WaltTeb/BareTag_Tool_Tracker/PCB/tag/tagconnect/CHECK CAREFULLY AGAINST TAG-CONNECT SPEC AND USE AT YOUR OWN RISK/Ultiboard/Transcode Report.txt

   ---- Transcoding 'C:\Users\neil\Documents\Tag-Connect\Footprint Decals\To Check\Ultiboard\TC2030-MCP-NL - Silkscreen Top.gbr' ----   Sat Aug 06 12:30:12 2011

D10   --> D100
D11   --> D101
D12   --> D102
-----------------------------------------------------------------
