WaltTeb/BareTag_Tool_Tracker/PCB/anchor/footprints/150060RS75000/WL-SMCW_0603.step

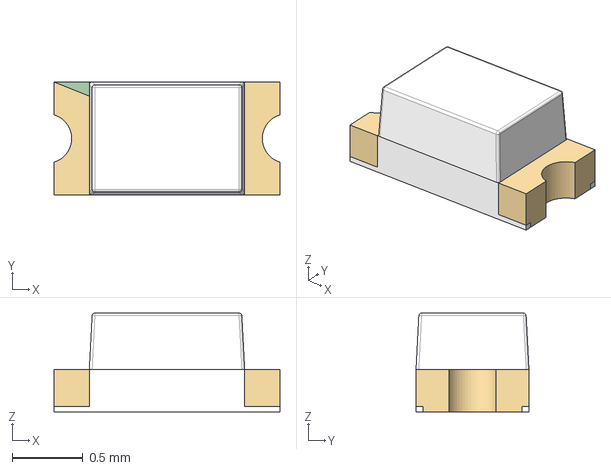
[picture p7: CAD file, 2024-11-17]
PCB/anchor/footprints/150060RS75000/WL-SMCW_0603.step
1.60 x 0.8 x 0.7 mm
