WaltTeb/BareTag_Tool_Tracker/PCB/anchor/footprints/APHBM2012LSURKSYKC/APHBM2012.STEP

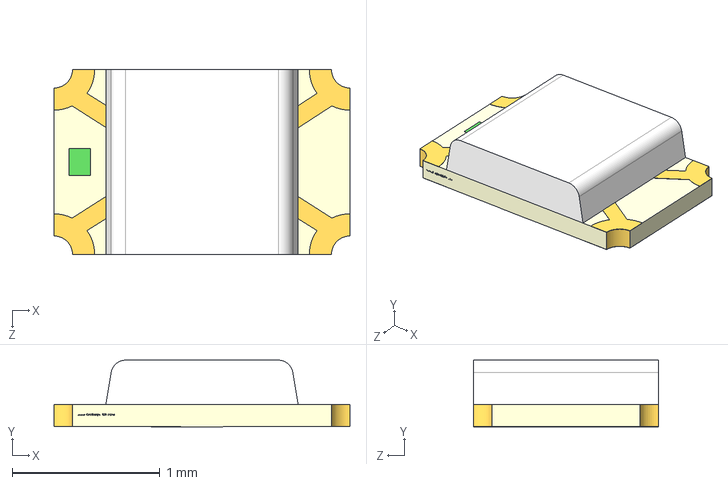
[picture p8: CAD file, 2024-11-17]
PCB/anchor/footprints/APHBM2012LSURKSYKC/APHBM2012.STEP
2.00 x 0.451 x 1.25 mm
