WaltTeb/BareTag_Tool_Tracker/PCB/anchor/footprints/DWM3001C_library/DWM3001C_library/Altium/DWM3001C.step

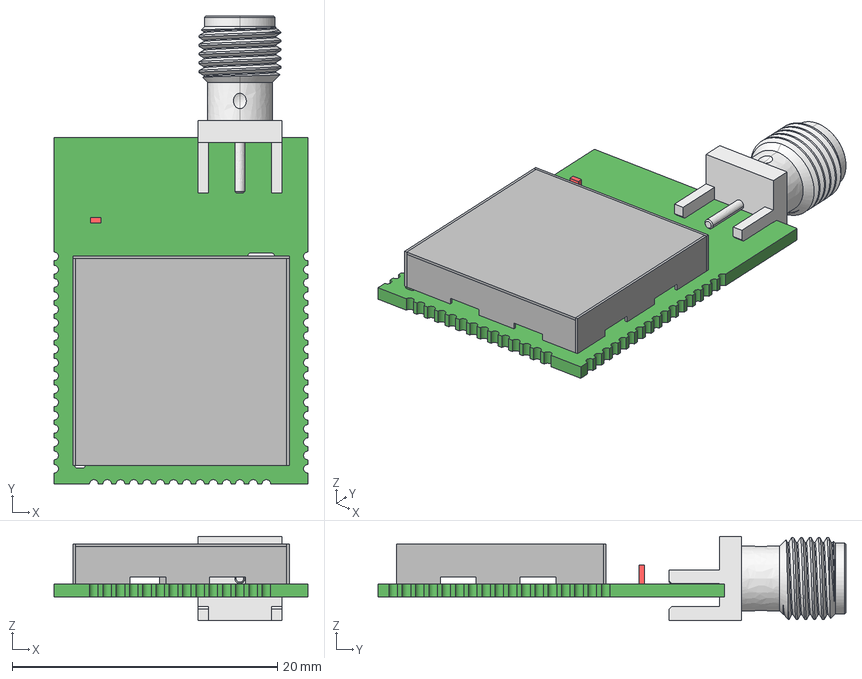
[picture p9: CAD file, 2024-11-17]
PCB/anchor/footprints/DWM3001C_library/DWM3001C_library/Altium/DWM3001C.step
19.1 x 35.3 x 6.35 mm
Open_CASCADE_STEP_translator_6.8_5.1.1.1
DWM3001_shield_RGB8421504
DWM3001_shield_RGB8421505
DWM3001_shield_RGB8421506
DWM3001_shield_RGB8421507
DWM3001_shield_RGB8421508
_32322_3d_model_file
Extruded
