WaltTeb/BareTag_Tool_Tracker/PCB/anchor/footprints/GRM1555C1H470JA01D/GRM1555C1H470JA01D.step

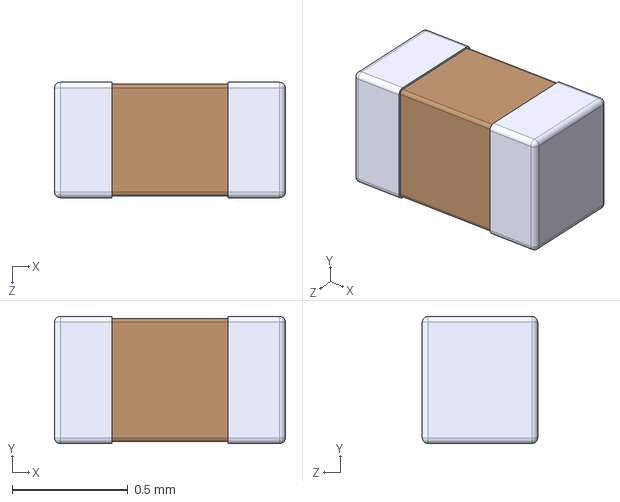
[picture p10: CAD file, 2024-11-17]
PCB/anchor/footprints/GRM1555C1H470JA01D/GRM1555C1H470JA01D.step
1.00 x 0.55 x 0.5 mm
