WaltTeb/BareTag_Tool_Tracker/PCB/anchor/footprints/GRM155R60J106ME05D/GRM155R60J106ME05D.step

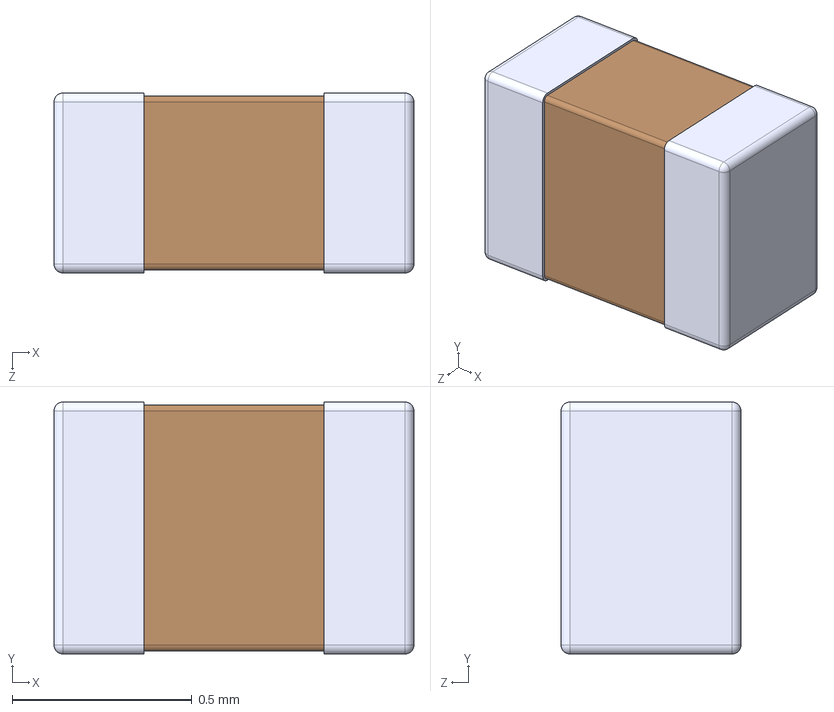
[picture p11: CAD file, 2024-11-17]
PCB/anchor/footprints/GRM155R60J106ME05D/GRM155R60J106ME05D.step
1.00 x 0.7 x 0.5 mm
