WaltTeb/BareTag_Tool_Tracker/PCB/anchor/footprints/RC0402FR_07100KL/RC0402FR-07100KL.step

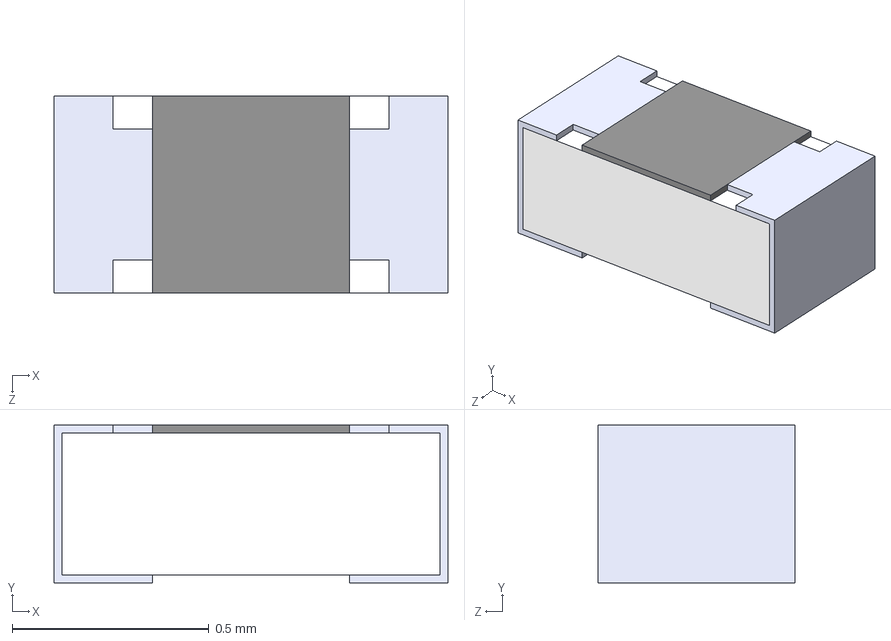
[picture p12: CAD file, 2024-11-17]
PCB/anchor/footprints/RC0402FR_07100KL/RC0402FR-07100KL.step
1 x 0.4 x 0.5 mm
