WaltTeb/BareTag_Tool_Tracker/PCB/anchor/footprints/RK73B1ETTP182J/RK73B1ETTP182J.step

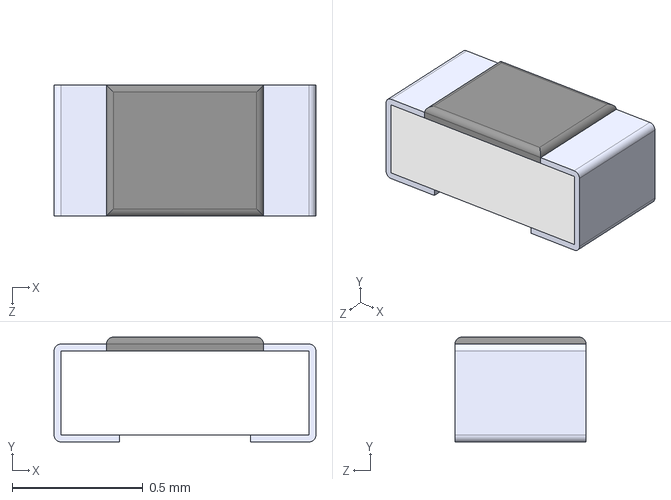
[picture p13: CAD file, 2024-11-17]
PCB/anchor/footprints/RK73B1ETTP182J/RK73B1ETTP182J.step
1.00 x 0.4 x 0.5 mm
