WaltTeb/BareTag_Tool_Tracker/PCB/anchor/footprints/RT0402BRD071K5L/RT0402BRD071K5L.step

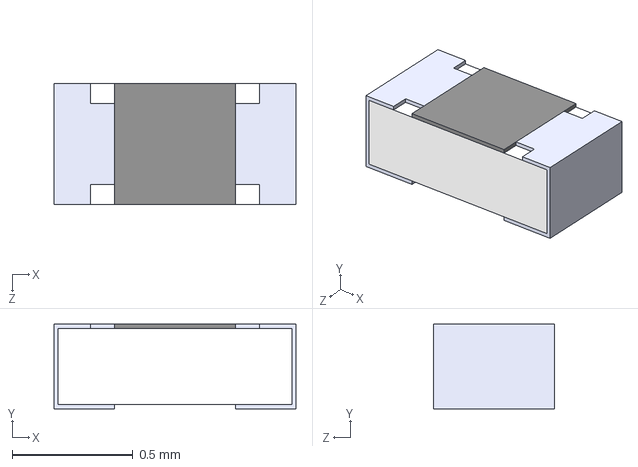
[picture p14: CAD file, 2024-11-17]
PCB/anchor/footprints/RT0402BRD071K5L/RT0402BRD071K5L.step
1 x 0.35 x 0.5 mm
