WaltTeb/BareTag_Tool_Tracker/PCB/anchor/footprints/S2B_PH_SM4_TB/S2B-PH-SM4-TB.step

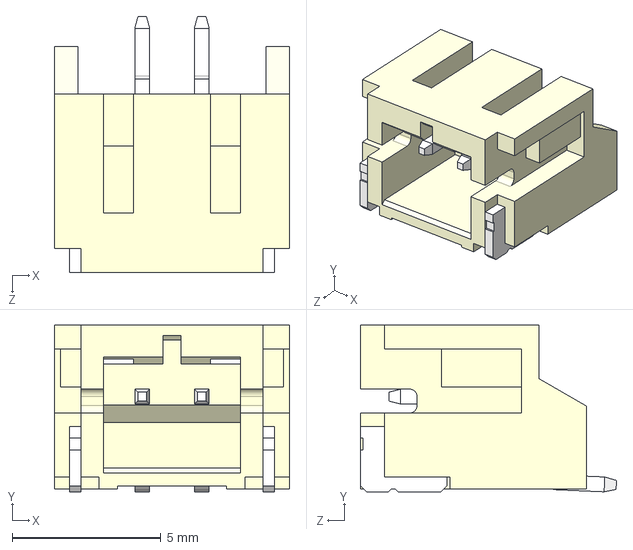
[picture p15: CAD file, 2024-11-17]
PCB/anchor/footprints/S2B_PH_SM4_TB/S2B-PH-SM4-TB.step
7.90 x 5.60 x 8.60 mm
