WaltTeb/BareTag_Tool_Tracker/PCB/anchor/footprints/TL3315NF160Q/TL3315NF160Q.step

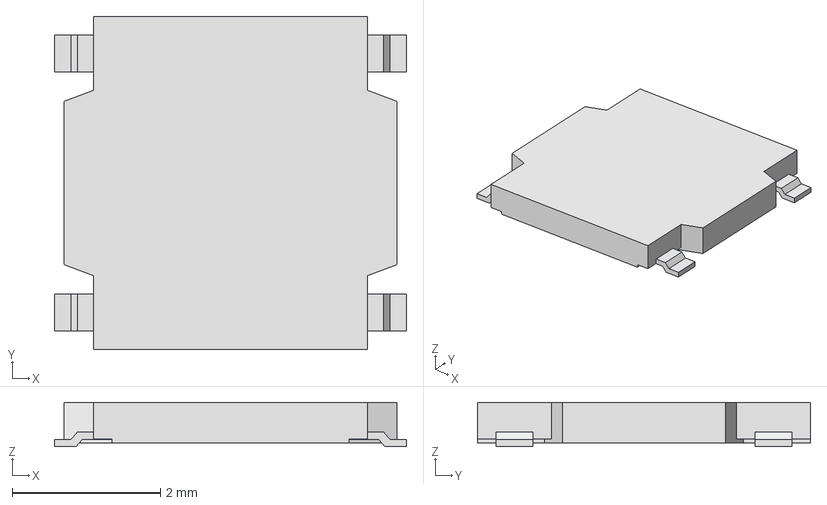
[picture p16: CAD file, 2024-11-17]
PCB/anchor/footprints/TL3315NF160Q/TL3315NF160Q.step
4.75 x 4.50 x 0.6 mm
