WaltTeb/BareTag_Tool_Tracker/PCB/anchor/footprints/TSM_102_01_L_SV/TSM-102-01-X-SV.step

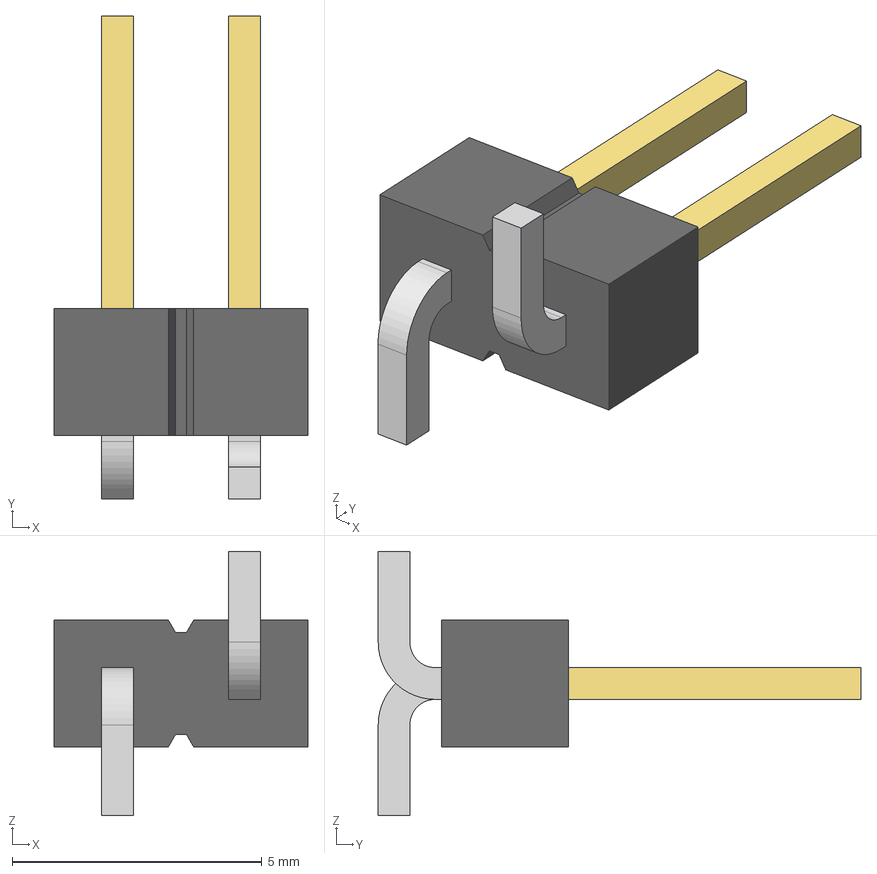
[picture p17: CAD file, 2024-11-17]
PCB/anchor/footprints/TSM_102_01_L_SV/TSM-102-01-X-SV.step
5.08 x 9.65 x 5.28 mm
TSM-102-01-SV_body
T-1S6-16-L(-01-2-SV)
T-1S6-16-L(-01-2-SV)2
