WaltTeb/BareTag_Tool_Tracker/PCB/component_files/KiCADv6/1734028_1/c-1734028-1-c-3d.stp

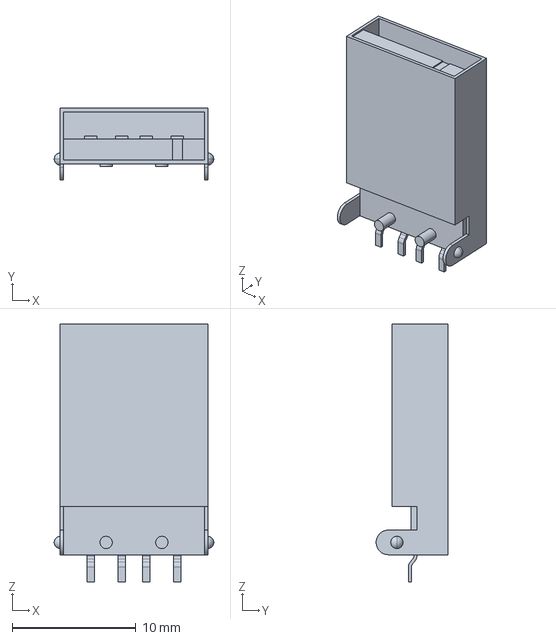
[picture p18: CAD file, 2025-02-01]
PCB/component_files/KiCADv6/1734028_1/c-1734028-1-c-3d.stp
12.9 x 5.80 x 20.9 mm
