WaltTeb/BareTag_Tool_Tracker/PCB/component_files/KiCADv6/RYLR998.stp

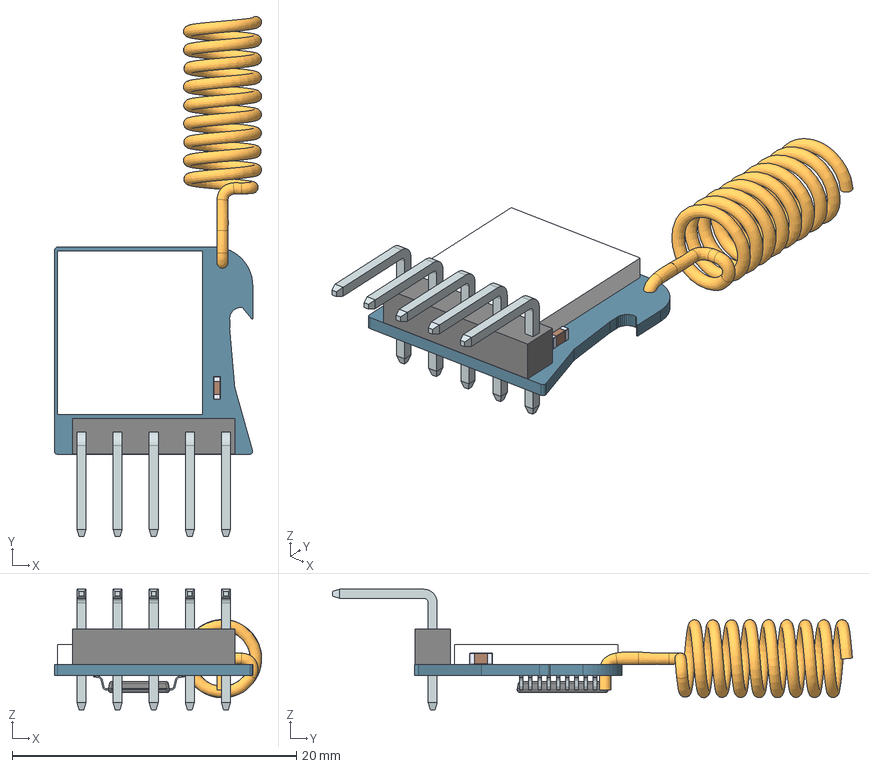
[picture p19: CAD file, 2025-02-01]
PCB/component_files/KiCADv6/RYLR998.stp
14.6 x 36.6 x 8.49 mm
