WaltTeb/BareTag_Tool_Tracker/PCB/tag/LIB_PRT-12807/PRT-12807/3D/PRT-12807.stp

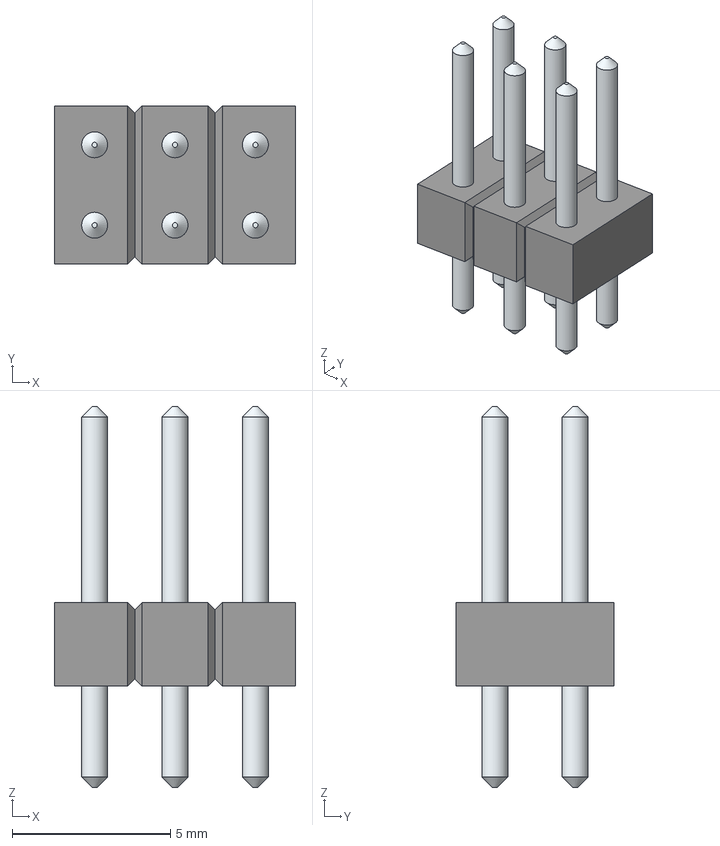
[picture p20: CAD file, 2025-01-01]
PCB/tag/LIB_PRT-12807/PRT-12807/3D/PRT-12807.stp
7.62 x 5.00 x 12.0 mm
LeadsArray
