WaltTeb/BareTag_Tool_Tracker/PCB/tag/LIB_SM02B-SRSS-TB_LF__SN_/SM02B-SRSS-TB_LF__SN_/3D/SM02B-SRSS-TB_LF__SN_.stp

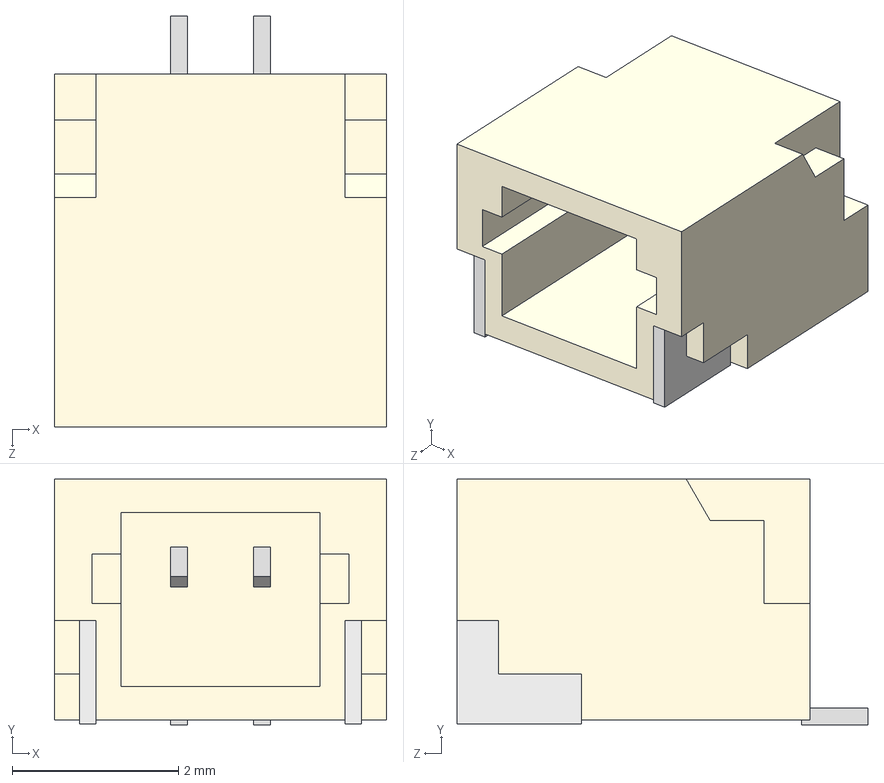
[picture p21: CAD file, 2025-01-01]
PCB/tag/LIB_SM02B-SRSS-TB_LF__SN_/SM02B-SRSS-TB_LF__SN_/3D/SM02B-SRSS-TB_LF__SN_.stp
4.00 x 2.96 x 4.95 mm
