WaltTeb/BareTag_Tool_Tracker/PCB/tag/SM02B-SRSS-TB-LF--SN---3DModel-STEP-56544.STEP

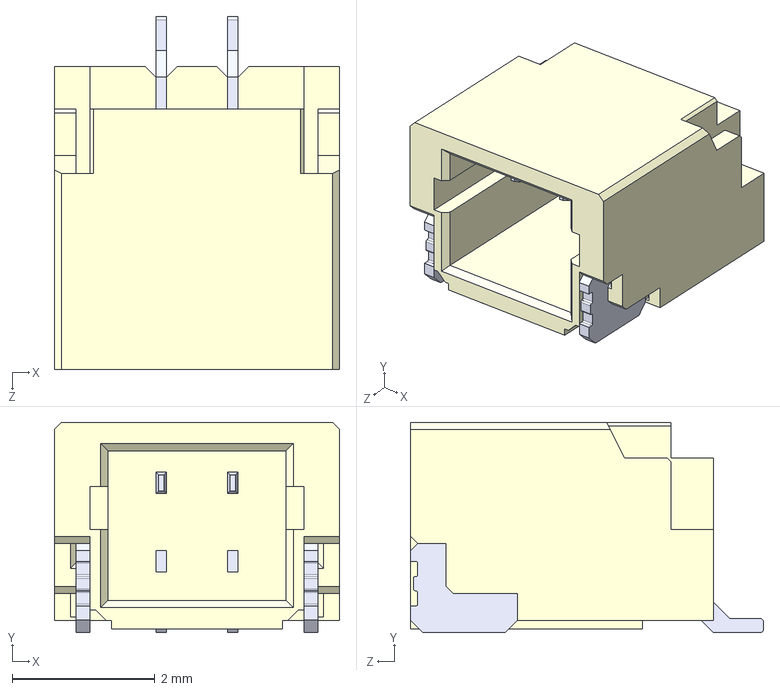
[picture p22: CAD file, 2025-01-01]
PCB/tag/SM02B-SRSS-TB-LF--SN---3DModel-STEP-56544.STEP
4.00 x 2.95 x 4.95 mm
