WaltTeb/BareTag_Tool_Tracker/PCB/component_files/DDC0005A.stp

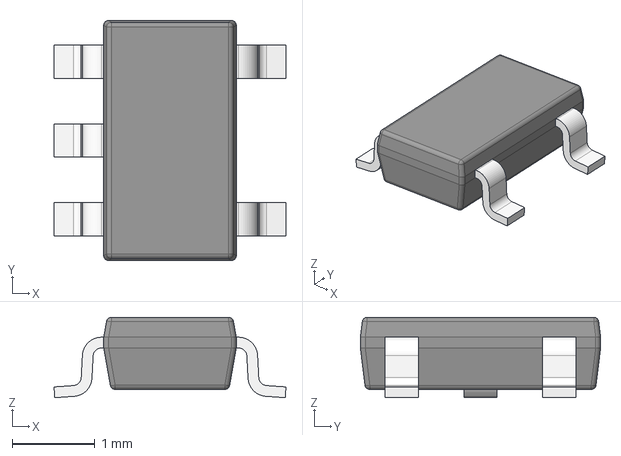
[picture p23: CAD file, 2024-10-23]
PCB/component_files/DDC0005A.stp
2.80 x 2.90 x 0.97 mm
BODY-SOT
LEAD-SOT x 5
