WaltTeb/BareTag_Tool_Tracker/(list of files, cad)

Other CAD files:
PCB/anchor/footprints/RC0402FR_07150RL/RC0402FR-07150RL.step
PCB/anchor/footprints/RC0402FR_07820KL/RC0402FR-07820KL.step
PCB/component_files/GRM155C80J225KE95D.step
PCB/component_files/KiCADv6/DWM3001C.step
PCB/tag/TL3315NFxxxQ.stp
PCB/anchor/footprints/TPS79933DDCR/TPS79933DDCR.step
PCB/component_files/54202-T0804LF.step
PCB/tag/LIB_PRT-12807/PRT-12807/Allegro/hdrv6w82p254_2x3_762x500x884p.psm
PCB/tag/LIB_PRT-12807/PRT-12807/DEHDL/prt_12807/chips/chips.prt
PCB/tag/LIB_SM02B-SRSS-TB_LF__SN_/SM02B-SRSS-TB_LF__SN_/Allegro/sm02bsrsstblfsn.psm
PCB/tag/LIB_SM02B-SRSS-TB_LF__SN_/SM02B-SRSS-TB_LF__SN_/DEHDL/sm02b_srss_tb_lf__sn_/chips/chips.prt
PCB/tag/tagconnect/CHECK CAREFULLY AGAINST TAG-CONNECT SPEC AND USE AT YOUR OWN RISK/Cadence/TC2030_Cadence_PCB Editor/Cadence Orcad PCB Editor/tc2030-mcp-nl.psm
PCB/tag/tagconnect/CHECK CAREFULLY AGAINST TAG-CONNECT SPEC AND USE AT YOUR OWN RISK/Cadence/TC2030_Cadence_PCB Editor/TC2030_Cadence_PCB Editor/tc2030-mcp-nl.psm
PCB/tag/tagconnect/CHECK CAREFULLY AGAINST TAG-CONNECT SPEC AND USE AT YOUR OWN RISK/Cadence/TC2030_Cadence_PCB Editor/TC2030_Cadence_PCB Editor/tc2030-mcp.psm
