WaltTeb/BareTag_Tool_Tracker/PCB/tag/tagconnect/CHECK CAREFULLY AGAINST TAG-CONNECT SPEC AND USE AT YOUR OWN RISK/Labcenter Proteus/Tag-Connect - CADCAM/Tag-Connect - CADCAM Bottom Solder Resist.TXT

G04 PROTEUS RS274X GERBER FILE*
%FSLAX24Y24*%
%MOIN*%
%ADD14C,0.1100*%
%ADD15C,0.0510*%
%ADD13C,0.0000*%
G54D14*
X+0Y+1000D03*
X+0Y-1000D03*
X+1250Y-1000D03*
X+1250Y+1000D03*
G54D15*
X+0Y+0D03*
X+2000Y+400D03*
X+2000Y-400D03*
X-150Y-3400D03*
X+1850Y-3000D03*
X+1850Y-3800D03*
G54D13*
X-1100Y-4990D02*
X+8850Y-4990D01*
X+8850Y+2170D01*
X-1100Y+2170D01*
X-1100Y-4990D01*
M00*
