WaltTeb/BareTag_Tool_Tracker/PCB/tag/tagconnect/CHECK CAREFULLY AGAINST TAG-CONNECT SPEC AND USE AT YOUR OWN RISK/Protel/tag_connect_TC2050/fotprint - CADCAM Top Solder Resist.TXT

G04 PROTEUS RS274X GERBER FILE*
%FSLAX24Y24*%
%MOIN*%
%ADD12C,0.0510*%
G54D12*
X+0Y+0D03*
X+500Y+0D03*
X+1000Y+0D03*
X+1500Y+0D03*
X+2000Y+0D03*
X+0Y-500D03*
X+500Y-500D03*
X+1000Y-500D03*
X+1500Y-500D03*
X+2000Y-500D03*
X+5500Y+0D03*
X+6000Y+0D03*
X+6500Y+0D03*
X+7000Y+0D03*
X+7500Y+0D03*
X+5500Y-500D03*
X+6000Y-500D03*
X+6500Y-500D03*
X+7000Y-500D03*
X+7500Y-500D03*
M00*
