WaltTeb/BareTag_Tool_Tracker/PCB/tag/tagconnect/CHECK CAREFULLY AGAINST TAG-CONNECT SPEC AND USE AT YOUR OWN RISK/Labcenter Proteus/Tag-Connect - CADCAM/Tag-Connect - CADCAM Top Solder Resist.TXT

G04 PROTEUS RS274X GERBER FILE*
%FSLAX24Y24*%
%MOIN*%
%ADD14C,0.1100*%
%ADD15C,0.0510*%
%ADD16C,0.0410*%
%ADD13C,0.0000*%
G54D14*
X+0Y+1000D03*
X+0Y-1000D03*
X+1250Y-1000D03*
X+1250Y+1000D03*
G54D15*
X+0Y+0D03*
X+2000Y+400D03*
X+2000Y-400D03*
G54D16*
X+500Y+250D03*
X+500Y-250D03*
X+1000Y-250D03*
X+1500Y-250D03*
X+1500Y+250D03*
X+1000Y+250D03*
X+5050Y+250D03*
X+5050Y-250D03*
X+5550Y-250D03*
X+6050Y-250D03*
X+6050Y+250D03*
X+5550Y+250D03*
G54D15*
X-150Y-3400D03*
X+1850Y-3000D03*
X+1850Y-3800D03*
G54D16*
X+350Y-3150D03*
X+350Y-3650D03*
X+850Y-3650D03*
X+1350Y-3650D03*
X+1350Y-3150D03*
X+850Y-3150D03*
X+5100Y-3150D03*
X+5100Y-3650D03*
X+5600Y-3650D03*
X+6100Y-3650D03*
X+6100Y-3150D03*
X+5600Y-3150D03*
G54D13*
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
