WaltTeb/BareTag_Tool_Tracker/PCB/tag/tagconnect/CHECK CAREFULLY AGAINST TAG-CONNECT SPEC AND USE AT YOUR OWN RISK/Proteus/Proteus/gerber/freetag - CADCAM Bottom Solder Resist.TXT

G54D15*
X-2000Y-7000D02*
X+14750Y-7000D01*
X+14750Y+3750D01*
X-2000Y+3750D01*
X-2000Y-7000D01*
M00*
