WaltTeb/BareTag_Tool_Tracker/PCB/tag/tagconnect/CHECK CAREFULLY AGAINST TAG-CONNECT SPEC AND USE AT YOUR OWN RISK/Proteus/Proteus/gerber/freetag - CADCAM Top Solder Resist.TXT

G54D11*
X+500Y-250D03*
X+500Y+250D03*
X+1000Y-250D03*
X+1000Y+250D03*
X+1500Y-250D03*
X+1500Y+250D03*
X+500Y-4500D03*
X+500Y-4000D03*
X+1000Y-4500D03*
X+1000Y-4000D03*
X+1500Y-4500D03*
X+1500Y-4000D03*
X+5250Y+750D03*
G54D16*
X+5250Y+2000D03*
X+1250Y+2750D03*
G54D15*
X-2000Y-7000D02*
X+14750Y-7000D01*
X+14750Y+3750D01*
X-2000Y+3750D01*
X-2000Y-7000D01*
X+4250Y-250D02*
X+6750Y-250D01*
X+6750Y+1500D01*
X+4250Y+1500D01*
X+4250Y-250D01*
M00*
