WaltTeb/BareTag_Tool_Tracker/PCB/tag/tagconnect/CHECK CAREFULLY AGAINST TAG-CONNECT SPEC AND USE AT YOUR OWN RISK/Cadence/TC2030_Cadence_PCB Editor/Cadence Orcad PCB Editor/TESTBOARD/LAYOUT.pdf

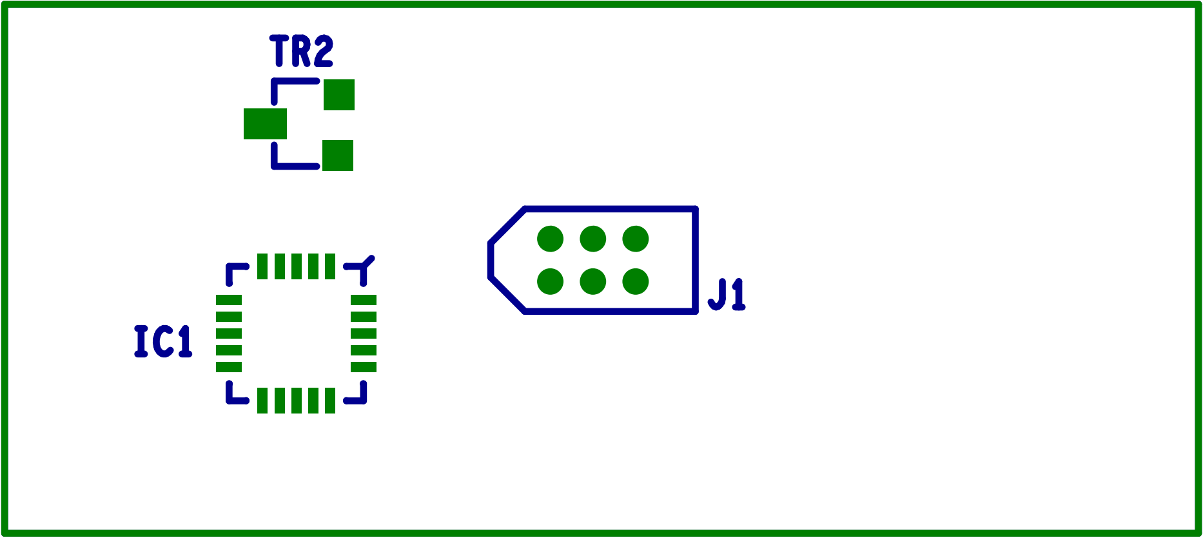
[picture p24: figure]
