WaltTeb/BareTag_Tool_Tracker/PCB/tag/tagconnect/CHECK CAREFULLY AGAINST TAG-CONNECT SPEC AND USE AT YOUR OWN RISK/Cadence/TC2030_Cadence_PCB Editor/Cadence Orcad PCB Editor/readme.txt

This footprint is for Tag Connect TC2030-MCP-NL connector.
For Cadence Orcad PCB Editor 16.2.
From phil@dektron.com
www.dektron.com
24 Aug 2009
