WaltTeb/BareTag_Tool_Tracker/PCB/tag/tagconnect/CHECK CAREFULLY AGAINST TAG-CONNECT SPEC AND USE AT YOUR OWN RISK/Labcenter Proteus/Tag-Connect - CADCAM/Tag-Connect - CADCAM Bottom SMT Paste Mask.TXT

G04 PROTEUS RS274X GERBER FILE*
%FSLAX24Y24*%
%MOIN*%
%ADD13C,0.0000*%
G54D13*
X-1100Y-4990D02*
X+8850Y-4990D01*
X+8850Y+2170D01*
X-1100Y+2170D01*
X-1100Y-4990D01*
M00*
