WaltTeb/BareTag_Tool_Tracker/PCB/tag/tagconnect/CHECK CAREFULLY AGAINST TAG-CONNECT SPEC AND USE AT YOUR OWN RISK/PADS/ReadMe.txt

To import these Decals into PADS:

1. Open the Library Manager.
2. Select the library you want to import to.
3. Select Import... and choose the TC2030-MCP.d file.
