WaltTeb/BareTag_Tool_Tracker/PCB/tag/tagconnect/CHECK CAREFULLY AGAINST TAG-CONNECT SPEC AND USE AT YOUR OWN RISK/Labcenter Proteus/Tag-Connect - CADCAM/Tag-Connect - CADCAM Top Silk Screen.TXT

G04 PROTEUS RS274X GERBER FILE*
%FSLAX24Y24*%
%MOIN*%
%ADD13C,0.0000*%
G54D13*
X-1100Y-4990D02*
X+8850Y-4990D01*
X+8850Y+2170D01*
X-1100Y+2170D01*
X-1100Y-4990D01*
X+1990Y+900D02*
X+1990Y+1260D01*
X+2302Y+1260D01*
X+2365Y+1200D01*
X+2365Y+1140D01*
X+2302Y+1080D01*
X+1990Y+1080D01*
X+2302Y+1080D02*
X+2365Y+1020D01*
X+2365Y+900D01*
X+2865Y+900D02*
X+2490Y+900D01*
X+2490Y+1260D01*
X+2865Y+1260D01*
X+2490Y+1080D02*
X+2740Y+1080D01*
X+2990Y+900D02*
X+2990Y+1260D01*
X+3365Y+1260D01*
X+2990Y+1080D02*
X+3240Y+1080D01*
X+6760Y+930D02*
X+6760Y+1290D01*
X+7072Y+1290D01*
X+7135Y+1230D01*
X+7135Y+1170D01*
X+7072Y+1110D01*
X+6760Y+1110D01*
X+7072Y+1110D02*
X+7135Y+1050D01*
X+7135Y+930D01*
X+7635Y+930D02*
X+7260Y+930D01*
X+7260Y+1290D01*
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
