WaltTeb/BareTag_Tool_Tracker/PCB/tag/tagconnect/CHECK CAREFULLY AGAINST TAG-CONNECT SPEC AND USE AT YOUR OWN RISK/Proteus/Proteus/Exemple/Exemple de modele FREE TAG CONNECT.pdf

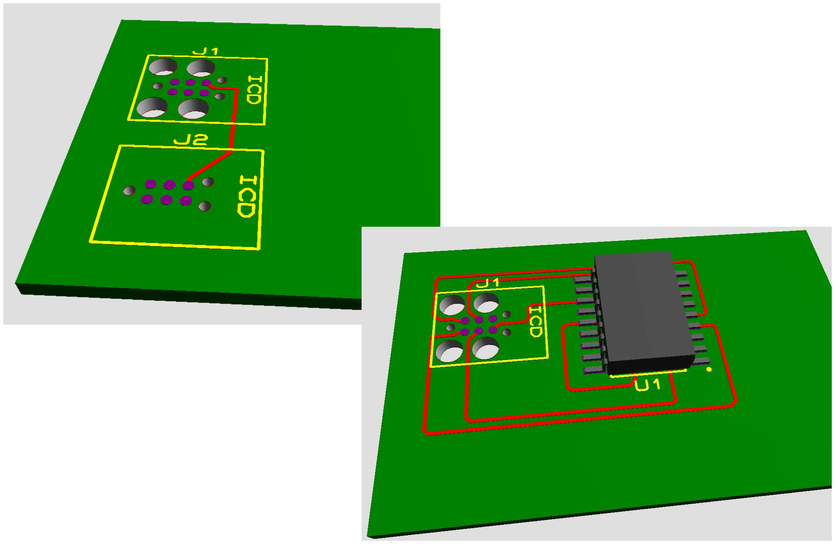
[picture p25: figure]
