WaltTeb/BareTag_Tool_Tracker/PCB/tag/tagconnect/CHECK CAREFULLY AGAINST TAG-CONNECT SPEC AND USE AT YOUR OWN RISK/CADSTAR 14/TC2050-Idosens/TC2050-Idosens/TC2050-NL/VueCadstar TC2050NL.png

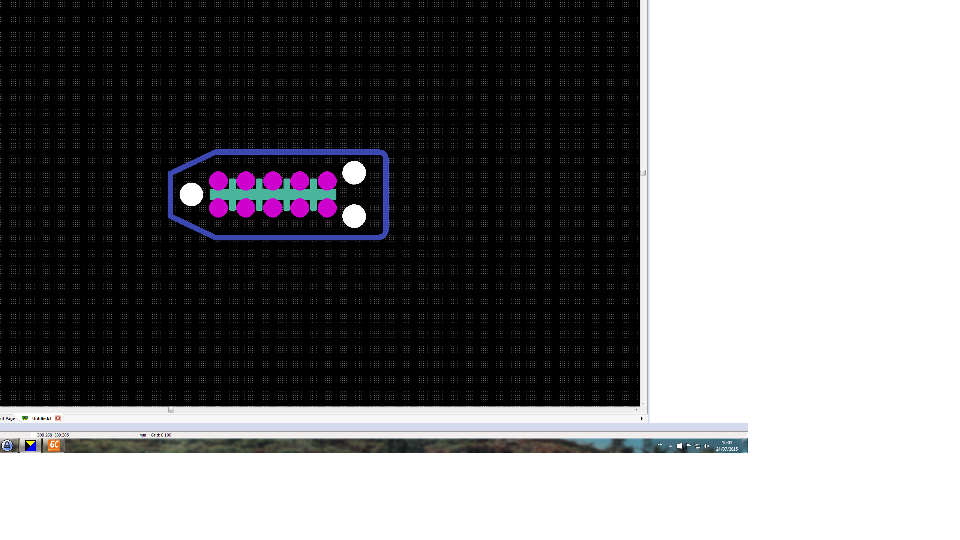
PCB/tag/tagconnect/CHECK CAREFULLY AGAINST TAG-CONNECT SPEC AND USE AT YOUR OWN RISK/CADSTAR 14/TC2050-Idosens/TC2050-Idosens/TC2050-NL/VueCadstar TC2050NL.png
