WaltTeb/BareTag_Tool_Tracker/PCB/tag/tagconnect/CHECK CAREFULLY AGAINST TAG-CONNECT SPEC AND USE AT YOUR OWN RISK/FreePCB/tag_connect.pdf

## TC2030-MCP-NL-ALT

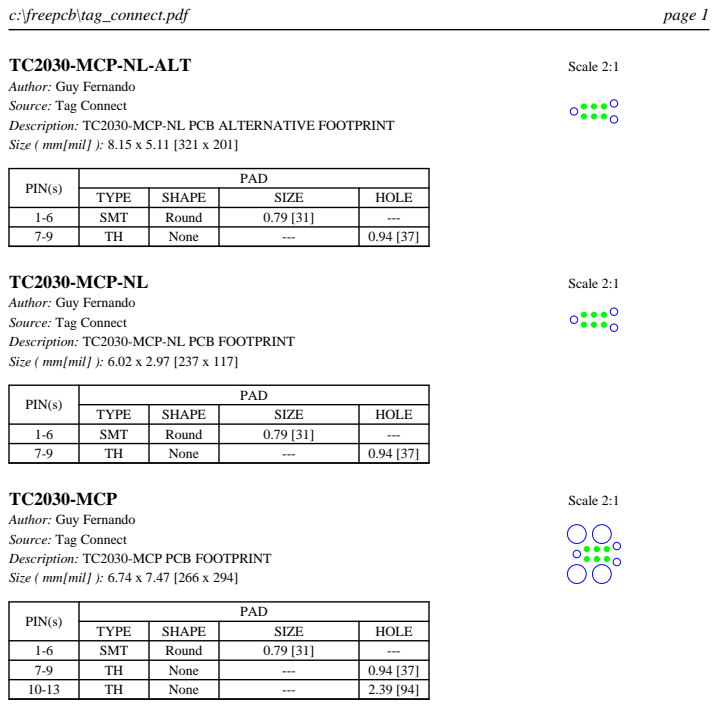
[picture p31: page 1]
c:\freepcb\tag_connect.pdf; page 1; Scale 2:1

Author: Guy Fernando
Source: Tag Connect
Description: TC2030-MCP-NL PCB ALTERNATIVE FOOTPRINT
Size ( mm[mil] ): 8.15 x 5.11 [321 x 201]

PIN(s) | PAD

TYPE | SHAPE | SIZE | HOLE

1-6 | SMT | Round | 0.79 [31] | ---
7-9 | TH | None | --- | 0.94 [37]

TC2030-MCP-NL
Description: TC2030-MCP-NL PCB FOOTPRINT
Size ( mm[mil] ): 6.02 x 2.97 [237 x 117]

TC2030-MCP
Description: TC2030-MCP PCB FOOTPRINT
Size ( mm[mil] ): 6.74 x 7.47 [266 x 294]

10-13 | TH | None | --- | 2.39 [94]
