WaltTeb/BareTag_Tool_Tracker/PCB/anchor/v1pdfs/Back.pdf

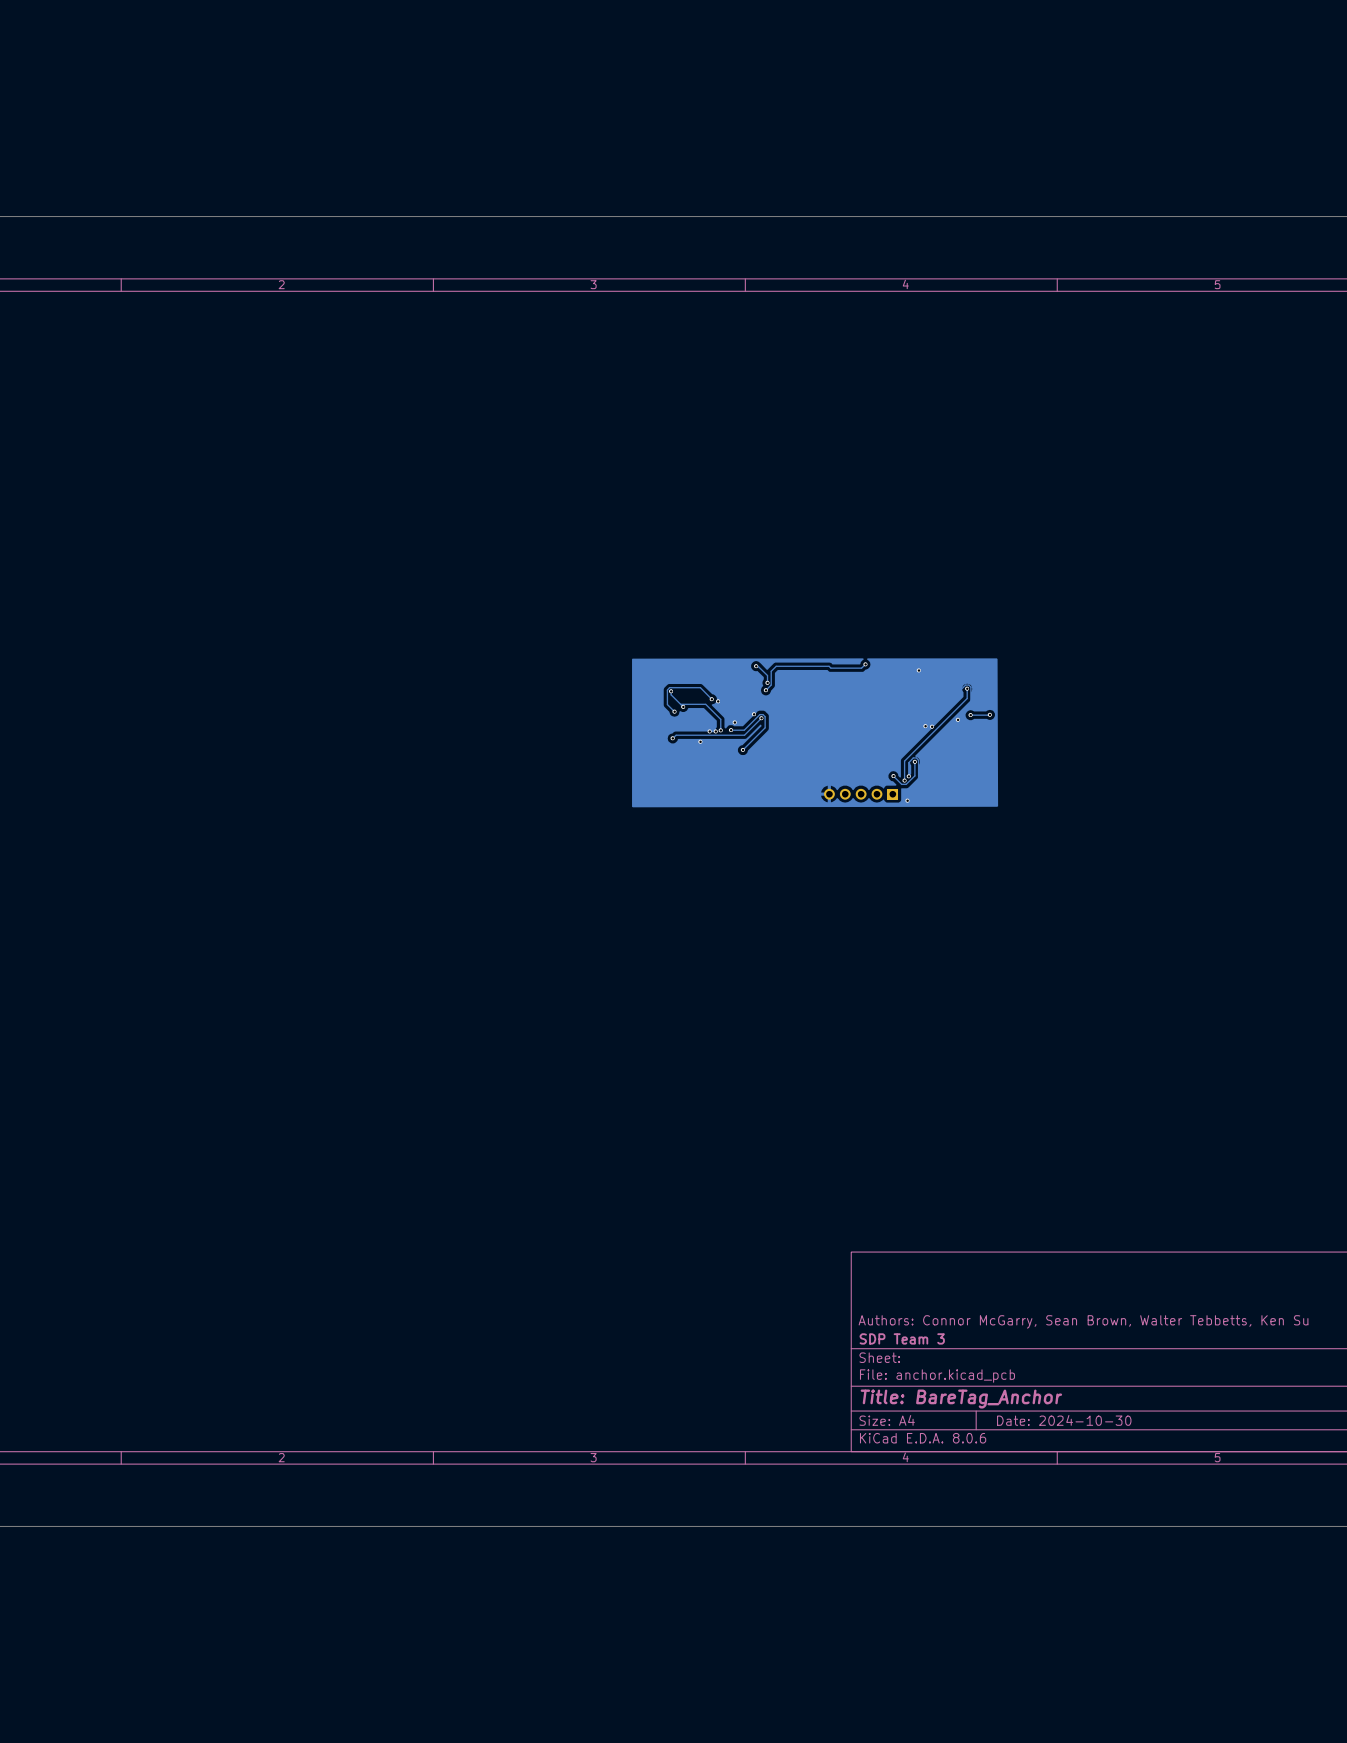
[picture p33: page 1]
