WaltTeb/BareTag_Tool_Tracker/PCB/anchor/v1pdfs/CutOut.pdf

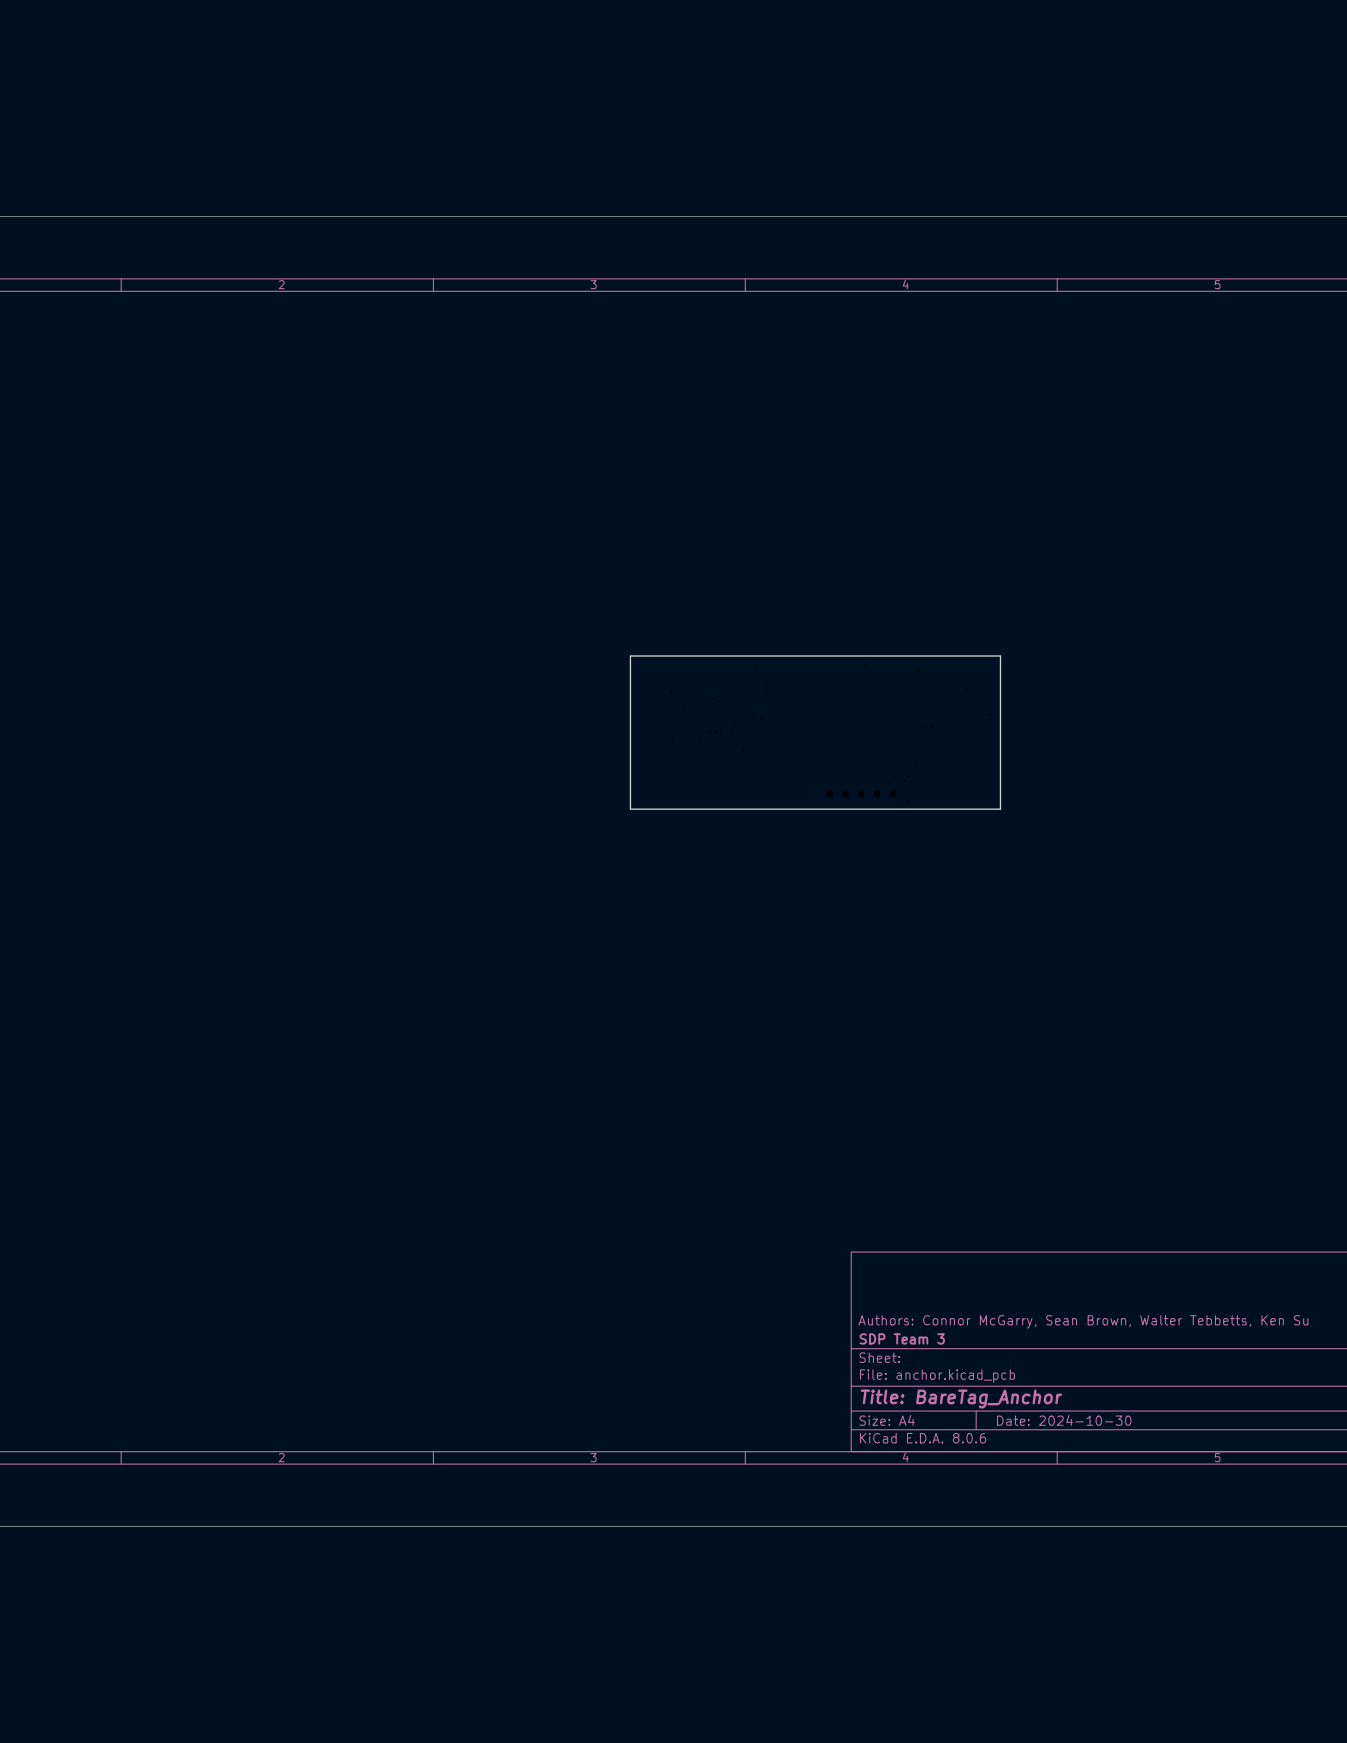
[picture p34: page 1]
