WaltTeb/BareTag_Tool_Tracker/PCB/anchor/v1pdfs/Front&Back.pdf

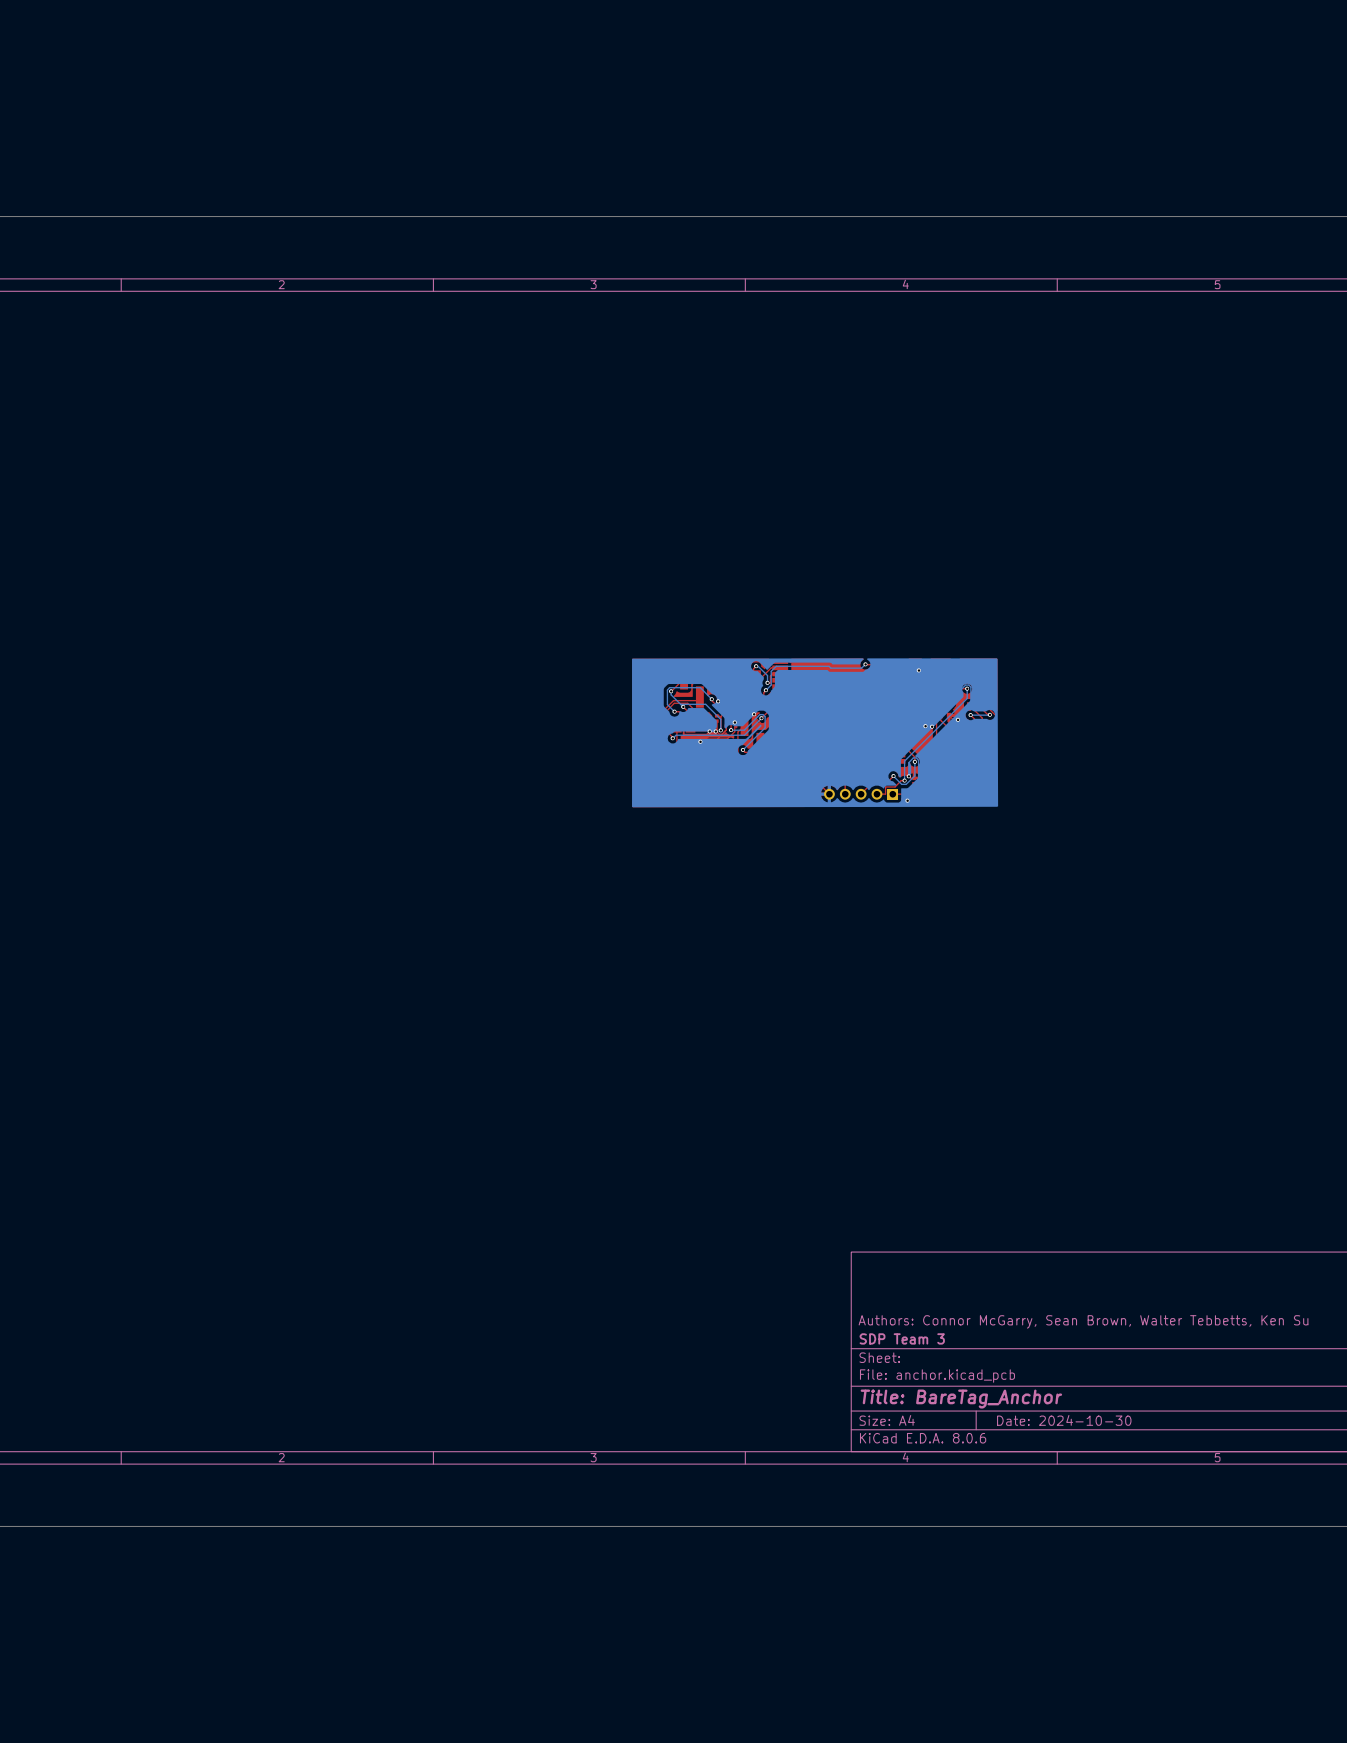
[picture p35: page 1]
