WaltTeb/BareTag_Tool_Tracker/PCB/anchor/v1pdfs/Front.pdf

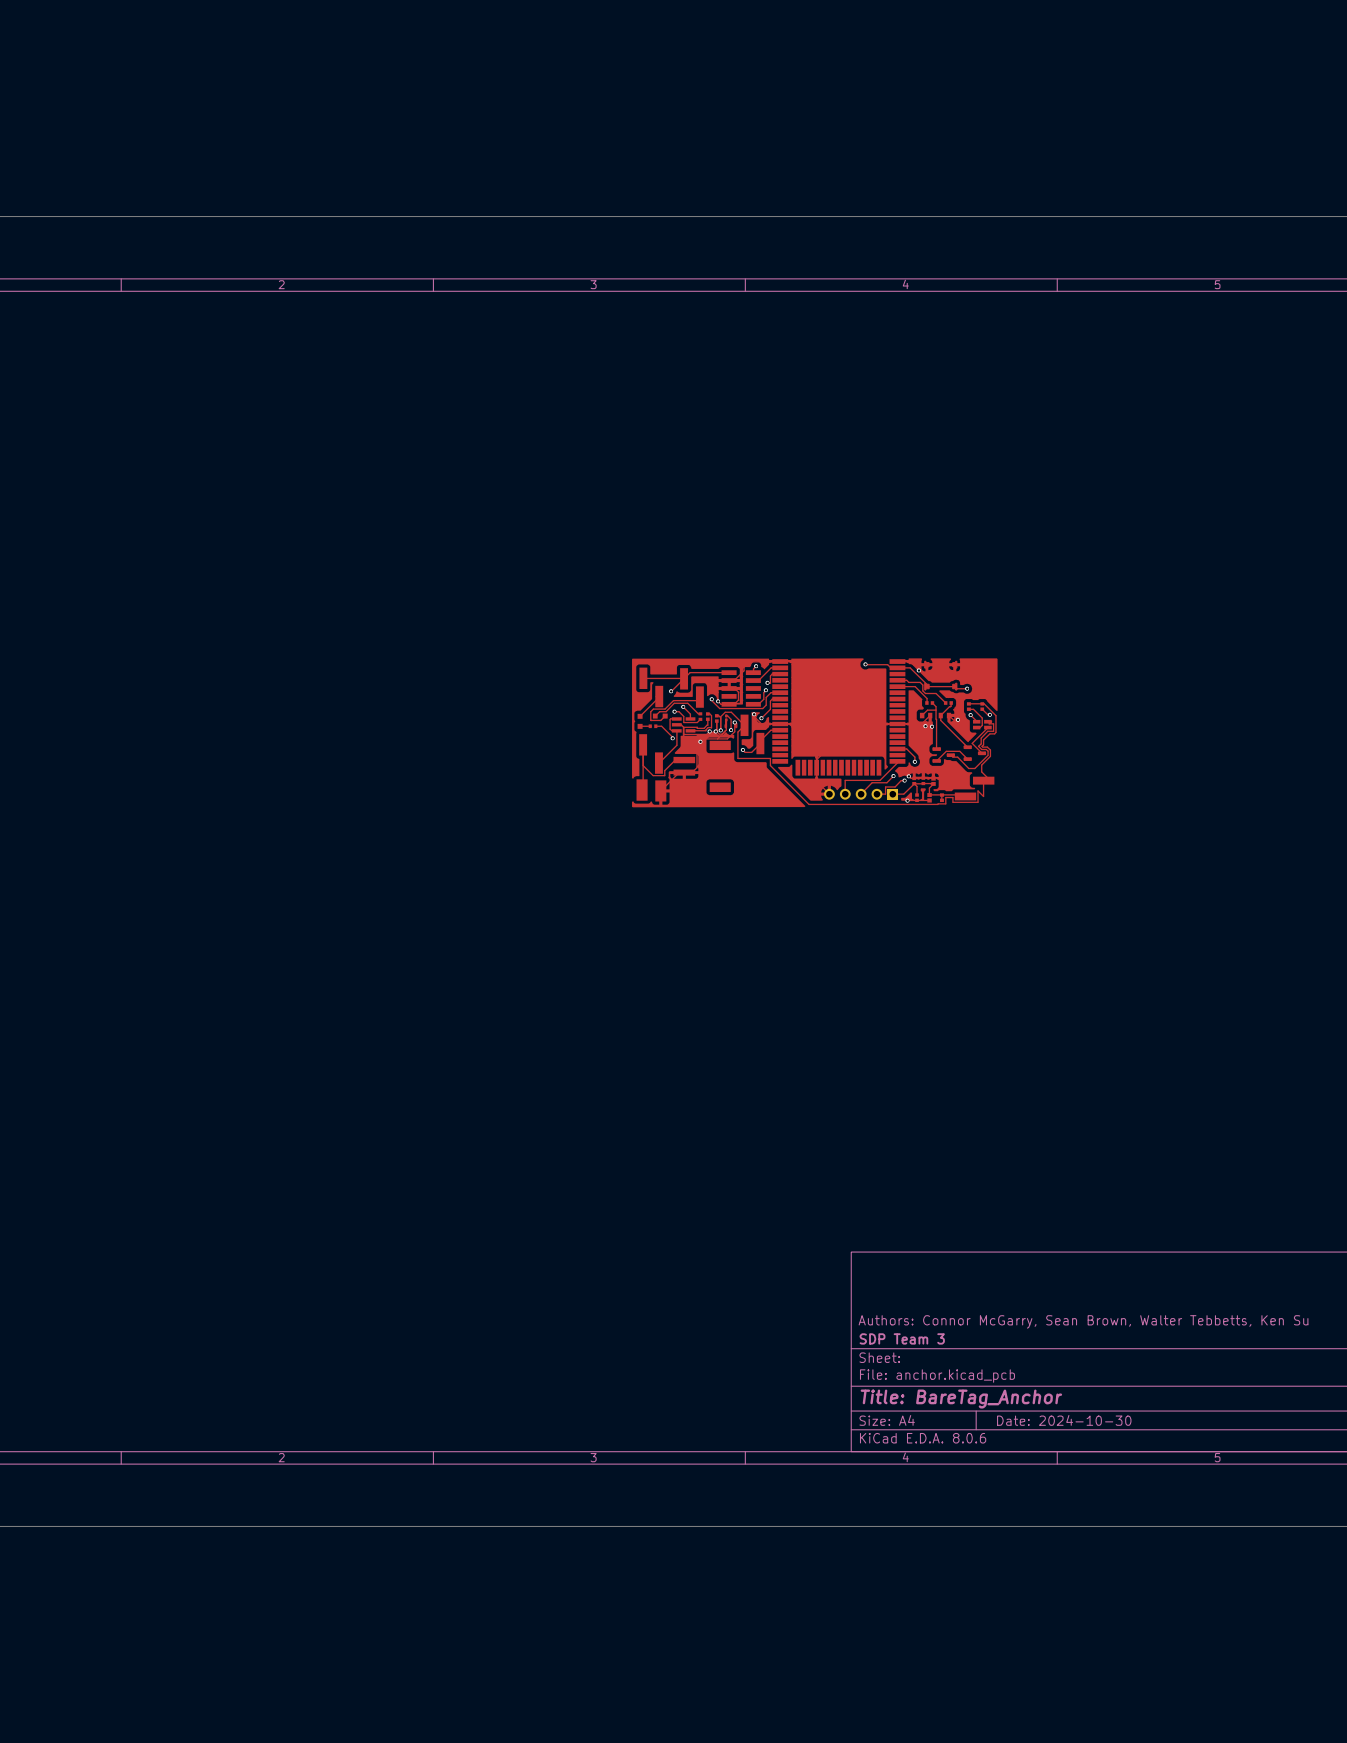
[picture p36: page 1]
