WaltTeb/BareTag_Tool_Tracker/PCB/anchor/v1pdfs/PCBresist.pdf

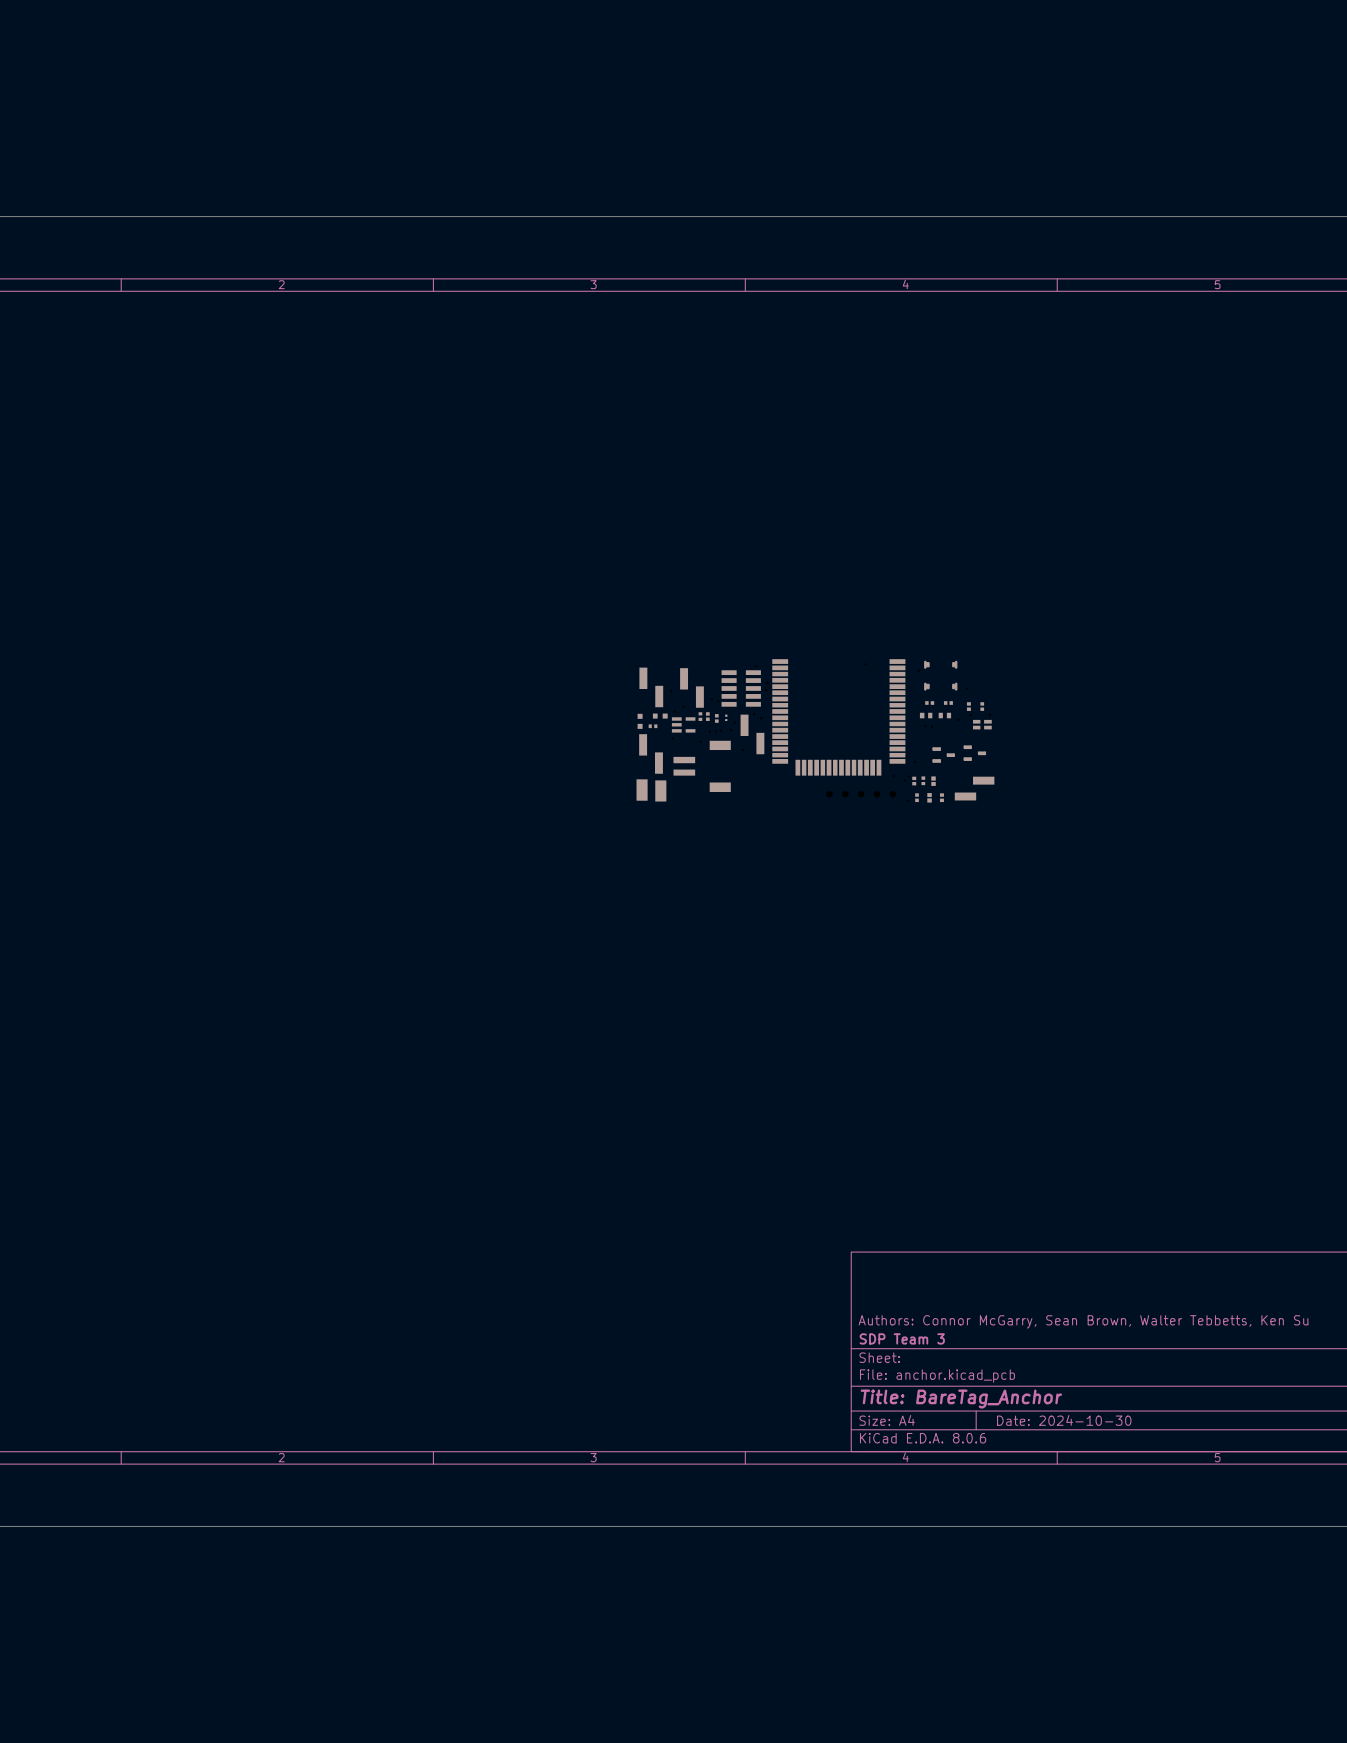
[picture p37: page 1]
