WaltTeb/BareTag_Tool_Tracker/PCB/anchor/v1pdfs/SilkScreen.pdf

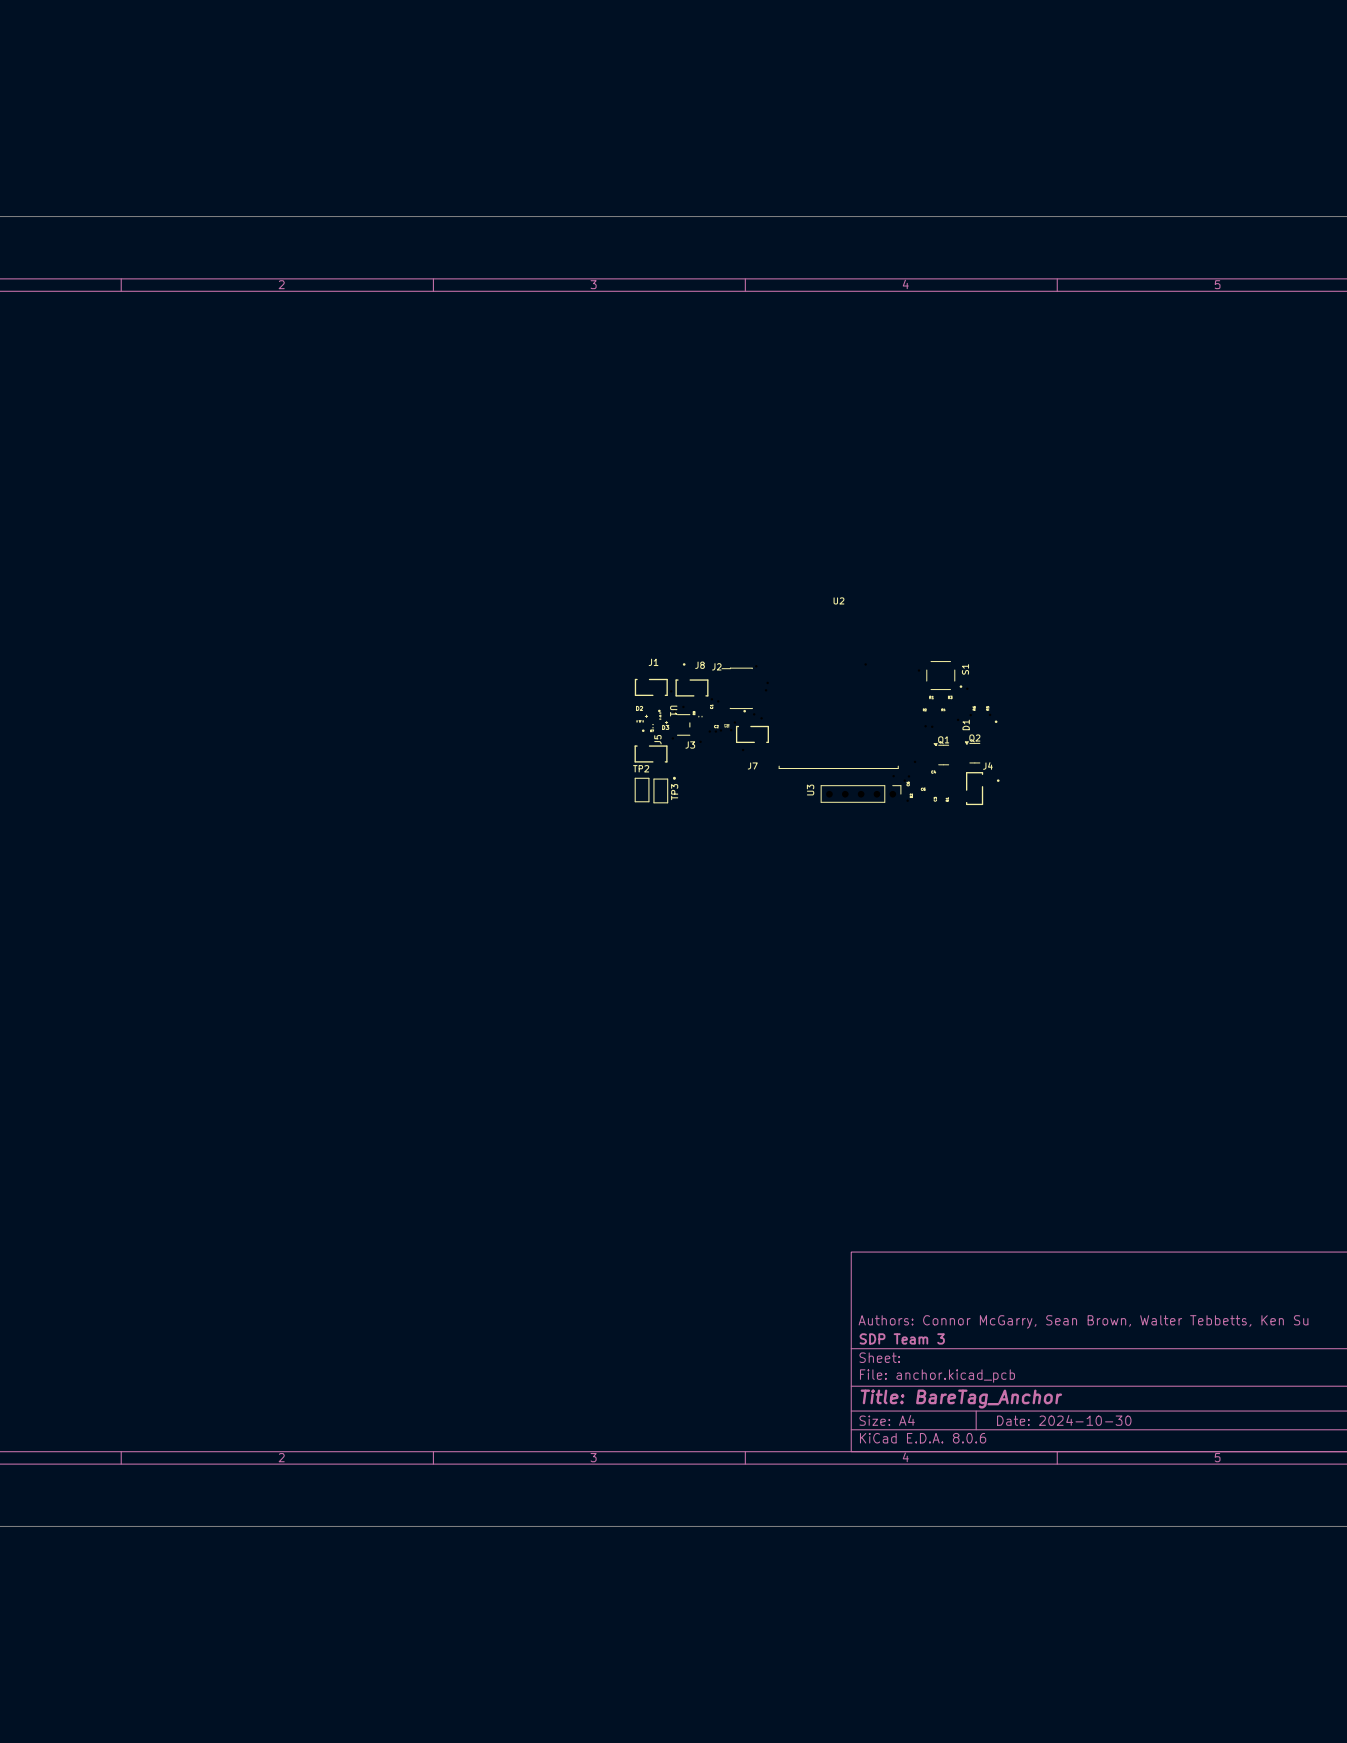
[picture p38: page 1]
