WaltTeb/BareTag_Tool_Tracker/(list of files, drawings)

Other design files:
PCB/tag/LIB_PRT-12807/PRT-12807/Altium/HDRV6W82P254_2X3_762X500X884P.PcbLib
PCB/tag/LIB_PRT-12807/PRT-12807/Altium/PRT-12807.SchLib
PCB/tag/LIB_SM02B-SRSS-TB_LF__SN_/SM02B-SRSS-TB_LF__SN_/Altium/SM02B-SRSS-TB_LF__SN_.SchLib
PCB/tag/LIB_SM02B-SRSS-TB_LF__SN_/SM02B-SRSS-TB_LF__SN_/Altium/SM02BSRSSTBLFSN.PcbLib
PCB/tag/tagconnect/CHECK CAREFULLY AGAINST TAG-CONNECT SPEC AND USE AT YOUR OWN RISK/Altium/Altium (Protel)/TC2030/TC2030.PCB
PCB/tag/tagconnect/CHECK CAREFULLY AGAINST TAG-CONNECT SPEC AND USE AT YOUR OWN RISK/Altium/TagConnect_Altium/TagConnect.PcbLib
PCB/tag/tagconnect/CHECK CAREFULLY AGAINST TAG-CONNECT SPEC AND USE AT YOUR OWN RISK/Altium/TC2050 legged/tc2050.PcbDoc
PCB/tag/tagconnect/CHECK CAREFULLY AGAINST TAG-CONNECT SPEC AND USE AT YOUR OWN RISK/Altium/TC2050 legged/TC2050.PcbLib
PCB/tag/tagconnect/CHECK CAREFULLY AGAINST TAG-CONNECT SPEC AND USE AT YOUR OWN RISK/Altium/TC2050 legged/TC2050.SchLib
PCB/tag/tagconnect/CHECK CAREFULLY AGAINST TAG-CONNECT SPEC AND USE AT YOUR OWN RISK/Altium/tc2050-b/totc/tc2050.PcbLib
PCB/tag/tagconnect/CHECK CAREFULLY AGAINST TAG-CONNECT SPEC AND USE AT YOUR OWN RISK/Altium/tc2050-b/totc/tc2050.PrjPcb
PCB/tag/tagconnect/CHECK CAREFULLY AGAINST TAG-CONNECT SPEC AND USE AT YOUR OWN RISK/Altium/tc2050-b/totc/tc2050.SchLib
PCB/tag/tagconnect/CHECK CAREFULLY AGAINST TAG-CONNECT SPEC AND USE AT YOUR OWN RISK/Altium/TC2050-IDC probably better/TC2050-IDC-09Mar2012.PcbLib
PCB/tag/tagconnect/CHECK CAREFULLY AGAINST TAG-CONNECT SPEC AND USE AT YOUR OWN RISK/Altium/TC2050-IDC probably better/TC2050-IDC-09Mar2012.SchLib
PCB/tag/tagconnect/CHECK CAREFULLY AGAINST TAG-CONNECT SPEC AND USE AT YOUR OWN RISK/Altium/TC2050-IDC/TC2050-IDC/Altium10/demo_pcb/PCB1.PcbDoc
PCB/tag/tagconnect/CHECK CAREFULLY AGAINST TAG-CONNECT SPEC AND USE AT YOUR OWN RISK/Diptrace/TagConnect/TagConnect.dip
PCB/tag/tagconnect/CHECK CAREFULLY AGAINST TAG-CONNECT SPEC AND USE AT YOUR OWN RISK/Easy-PC/TC2030-Demo-Board/TC2030-Demo/TC2030-Demo.pcb
PCB/tag/tagconnect/CHECK CAREFULLY AGAINST TAG-CONNECT SPEC AND USE AT YOUR OWN RISK/gEDA/gEDA/example.pcb
PCB/tag/tagconnect/CHECK CAREFULLY AGAINST TAG-CONNECT SPEC AND USE AT YOUR OWN RISK/OrCAD/TAG-CONNECT.OLB
PCB/tag/tagconnect/CHECK CAREFULLY AGAINST TAG-CONNECT SPEC AND USE AT YOUR OWN RISK/Protel/tag_connect_TC2050/fotprint.LYT
PCB/tag/tagconnect/CHECK CAREFULLY AGAINST TAG-CONNECT SPEC AND USE AT YOUR OWN RISK/Proteus/Proteus/Exemple/freetag.DSN
PCB/tag/tagconnect/CHECK CAREFULLY AGAINST TAG-CONNECT SPEC AND USE AT YOUR OWN RISK/Proteus/Proteus/Exemple/freetag.LYT
PCB/tag/tagconnect/CHECK CAREFULLY AGAINST TAG-CONNECT SPEC AND USE AT YOUR OWN RISK/Proteus/Proteus/Exemple/freetag_exemple.DSN
PCB/tag/tagconnect/CHECK CAREFULLY AGAINST TAG-CONNECT SPEC AND USE AT YOUR OWN RISK/Proteus/Proteus/Exemple/freetag_exemple.LYT
PCB/tag/tagconnect/CHECK CAREFULLY AGAINST TAG-CONNECT SPEC AND USE AT YOUR OWN RISK/Proteus/Proteus/Exemple/freetagdd.DSN
PCB/tag/tagconnect/CHECK CAREFULLY AGAINST TAG-CONNECT SPEC AND USE AT YOUR OWN RISK/Sprint/TC2030-MCP-NL.LAY
