WaltTeb/BareTag_Tool_Tracker/PCB/donglev1-2025-02-02_151608/donglev1.kicad_pcb

## KiCad design PCB/donglev1-2025-02-02_151608/donglev1.kicad_pcb (2025-02-22)

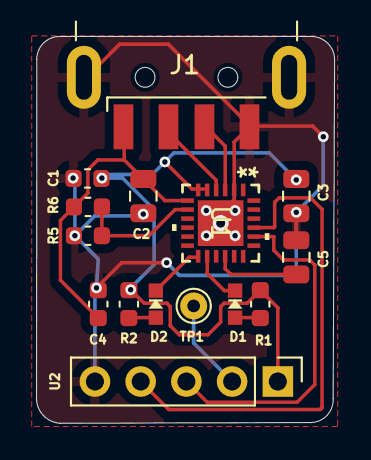
[picture p39: board donglev1.kicad_pcb from above]

Board: 2 copper layers, 16.6 x 21.5 mm, 15 parts (0 on the bottom side), 12 nets.

Parts:
C1, C4: C0603C104J4RACTU; C_0603_1608Metric
C2, C3, C5: C0603C106M9PAC7867; C_0805_2012Metric
D1: D1; CHIPLED_0603_NOOUTLINE
D2: D2; CHIPLED_0603_NOOUTLINE
J1: 1734028-1; USB_A_CNCTech_1001-011-01101_Horizontal
R1, R2, R6: RT0603BRD0720KL; C_0603_1608Metric
R5: RC0603FR-0747KL; C_0603_1608Metric
TP1: TestPoint; TestPoint_THTPad_D1.5mm_Drill0.7mm
U1: CP2102N-24; QFN24_CP2102N_SIL-L
U2: RYLR998; PinHeader_1x05_P2.54mm_Vertical

Connections:
+3.3V: C1.1, C3.1, R1.2, R2.2, U1.5 (VIO), U1.6 (VDD), U2.1
+5V: C2.1, C4.1, J1.1 (VBUS), R6.2, U1.7 (REGIN)
/D+: J1.3 (D+), U1.3 (D+)
/D-: J1.2 (D-), U1.4 (D-)
/RSTL: TP1.1, U2.2
/RX: U1.20 (RXD), U2.3
/TX: U1.21 (TXD), U2.4
/VBUS_DETECT: R5.2, R6.1, U1.8 (VBUS)
GND: C1.2, C2.2, C3.2, C4.2, C5.2, J1.4 (GND), J1.5 (Shield), R5.1, U1.2 (GND), U2.5
unnamed: C5.1, U1.16 (CP2014VREG)
unnamed: D1.C, U1.14 (GPIO0/TXLED)
unnamed: D2.C, U1.13 (GPIO1/RXLED)
