WaltTeb/BareTag_Tool_Tracker/PCB/tag/tagv2/tagv2-2025-02-09_175319/tagv2.kicad_pcb

## KiCad design PCB/tag/tagv2/tagv2-2025-02-09_175319/tagv2.kicad_pcb (2025-02-10)

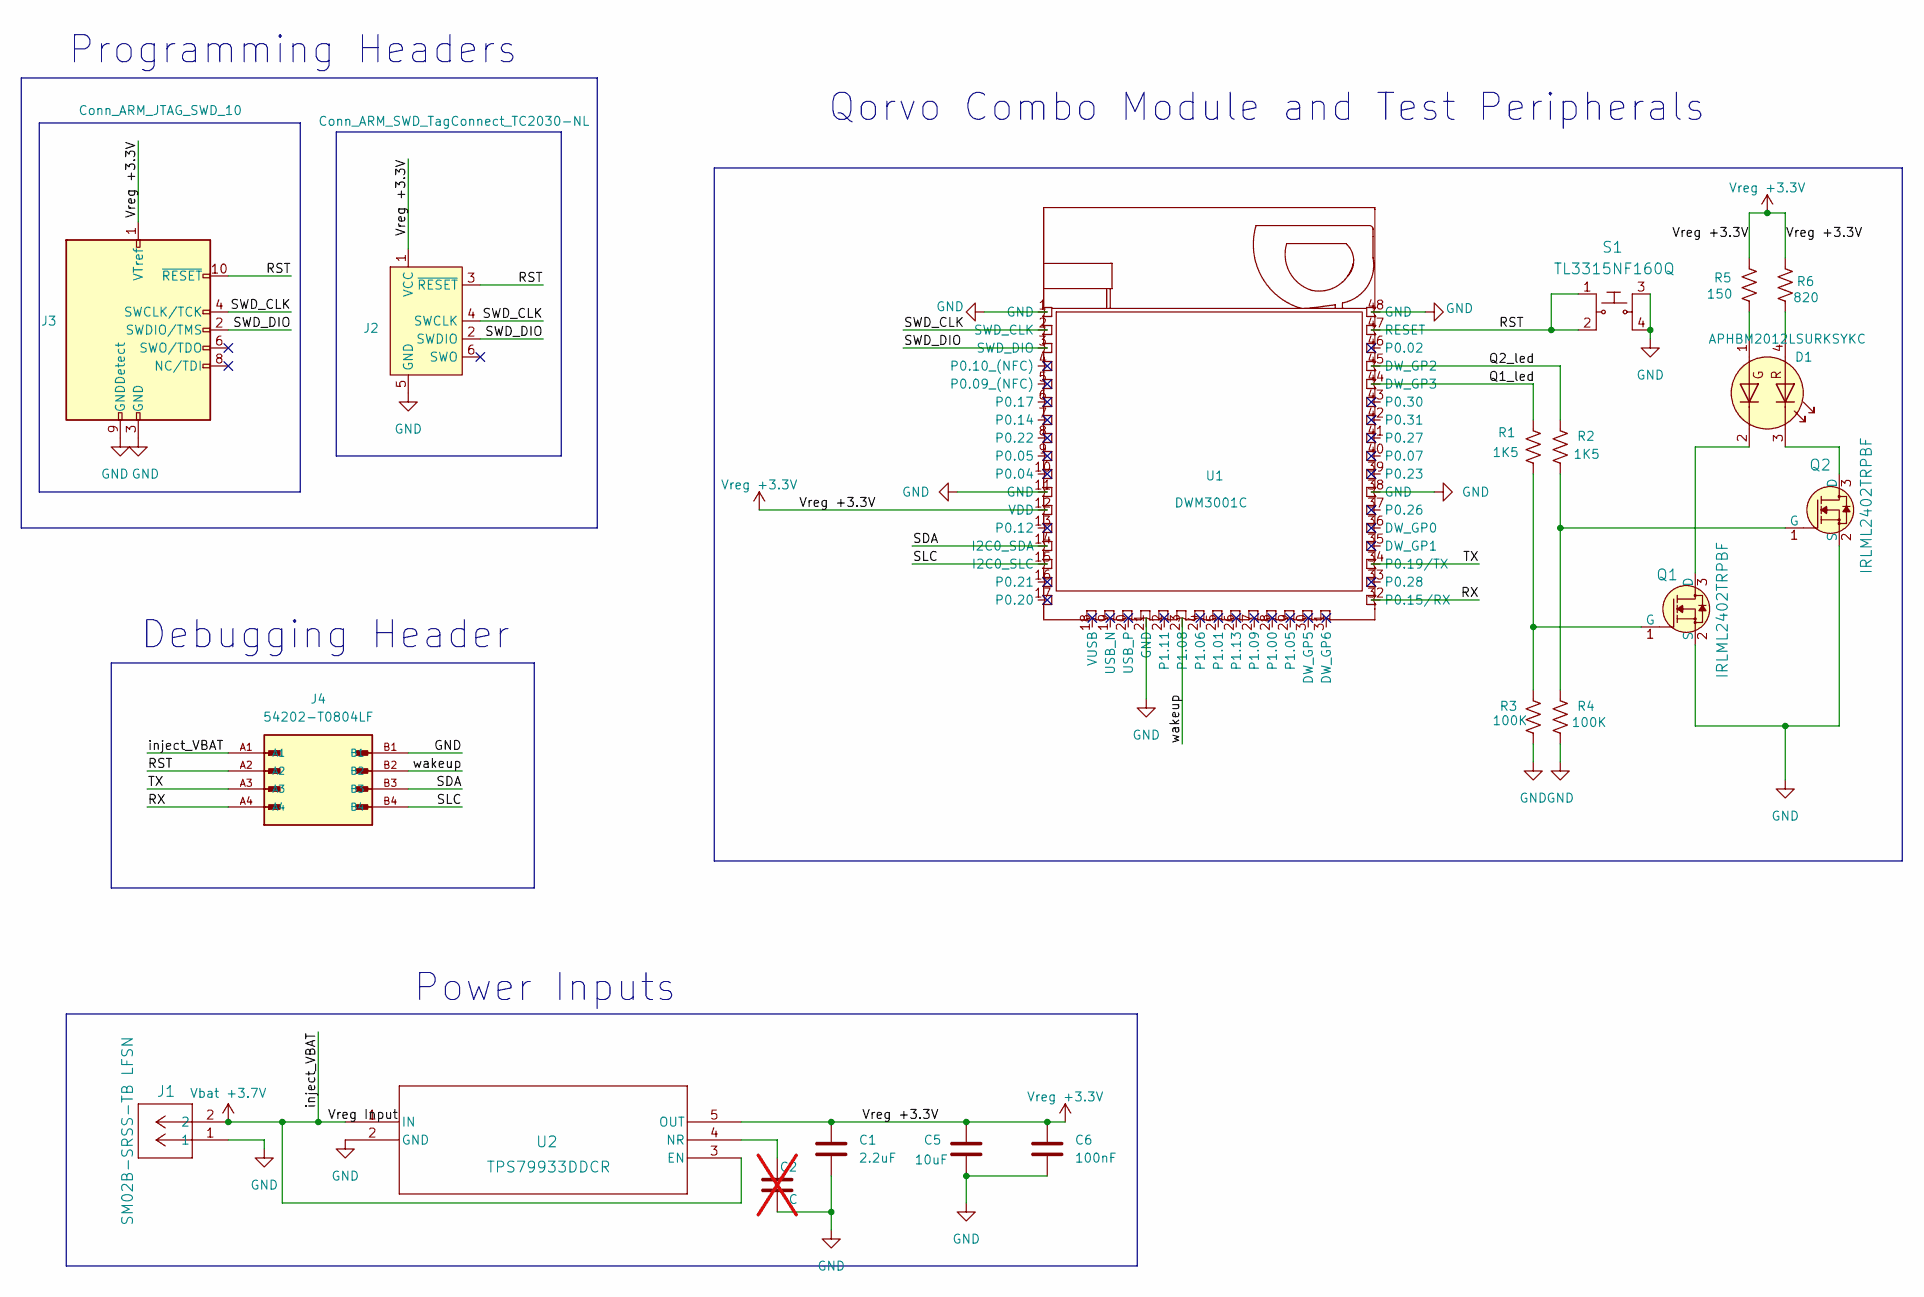
[picture p40: schematic tagv2.kicad_sch, BareTag_Tag]

Parts:
C1: 2.2uF; GRM155C80J225KE95D
C2: C; GRM155C80J225KE95D; not fitted
C5: 10uF; GRM155C80J225KE95D
C6: 100nF; C_0603_1608Metric
D1: APHBM2012LSURKSYKC; LED_APHBM2012LSURKSYKC
J1: SM02B-SRSS-TB LFSN; SM02BSRSSTBLFSN
J2: Conn_ARM_SWD_TagConnect_TC2030-NL
J3: Conn_ARM_JTAG_SWD_10; PinHeader_2x05_P1.27mm_Vertical_SMD
J4: 54202-T0804LF; AMPHENOL_54202-T0804LF; PARTREV AC
Q1, Q2: IRLML2402TRPBF; SOT-23-3; MPN IRLML2402TRPBF; Digi-Key_PN IRLML2402PBFCT-ND
R1, R2: 1K5; R_0402_1005Metric
R3, R4: 100K; R_0402_1005Metric
R5: 150; R_0402_1005Metric
R6: 820; R_0402_1005Metric
S1: TL3315NF160Q; Switch_Tactile_SMD_4.5x4.5mm_TL3315NF160Q; MPN TL3315NF160Q; Digi-Key_PN EG4621CT-ND
U1: DWM3001C
U2: TPS79933DDCR; SOT95P280X110-5N

Connections:
/Q1_led: R1.1, U1.44 (DW_GP3)
/Q2_led: R2.1, U1.45 (DW_GP2)
/RST: J2.3 (~RESET), J3.10 (~RESET), J4.A2, S1.1, S1.2, U1.47 (RESET); also elsewhere on the board
/RX: J4.A4, U1.32 (P0.15/RX); also elsewhere on the board
/SDA: J4.B3, U1.14 (I2C0_SDA); also elsewhere on the board
/SLC: J4.B4, U1.15 (I2C0_SLC); also elsewhere on the board
/SWD_CLK: J2.4 (SWCLK), J3.4 (SWCLK/TCK), U1.2 (SWD_CLK)
/SWD_DIO: J2.2 (SWDIO), J3.2 (SWDIO/TMS), U1.3 (SWD_DIO)
/TX: J4.A3, U1.34 (P0.19/TX); also elsewhere on the board
/wakeup: J4.B2, U1.23 (P1.08); also elsewhere on the board
GND: C1.1, C2.2, C5.2, C6.2, J1.1, J2.5 (GND), J3.3 (GND), J3.5 (GND), J3.9 (GNDDetect), Q1.2 (S), Q2.2 (S), R3.2, R4.2, S1.3, S1.4, U1.1 (GND), U1.11 (GND), U1.21 (GND), U1.38 (GND), U1.48 (GND), U2.2 (GND); also elsewhere on the board
unnamed: D1.4 (A1), R6.2
unnamed: D1.1 (A2), R5.2
unnamed: D1.3 (K1), Q2.3 (D)
unnamed: D1.2 (K2), Q1.3 (D)
unnamed: Q1.1 (G), R1.2, R3.1
unnamed: Q2.1 (G), R2.2, R4.1
unnamed: C2.1, U2.4 (NR)
Vbat +3.7V: J1.2, J4.A1, U2.1 (IN), U2.3 (EN); also elsewhere on the board
Vreg +3.3V: C1.2, C5.1, C6.1, J2.1 (VCC), J3.1 (VTref), R5.1, R6.1, U1.12 (VDD), U2.5 (OUT)

Notes on the sheet:
Qorvo Combo Module and Test Peripherals
Debugging Header
Power Inputs
Programming Headers

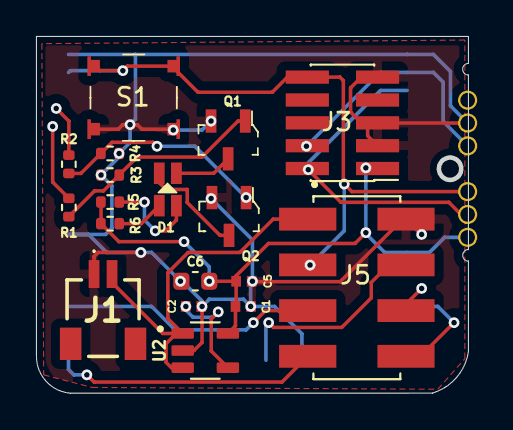
[picture p41: board tagv2.kicad_pcb from above]

Board: 2 copper layers, 24.0 x 19.8 mm, 19 parts (1 on the bottom side), 20 nets.

Other parts of the board:
J5: 54202-T0804LF; AMPHENOL_54202-T0804LF

Their connections:
/RST: J5.A2; also elsewhere on the board
/RX: J5.A4; also elsewhere on the board
/SDA: J5.B3; also elsewhere on the board
/SLC: J5.B4; also elsewhere on the board
/TX: J5.A3; also elsewhere on the board
/wakeup: J5.B2; also elsewhere on the board
GND: J5.B1; also elsewhere on the board
Vbat +3.7V: J5.A1; also elsewhere on the board
