WaltTeb/BareTag_Tool_Tracker/PCB/tag/tag/tag.kicad_pcb

## KiCad design PCB/tag/tag/tag.kicad_pcb (2024-11-17)

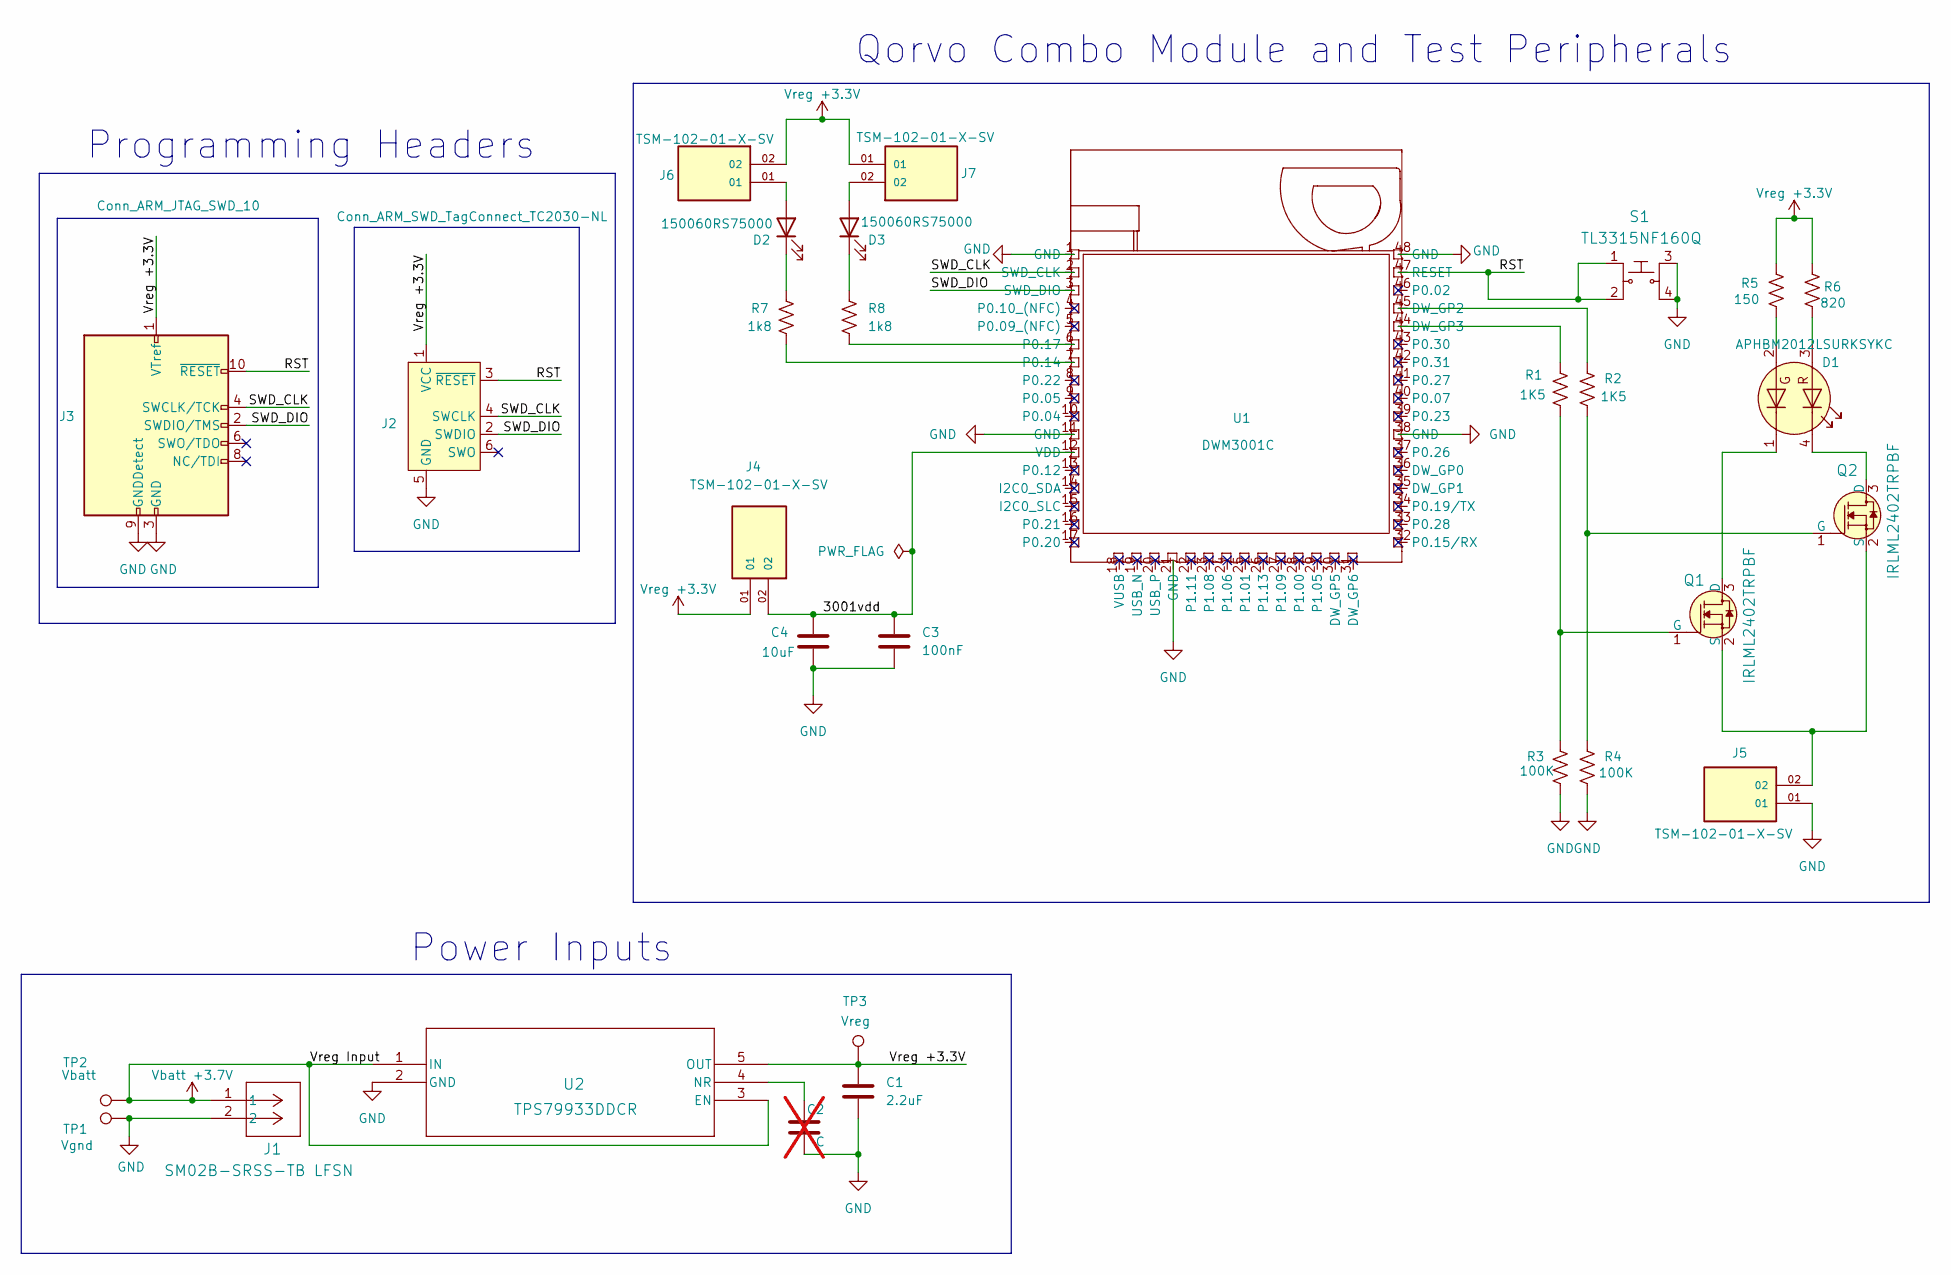
[picture p42: schematic tag.kicad_sch, BareTag_Tag]

Parts:
C1: 2.2uF; GRM155C80J225KE95D
C2: C; GRM155C80J225KE95D; not fitted
C3: 100nF; C_0603_1608Metric
C4: 10uF; GRM155C80J225KE95D
D1: APHBM2012LSURKSYKC; LED_APHBM2012LSURKSYKC
D2, D3: 150060RS75000; WL-SMCW_0603
J1: SM02B-SRSS-TB LFSN; CONN_SM02B-SRSS-TB_JST
J2: Conn_ARM_SWD_TagConnect_TC2030-NL
J3: Conn_ARM_JTAG_SWD_10; PinHeader_2x05_P1.27mm_Vertical_SMD
J4, J5, J6, J7: TSM-102-01-X-SV; SAMTEC_TSM-102-01-X-SV; PARTREV D
Q1, Q2: IRLML2402TRPBF; SOT-23-3; MPN IRLML2402TRPBF; Digi-Key_PN IRLML2402PBFCT-ND
R1, R2: 1K5; R_0402_1005Metric
R3, R4: 100K; R_0402_1005Metric
R5: 150; R_0402_1005Metric
R6: 820; R_0402_1005Metric
R7, R8: 1k8; R_0402_1005Metric
S1: TL3315NF160Q; Switch_Tactile_SMD_4.5x4.5mm_TL3315NF160Q; MPN TL3315NF160Q; Digi-Key_PN EG4621CT-ND
TP1: Vgnd; TestPoint_Pad_D1.0mm
TP2: Vbatt; TestPoint_Pad_D1.0mm
TP3: Vreg; TestPoint_Pad_D1.0mm
U1: DWM3001C
U2: TPS79933DDCR; DDC5

Connections:
/3001vdd: C3.1, C4.1, J4.02, U1.12 (VDD)
/RST: J2.3 (~RESET), J3.10 (~RESET), S1.1, S1.2, U1.47 (RESET)
/SWD_CLK: J2.4 (SWCLK), J3.4 (SWCLK/TCK), U1.2 (SWD_CLK)
/SWD_DIO: J2.2 (SWDIO), J3.2 (SWDIO/TMS), U1.3 (SWD_DIO)
GND: C1.1, C2.2, C3.2, C4.2, J1.2, J2.5 (GND), J3.3 (GND), J3.5 (GND), J3.9 (GNDDetect), J5.01, R3.2, R4.2, S1.3, S1.4, TP1.1, U1.1 (GND), U1.11 (GND), U1.21 (GND), U1.38 (GND), U1.48 (GND), U2.2 (GND)
unnamed: D1.3 (A1), R6.2
unnamed: D1.2 (A2), R5.2
unnamed: D1.4 (K1), Q2.3 (D)
unnamed: D1.1 (K2), Q1.3 (D)
unnamed: D2.2 (A), J6.01
unnamed: D2.1 (K), R7.1
unnamed: D3.2 (A), J7.02
unnamed: D3.1 (K), R8.1
unnamed: Q1.1 (G), R1.2, R3.1
unnamed: J5.02, Q1.2 (S), Q2.2 (S)
unnamed: Q2.1 (G), R2.2, R4.1
unnamed: R2.1, U1.45 (DW_GP2)
unnamed: R1.1, U1.44 (DW_GP3)
unnamed: R7.2, U1.7 (P0.14)
unnamed: R8.2, U1.6 (P0.17)
unnamed: C2.1, U2.4 (NR)
Vbatt +3.7V: J1.1, TP2.1, U2.1 (IN), U2.3 (EN)
Vreg +3.3V: C1.2, J2.1 (VCC), J3.1 (VTref), J4.01, J6.02, J7.01, R5.1, R6.1, TP3.1, U2.5 (OUT)

Notes on the sheet:
Qorvo Combo Module and Test Peripherals
Power Inputs
Programming Headers

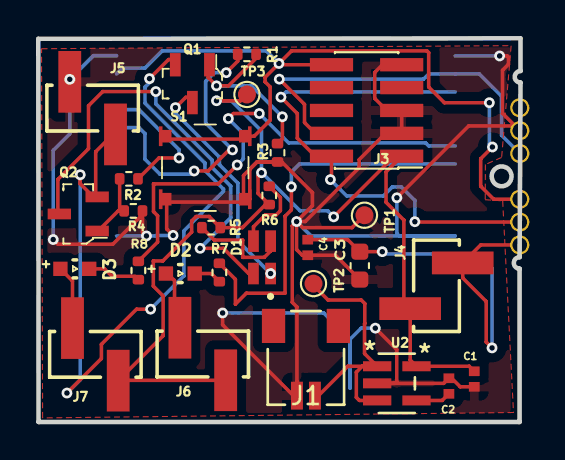
[picture p43: board tag.kicad_pcb from above]

Board: 2 copper layers, 26.8 x 21.3 mm, 29 parts (1 on the bottom side), 23 nets.
