WaltTeb/BareTag_Tool_Tracker/PCB/anchor/anchor.kicad_pcb

## KiCad design PCB/anchor/anchor.kicad_pcb (2024-11-17)

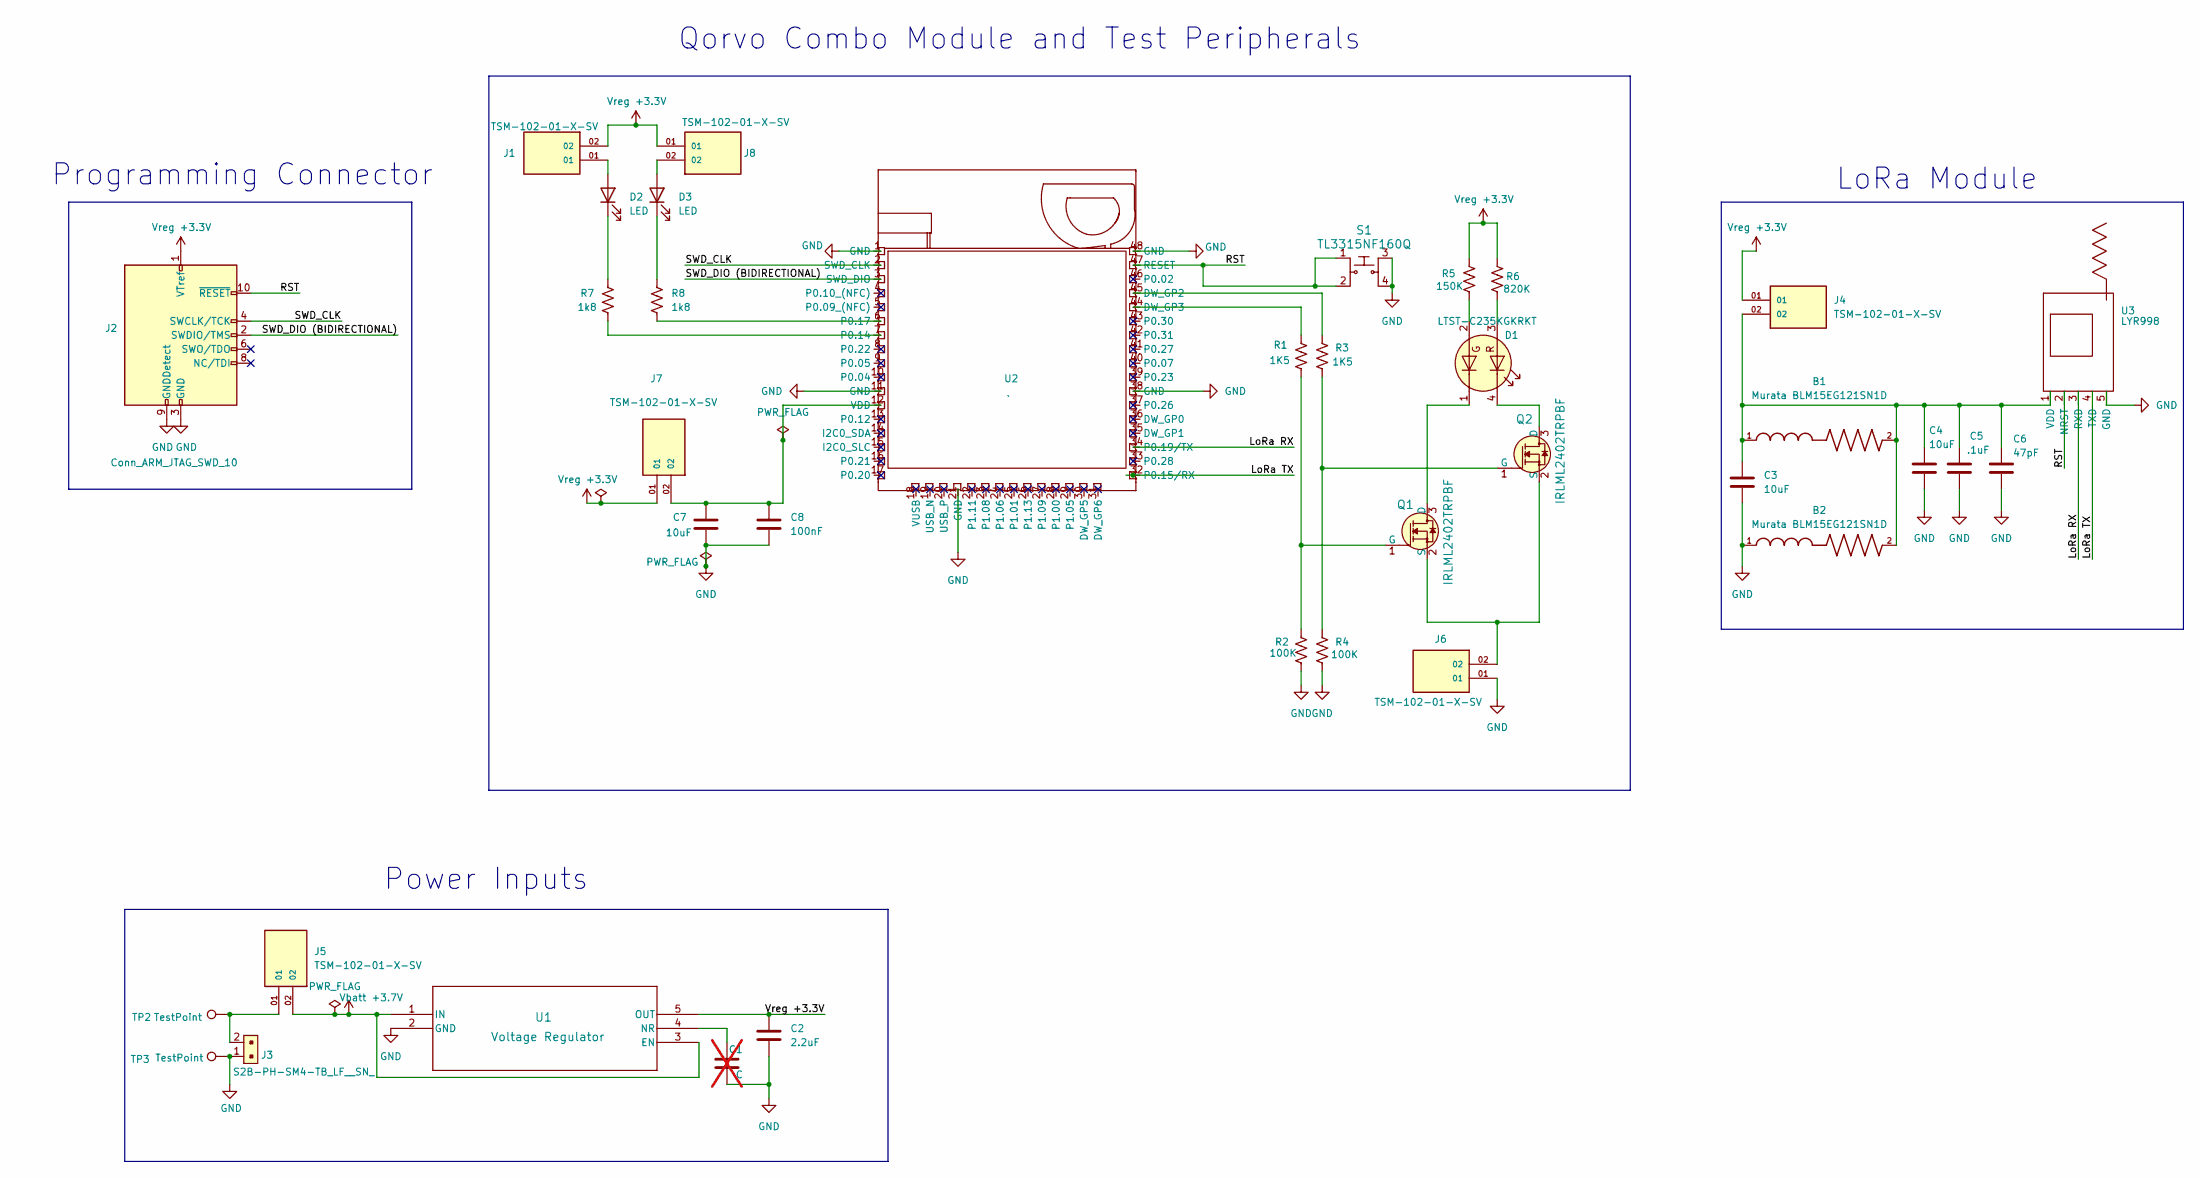
[picture p44: schematic anchor.kicad_sch, BareTag_Anchor]

Parts:
B1, B2: Murata BLM15EG121SN1D; BEADC1005X55N; DigiKey_Part_Number 490-4004-2-ND
C1: C; CAPC1005X55N; not fitted
C2: 2.2uF; CAPC1005X55N
C3, C4, C7: 10uF; CAPC1005X70N
C5: .1uF; CAPC1005X55N
C6: 47pF; CAPC1005X55N
C8: 100nF; C_0201_0603Metric
D1: LTST-C235KGKRKT; LED_APHBM2012LSURKSYKC
D2, D3: LED; WL-SMCW_0603
J1, J4, J5, J6, J7, J8: TSM-102-01-X-SV; SAMTEC_TSM-102-01-X-SV; PARTREV D
J2: Conn_ARM_JTAG_SWD_10; PinHeader_2x05_P1.27mm_Vertical_SMD
J3: S2B-PH-SM4-TB_LF__SN_; JST_S2B-PH-SM4-TB; MPN S2B-PH-SM4-TB(LF)(SN); Digi-Key_PN 455-1749-1-ND
Q1, Q2: IRLML2402TRPBF; SOT-23-3; MPN IRLML2402TRPBF; Digi-Key_PN IRLML2402PBFCT-ND
R1, R3: 1K5; RESC1005X35N
R2, R4: 100K; RESC1005X40
R5: 150K; RESC1005X40N
R6: 820K; RESC1005X40N
R7, R8: 1k8; RESC1005X40N
S1: TL3315NF160Q; SW_TL3315NF160Q; MPN TL3315NF160Q; Digi-Key_PN EG4621CT-ND
TP2, TP3: TestPoint; TestPoint_Keystone_5015_Micro-Minature
U1: Voltage Regulator; volt_reg
U2: `; DWM3001C
U3: LYR998; PinHeader_1x05_P2.54mm_Vertical

Connections:
/LoRa RX: U2.34 (P0.19/TX), U3.3 (RXD)
/LoRa TX: U2.32 (P0.15/RX), U3.4 (TXD)
/RST: J2.10 (~RESET), S1.1, S1.2, U2.47 (RESET), U3.2 (NRST)
/SWD_CLK: J2.4 (SWCLK/TCK), U2.2 (SWD_CLK)
/SWD_DIO (BIDIRECTIONAL): J2.2 (SWDIO/TMS), U2.3 (SWD_DIO)
GND: B2.1, C1.2, C2.1, C3.2, C4.2, C5.2, C6.2, C7.2, C8.2, J2.3 (GND), J2.5 (GND), J2.9 (GNDDetect), J3.1, J6.01, R2.2, R4.2, S1.3, S1.4, TP3.1, U1.2 (GND), U2.1 (GND), U2.11 (GND), U2.21 (GND), U2.38 (GND), U2.48 (GND), U3.5 (GND)
unnamed: D1.3 (A1), R6.2
unnamed: D1.2 (A2), R5.2
unnamed: D1.4 (K1), Q2.3 (D)
unnamed: D1.1 (K2), Q1.3 (D)
unnamed: D2.2 (A), J1.01
unnamed: D2.1 (K), R7.1
unnamed: D3.2 (A), J8.02
unnamed: D3.1 (K), R8.1
unnamed: J3.2, J5.01, TP2.1
unnamed: Q1.1 (G), R1.2, R2.1
unnamed: J6.02, Q1.2 (S), Q2.2 (S)
unnamed: Q2.1 (G), R3.2, R4.1
unnamed: C1.1, U1.4 (NR)
unnamed: R3.1, U2.45 (DW_GP2)
unnamed: R1.1, U2.44 (DW_GP3)
unnamed: R7.2, U2.7 (P0.14)
unnamed: R8.2, U2.6 (P0.17)
unnamed: C7.1, C8.1, J7.02, U2.12 (VDD)
unnamed: B1.1, B1.2, B2.2, C3.1, C4.1, C5.1, C6.1, J4.02, U3.1 (VDD)
Vbatt +3.7V: J5.02, U1.1 (IN), U1.3 (EN)
Vreg +3.3V: C2.2, J1.02, J2.1 (VTref), J4.01, J7.01, J8.01, R5.1, R6.1, U1.5 (OUT)

Notes on the sheet:
LoRa Module
Power Inputs
Qorvo Combo Module and Test Peripherals
Programming Connector

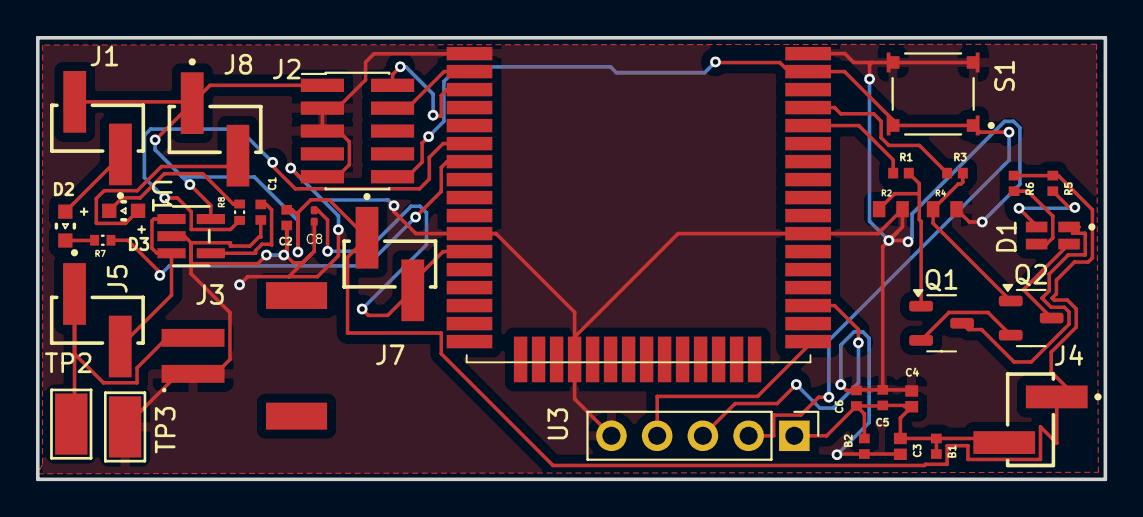
[picture p45: board anchor.kicad_pcb from above]

Board: 2 copper layers, 59.3 x 24.5 mm, 35 parts (0 on the bottom side), 27 nets.
