WaltTeb/BareTag_Tool_Tracker/PCB/tag/tagconnect/CHECK CAREFULLY AGAINST TAG-CONNECT SPEC AND USE AT YOUR OWN RISK/KiCad/allkicad/Tag-Connect_DemoBoard/Tag-Connect_DemoBoard.sch

## KiCad design PCB/tag/tagconnect/CHECK CAREFULLY AGAINST TAG-CONNECT SPEC AND USE AT YOUR OWN RISK/KiCad/allkicad/Tag-Connect_DemoBoard/Tag-Connect_DemoBoard.sch (2024-10-23)

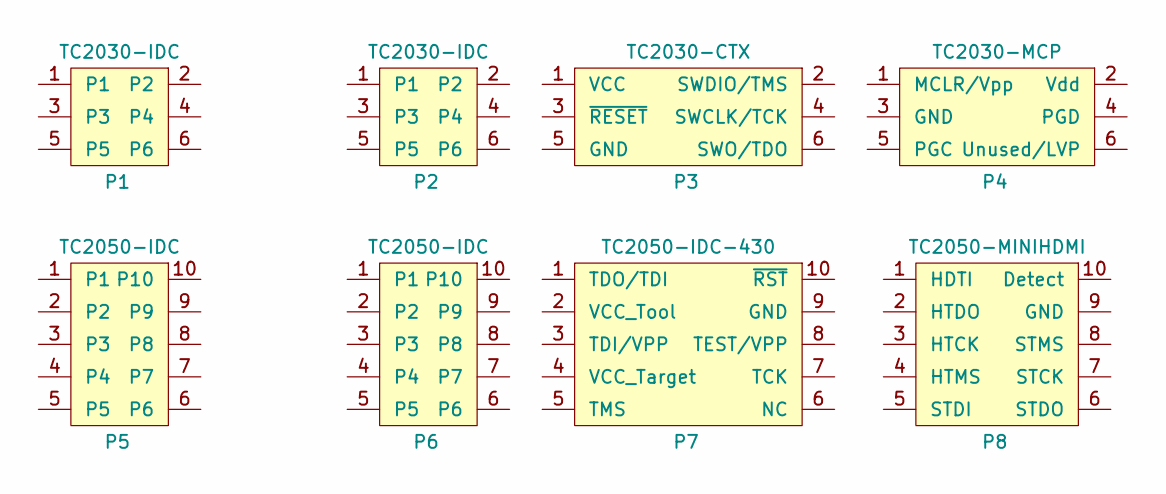
[picture p46: schematic Tag-Connect_DemoBoard.sch]

Parts:
P1, P2: TC2030-IDC
P3: TC2030-CTX
P4: TC2030-MCP
P5, P6: TC2050-IDC
P7: TC2050-IDC-430
P8: TC2050-MINIHDMI
