WaltTeb/BareTag_Tool_Tracker/Updated_Firmware/main.c

/*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
-------------------------- END-OF-HEADER -----------------------------

File    : main.c
Purpose : DWM3001C build main entry point for simple exmaples.

*/

#include <boards.h>
#include <deca_spi.h>
#include <port.h>
#include <sdk_config.h>
#include <stdio.h>
#include <stdlib.h>
#include <assert.h>

/*! ------------------------------------------------------------------------------------------------------------------
 * @fn test_run_info()
 *
 * @brief  This function is simply a printf() call for a string. It is implemented differently on other platforms,
 *         but on the DWM3001C, a printf() call is .
 *
 * @param data - Message data, this data should be NULL string.
 *
 * output parameters
 *
 * no return value
 */
void test_run_info(unsigned char *data)
{
    printf("%s\n", data);
}

int main(void)
{
    /* Initialize all configured peripherals */
    bsp_board_init(BSP_INIT_LEDS | BSP_INIT_BUTTONS);

    /* Initialise DWM3001C GPIOs */
    gpio_init();

    bsp_board_leds_on(); // turn on all single LEDs on the board (the bottom 4)

    /* Initialise the SPI for DWM3001C */
    dwm3001c_spi_init();

    /* Configuring interrupt*/
    dw_irq_init();

    /* Small pause before startup */
    nrf_delay_ms(2);

   
    //extern int ss_twr_responder(void); ss_twr_responder(); // The code we are using to test our Tags

    extern int uart_example(void); uart_example();
    // extern int twr_uart_example(void); twr_uart_example();


    //extern int twi_example(void); twi_example();


    while (1) {}
}
