WaltTeb/BareTag_Tool_Tracker/Updated_Firmware/qorvo_files/dwt_uwb_driver/dw3720/dw3720_device.c

/**
 * @file      dw3720_device.c
 *
 * @brief     Decawave device configuration and control functions
 *
 * @author    Decawave Applications
 *
 * @copyright SPDX-FileCopyrightText: Copyright (c) 2024 Qorvo US, Inc.
 *            SPDX-License-Identifier: LicenseRef-QORVO-2
 *
 */
#include "deca_device_api.h"
#include "deca_interface.h"
#include "deca_types.h"
#include "dw3720_deca_regs.h"
#include "dw3720_deca_vals.h"
#include "deca_version.h"
#include "deca_rsl.h"
#include <assert.h>
#include <stdint.h>
#include <stdlib.h>
#include <stdbool.h>

#define OPTSPEED __attribute__((optimize("O3")))

#if 0
#define DWT_API_ERROR_CHECK  /* API checks config input parameters */
#endif

// -------------------------------------------------------------------------------------------------------------------
// Device Data for DW3720 Transceiver control
//
typedef struct
{
    uint64_t lotID;            // IC Lot ID - read during initialisation
    uint32_t partID;           // IC Part ID - read during initialisation
    uint8_t dgc_otp_set;       // Flag to check if DGC values are programmed in OTP
    uint8_t vBatP;             // IC V bat read during production and stored in OTP (Vmeas @ 3.0V)
    uint8_t tempP;             // IC temp read during production and stored in OTP (Tmeas @ 22C)
    int8_t  temperature;       // Temperature of the chip, if TEMP_INIT (-127) dwt_configure will attempt to measure the temperature using onboard sensor
    uint8_t vdddig_otp;        // Value of VDDDIG in OTP
    uint8_t vdddig_current;    // Value of VDDDIG in AON (currently configured)
    uint8_t longFrames;        // Flag in non-standard long frame mode
    uint8_t otprev;            // OTP revision number (read during initialisation)
    uint8_t init_xtrim;        // initial XTAL trim value read from OTP (or defaulted to mid-range if OTP not programmed)
    uint8_t dblbuffon;         // Double RX buffer mode and DB status flag
    uint8_t channel;           // Current channel the PLL is configured for
    uint16_t sleep_mode;       // Used for automatic reloading of LDO tune and microcode at wake-up
    int16_t ststhreshold;      // Threshold for deciding if received STS is good or bad
    dwt_spi_crc_mode_e spicrc; // Use SPI CRC when this flag is true
    uint8_t stsconfig;         // STS configuration mode
    uint8_t cia_diagnostic;    // CIA diagnostic logging level
    dwt_cb_data_t cbData;      // Callback data structure
    uint8_t sys_cfg_dis_fce_bit_flag; // Cached value of the SYS_CFG_DIS_FCE_BIT in the SYS_CFG_ID register
    dwt_sts_lengths_e stsLength;       // Current STS length
    uint16_t preamble_len;             // Current preamble length
} dwt_local_data_t;

// -------------------------------------------------------------------------------------------------------------------
// Module Macro definitions and enumerations

#define LOCAL_DATA(dw) ((dwt_local_data_t *)((dw)->priv))

/* MACRO wrappers for SPI read/write : should be used only internally to DecaDriver */
#define dwt_write32bitreg(dw, addr, value) dwt_write32bitoffsetreg(dw, addr, 0U, value)
#define dwt_read32bitreg(dw, addr)         dwt_read32bitoffsetreg(dw, addr, 0U)
#define dwt_writefastCMD(dw, cmd)          dwt_read_write_fast_cmd_from_device(dw, cmd, 0U, 0U, NULL, DW3000_SPI_WR_FAST_CMD)
#define dwt_readfastCMD(dw, cmd, data)     dwt_read_write_fast_cmd_from_device(dw, cmd, 0U, 1U, data, DW3000_SPI_RD_FAST_CMD)

#define dwt_or8bitoffsetreg(dw, addr, offset, or_val)              dwt_modify8bitoffsetreg(dw, addr, offset, UINT8_MAX, or_val)
#define dwt_and8bitoffsetreg(dw, addr, offset, and_val)            dwt_modify8bitoffsetreg(dw, addr, offset, and_val, 0U)
#define dwt_and_or8bitoffsetreg(dw, addr, offset, and_val, or_val) dwt_modify8bitoffsetreg(dw, addr, offset, and_val, or_val)
#define dwt_set_bit_num_8bit_reg(dw, addr, bit_num)                dwt_modify8bitoffsetreg(dw, addr, 0U, UINT8_MAX, DWT_BIT_MASK(bit_num))
#define dwt_clr_bit_num_8bit_reg(dw, addr, bit_num)                dwt_modify8bitoffsetreg(dw, addr, 0U, ~DWT_BIT_MASK(bit_num), 0U)

#define dwt_or16bitoffsetreg(dw, addr, offset, or_val)              dwt_modify16bitoffsetreg(dw, addr, offset, UINT16_MAX, or_val)
#define dwt_and16bitoffsetreg(dw, addr, offset, and_val)            dwt_modify16bitoffsetreg(dw, addr, offset, and_val, 0U)
#define dwt_and_or16bitoffsetreg(dw, addr, offset, and_val, or_val) dwt_modify16bitoffsetreg(dw, addr, offset, and_val, or_val)
#define dwt_set_bit_num_16bit_reg(dw, addr, bit_num)                dwt_modify16bitoffsetreg(dw, addr, 0U, UINT16_MAX, DWT_BIT_MASK(bit_num))
#define dwt_clr_bit_num_16bit_reg(dw, addr, bit_num)                dwt_modify16bitoffsetreg(dw, addr, 0U, ~DWT_BIT_MASK(bit_num), 0U)

#define dwt_or32bitoffsetreg(dw, addr, offset, or_val)              dwt_modify32bitoffsetreg(dw, addr, offset, UINT32_MAX, or_val)
#define dwt_and32bitoffsetreg(dw, addr, offset, and_val)            dwt_modify32bitoffsetreg(dw, addr, offset, and_val, 0U)
#define dwt_and_or32bitoffsetreg(dw, addr, offset, and_val, or_val) dwt_modify32bitoffsetreg(dw, addr, offset, and_val, or_val)
#define dwt_set_bit_num_32bit_reg(dw, addr, bit_num)                dwt_modify32bitoffsetreg(dw, addr, 0U, UINT32_MAX, DWT_BIT_MASK(bit_num))
#define dwt_clr_bit_num_32bit_reg(dw, addr, bit_num)                dwt_modify32bitoffsetreg(dw, addr, 0U, ~DWT_BIT_MASK(bit_num), 0U)

// OTP addresses definitions :: See DW3000 Datasheet for calibration parameters OTP addresses
#define LDOTUNELO_ADDRESS    (0x04U)
#define LDOTUNEHI_ADDRESS    (0x05U)
#define PARTID_ADDRESS       (0x06U)
#define VBAT_ADDRESS         (0x08U)
#define VTEMP_ADDRESS        (0x09U)
#define WSLOTID_LOW_ADDRESS  (0x0DU)
#define WSLOTID_HIGH_ADDRESS (0x0EU)
#define XTRIM_ADDRESS        (0x1EU)
#define OTPREV_ADDRESS       (0x1FU)
#define BIAS_TUNE_ADDRESS    (0xAU)
#define DGC_TUNE_ADDRESS     (0x20U)
#define PLL_CC_ADDRESS       (0x35U)

/* internal arithmetic */
#define B20_SIGN_EXTEND_TEST (0x00100000UL)
#define B20_SIGN_EXTEND_MASK (0xFFF00000UL)
#define DRX_CARRIER_INT_LEN  (3)

#define CIA_MANUALLOWERBOUND_TH_64 (0x10U) // CIA lower bound threshold values for 64 MHz PRF
#define STSQUAL_THRESH_64_SH15     19661UL // = 0.60 * 32768

#define BIT12_SIGN_SHIFT     (3U) // Sign the shift number to duplicate the sign bit
#define B12_SIGN_EXTEND_TEST (0x2000UL)
#define B12_SIGN_EXTEND_MASK (0xC000UL)

#define SYS_CTRL_ID 0x38
#define RX_EN_IMMEDIATE 0x100
#define RX_DISABLE 0x40

#define DWT_REG_DATA_MAX_LENGTH 0x3100U

/* STS Minimum Threshold (STS_MNTH) needs to be adjusted with changing STS length.
 To adjust the STS_MNTH following formula can be used: STS_MNTH = SQRT(X/Y)*default_STS_MNTH
 default_STS_MNTH is 0x10
 X is the length of the STS in units of 8 (i.e. 8 for 64 length, 16 for 128 length etc.)
 Y is either 8 or 16, 8 when no PDOA or PDOA mode 1 and 16 for PDOA mode 3

 The API does not use the formula and the STS_MNTH value is derived from approximation formula as given by get_sts_mnth()
 function. The API here supports STS lengths as listed in: dwt_sts_lengths_e enum, which are: 32, 64, 128, 256, 512, 1024, 2048
 The enum value is used as the index into sts_length_factors array. The array has values which are generated by:
 val = SQRT(stsLength/16)*2048
 */
static const uint16_t sts_length_factors[STS_LEN_SUPPORTED] = { 1024, 1448, 2048, 2896, 4096, 5793, 8192 };

/* regNames contains register name, value pairs which are used for debug output/logging by external applications e.g. DecaRanging. */
static register_name_add_t regNames[] =
{
#ifdef _DGB_LOG
    { "IP_TOA_LO", IP_TOA_LO_ID }, { "IP_TOA_HI", IP_TOA_HI_ID }, { "CY0_TOA_LO", STS_TOA_LO_ID }, { "CY0_TOA_HI", STS_TOA_HI_ID }, { "CY1_TOA_LO", STS1_TOA_LO_ID },
    { "CY1_TOA_HI", STS1_TOA_HI_ID }, { "CIA_TDOA_0", CIA_TDOA_0_ID }, { "CIA_TDOA_1_PDOA", CIA_TDOA_1_PDOA_ID }, { "CIA_DIAG_0", CIA_DIAG_0_ID }, { "CIA_DIAG_1", CIA_DIAG_1_ID },
    { "IP_DIAG_0", IP_DIAG_0_ID }, { "IP_DIAG_1", IP_DIAG_1_ID }, { "IP_DIAG_2", IP_DIAG_2_ID }, { "IP_DIAG_3", IP_DIAG_3_ID }, { "IP_DIAG_4", IP_DIAG_4_ID }, { "IP_DIAG_5", IP_DIAG_5_ID },
    { "IP_DIAG_6", IP_DIAG_6_ID }, { "IP_DIAG_7", IP_DIAG_7_ID }, { "IP_DIAG_8", IP_DIAG_8_ID }, { "IP_DIAG_9", IP_DIAG_9_ID }, { "IP_DIAG_10", IP_DIAG_10_ID },
    { "IP_DIAG_11", IP_DIAG_11_ID }, { "IP_DIAG_12", IP_DIAG_12_ID }, { "CY0_DIAG_0", STS_DIAG_0_ID }, { "CY0_DIAG_1", STS_DIAG_1_ID }, { "CY0_DIAG_2", STS_DIAG_2_ID },
    { "CY0_DIAG_3", STS_DIAG_3_ID }, { "CY0_DIAG_4", STS_DIAG_4_ID }, { "CY0_DIAG_5", STS_DIAG_5_ID }, { "CY0_DIAG_6", STS_DIAG_6_ID }, { "CY0_DIAG_7", STS_DIAG_7_ID },
    { "CY0_DIAG_8", STS_DIAG_8_ID }, { "CY0_DIAG_9", STS_DIAG_9_ID }, { "CY0_DIAG_10", STS_DIAG_10_ID }, { "CY0_DIAG_11", STS_DIAG_11_ID }, { "CY0_DIAG_12", STS_DIAG_12_ID },
    { "CY0_DIAG_13", STS_DIAG_13_ID }, { "CY0_DIAG_14", STS_DIAG_14_ID }, { "CY0_DIAG_15", STS_DIAG_15_ID }, { "CY0_DIAG_16", STS_DIAG_16_ID }, { "CY0_DIAG_17", STS_DIAG_17_ID },
    { "CY1_DIAG_0", STS1_DIAG_0_ID }, { "CY1_DIAG_1", STS1_DIAG_1_ID }, { "CY1_DIAG_2", STS1_DIAG_2_ID }, { "CY1_DIAG_3", STS1_DIAG_3_ID }, { "CY1_DIAG_4", STS1_DIAG_4_ID },
    { "CY1_DIAG_5", STS1_DIAG_5_ID }, { "CY1_DIAG_6", STS1_DIAG_6_ID }, { "CY1_DIAG_7", STS1_DIAG_7_ID }, { "CY1_DIAG_8", STS1_DIAG_8_ID }, { "CY1_DIAG_9", STS1_DIAG_9_ID },
    { "CY1_DIAG_10", STS1_DIAG_10_ID }, { "CY1_DIAG_11", STS1_DIAG_11_ID }, { "CY1_DIAG_12", STS1_DIAG_12_ID }, { "RX_ANTENNA_DELAY", CIA_CONF_ID },
    { "FP_CONFIDENCE_LIMIT", FP_CONF_ID }, { "IP_CONFIG_LO", IP_CONFIG_LO_ID }, { "IP_CONFIG_HI",IP_CONFIG_HI_ID }, { "CY_CONFIG_LO", STS_CONFIG_LO_ID },
    { "CY_CONFIG_HI", STS_CONFIG_HI_ID }, { "PGF_DELAY_COMP_LO", PGF_DELAY_COMP_LO_ID }, { "PGF_DELAY_COMP_HI",PGF_DELAY_COMP_HI_ID },
    { "SAR_CTRL", SAR_CTRL_ID }, { "CP_CFG0", STS_CFG0_ID }, { "CP_CTRL_ID", STS_CTRL_ID },{ "CP_STS", STS_STS_ID },{ "LCSS_MARGIN", LCSS_MARGIN_ID },
    {"EQ_COEFF_A", EQ_COEFF_A_ID}, {"EQ_COEFF_B", EQ_COEFF_B_ID}, {"EQ_COEFF_C", EQ_COEFF_C_ID}, {"EQ_COEFF_D", EQ_COEFF_D_ID}, {"CIA_COEFFICIENT_ADJUST", CIA_ADJUST_ID },
#endif
    {NULL, 0}
};

// -------------------------------------------------------------------------------------------------------------------
#define FORCE_CLK_SYS_TX      (1)
#define FORCE_CLK_AUTO        (5)
#define FORCE_SYSCLK_PLL      (2U)
#define FORCE_SYSCLK_FOSCDIV4 (1U)
#define FORCE_SYSCLK_FOSC     (3U)
#define FORCE_CLK_PLL         (2U)
#define FORCE_CLK_SYS_RX      (2)
#define FORCE_CLK_RX_ADC      (6)

/* Fast Access Commands (FAC)
 * only write operation is possible for this mode
 * bit_7=one is W operation, bit_6=zero: FastAccess command, bit_[5..1] addr, bits_0=one: MODE of FastAccess
 */
#define DW3000_SPI_FAC (0U << 6U | 1U << 0U)

/* Fast Access Commands with Read/Write support (FACRW)
 * bit_7 is R/W operation, bit_6=zero: FastAccess command, bit_[5..1] addr, bits_0=zero: MODE of FastAccess
 */
#define DW3000_SPI_FACRW (0U << 6U | 0U << 0U)

/* Extended Address Mode with Read/Write support (EAMRW)
 * b[0] = bit_7 is R/W operation, bit_6 one = ExtendedAddressMode;
 * b[1] = addr<<2 | (mode&0x3)
 */
#define DW3000_SPI_EAMRW (1U << 6U)

#define RSL_QUANTIZATION_FACTOR (17)

// -------------------------------------------------------------------------------------------------------------------
// TxPower Adjustment
//
// Each value corresponds to the output TxPower difference between the
// coarse gain setting (i+1) and (i)
// The step is in unit of 0.1dB

static const uint8_t lut_coarse_gain[NUM_COARSE_GAIN] =
{
    32,         // TxPower gain from coarse setting 0x0 to 0x1
    13,         // TxPower gain from coarse setting 0x1 to 0x2
    5          // TxPower gain from coarse setting 0x2 to 0x3
};

// Each value corresponds to the output TxPower difference between the
// fine gain setting (i+1) and (i)
// The step is in unit of 0.1dB

static const uint8_t fine_gain_lut_chan5[LUT_COMP_SIZE] =
{
    0, 32, 29, 28, 20, 18, 12, 13,
    10, 10, 7, 8, 6, 7, 5, 6,
    5, 5, 4, 4, 4, 4, 3, 3,
    3, 3, 2, 3, 2, 3, 2, 3,
    3, 2, 2, 2, 1, 2, 1, 2,
    1, 2, 1, 1, 1, 1, 1, 1,
    1, 1, 1, 1, 1, 1, 1, 1,
    1, 1, 1, 1, 1, 1, 1, 1
};

static const uint8_t fine_gain_lut_chan9[LUT_COMP_SIZE] =
{
    0, 11, 14, 18, 15, 15, 10, 12,
    9, 9, 7, 8, 6, 7, 5, 6,
    5, 5, 4, 5, 4, 4, 3, 4,
    3, 3, 3, 3, 3, 3, 2, 3,
    3, 2, 2, 2, 2, 2, 1, 2,
    2, 2, 2, 2, 1, 2, 1, 2,
    1, 1, 1, 2, 1, 1, 1, 1,
    1, 1, 1, 1, 0, 1, 1, 1
};

/* Linear Tx Power Adjustment */

#define MAX(a, b) (((a) > (b)) ? (a) : (b))
#define MIN(a, b) (((a) < (b)) ? (a) : (b))

//Naming convention tx power look up tables: PX_BY_CZ
//  PX => pa state ; 1 for ON, 0 for OFF
//  BY => bias trim value

//  CZ => channel

typedef struct
{
    const uint8_t* lut;
    uint8_t lut_size;
    uint8_t start_index;
    uint8_t end_index;
    uint8_t offset_index;
    uint8_t bias;
} tx_adj_lut_t;

typedef struct
{
    tx_adj_lut_t tx_frame_lut;
} txp_lut_t;

static const uint8_t dwt_txp_lut_p0_b1_c5[] = {
    0xfe, 0xda, 0xc2, 0xb2, 0xa2, 0x96, 0x8a,
    0x82, 0xe1, 0xc5, 0xb1, 0xa1, 0x95, 0x89,
    0x81, 0x79, 0x52, 0x4e, 0x4a, 0x61, 0x5d,
    0x42, 0x55, 0x3e, 0x4d, 0x3a, 0x45, 0x36,
    0x41, 0x32, 0x3d, 0x2e, 0x39, 0x35, 0x2a,
    0x31, 0x31, 0x26, 0x2d, 0x50, 0x22, 0x29,
    0x48, 0x25, 0x1e, 0x1e, 0x3c, 0x21, 0x21,
    0x34, 0x1d, 0x1d, 0x30, 0x2c, 0x2c, 0x2c,
    0x28, 0x28, 0x28, 0x24, 0x24, 0x24, 0x20,
    0x20, 0x20, 0x1c, 0x1c
};

static const uint8_t dwt_txp_lut_p0_b7_c5[] = {
    0xfe, 0xee, 0xe2, 0xd6, 0xca, 0xc2, 0xba,
    0xb2, 0xf9, 0xe9, 0x9a, 0xd1, 0xc5, 0x8a,
    0xb5, 0xad, 0xa5, 0x9d, 0x95, 0x91, 0x89,
    0x85, 0x81, 0x7d, 0x5e, 0x75, 0x71, 0x6d,
    0x52, 0x65, 0x61, 0x5d, 0x59, 0x46, 0x55,
    0x51, 0x4d, 0x3e, 0x49, 0x3a, 0x45, 0x36,
    0x41, 0x3d, 0x32, 0x39, 0x39, 0x2e, 0x35,
    0x58, 0x31, 0x31, 0x50, 0x2d, 0x2d, 0x48,
    0x44, 0x40, 0x40, 0x3c, 0x3c, 0x3c, 0x38,
    0x38, 0x34, 0x34, 0x30, 0x30, 0x30, 0x2c
};

static const uint8_t dwt_txp_lut_p0_b1_c9[] = {
    0xfe, 0xe6, 0xd6, 0xc6, 0xba, 0xb2, 0xa6,
    0x9e, 0xed, 0x8e, 0xc9, 0xbd, 0x7e, 0x7a,
    0x9d, 0x95, 0x91, 0x89, 0x81, 0x7d, 0x79,
    0x75, 0x56, 0x52, 0x65, 0x61, 0x4a, 0x46,
    0x59, 0x55, 0x51, 0x3e, 0x4d, 0x49, 0x3a,
    0x45, 0x36, 0x41, 0x32, 0x3d, 0x39, 0x2e,
    0x35, 0x35, 0x2a, 0x31, 0x31, 0x26, 0x2d,
    0x4c, 0x29, 0x22, 0x44, 0x25, 0x25, 0x1e,
    0x3c, 0x21, 0x21, 0x34, 0x34, 0x1d, 0x1d,
    0x30, 0x2c, 0x2c, 0x28, 0x28, 0x28, 0x24,
    0x24, 0x24, 0x24, 0x20, 0x20, 0x20, 0x20,
    0x1c
};

static const uint8_t dwt_txp_lut_p0_b7_c9[] = {
    0xfe, 0xf2, 0xea, 0xde, 0xd6, 0xce, 0xc6,
    0xbe, 0xf9, 0xb2, 0xe5, 0xa6, 0x9e, 0xc9,
    0xc1, 0x8e, 0x8a, 0xad, 0xa5, 0x7e, 0x7a,
    0x76, 0x72, 0x6e, 0x85, 0x81, 0x7d, 0x62,
    0x5e, 0x5a, 0x6d, 0x56, 0x52, 0x65, 0x61,
    0x5d, 0x4a, 0x46, 0x55, 0x42, 0x51, 0x4d,
    0x3e, 0x49, 0x3a, 0x45, 0x36, 0x41, 0x3d,
    0x32, 0x39, 0x2e, 0x35, 0x35, 0x54, 0x31,
    0x31, 0x2d, 0x2d, 0x48, 0x48, 0x44, 0x40,
    0x40, 0x3c, 0x3c, 0x3c, 0x38, 0x38, 0x34,
    0x34, 0x30, 0x30, 0x30, 0x2c
};

#define GET_TXP_LUT(chan, pa, bias) dwt_txp_lut_p ## pa ## _b ## bias ## _c ## chan

// RAW LUTs sizes
#define ARRAY_SIZE_LUT(X) sizeof(X) / sizeof(X[0])
#define GET_TXP_LUT_SIZE(chan, pa, bias) ARRAY_SIZE_LUT(GET_TXP_LUT(chan, pa, bias))

// Start index allowed for each LUT
#define MIN_IDX_P0_B7_C5_SOC 0U
#define MIN_IDX_P0_B1_C5_SOC 0U

#define MIN_IDX_P0_B7_C9_SOC 0U
#define MIN_IDX_P0_B1_C9_SOC 0U

// Max index allowed for each LUT
#define MAX_IDX_P0_B7_C5_SOC 28U
#define MAX_IDX_P0_B1_C5_SOC (GET_TXP_LUT_SIZE(5, 0, 1) - 1U - MIN_IDX_P0_B1_C5_SOC + 1U) + (MAX_IDX_P0_B7_C5_SOC - MIN_IDX_P0_B7_C5_SOC + 1U) - 1U

#define MAX_IDX_P0_B7_C9_SOC 16U
#define MAX_IDX_P0_B1_C9_SOC (GET_TXP_LUT_SIZE(9, 0, 1) - 1U - MIN_IDX_P0_B1_C9_SOC + 1U) + (MAX_IDX_P0_B7_C9_SOC - MIN_IDX_P0_B7_C9_SOC + 1U) - 1U

#define GET_MIN_INDEX_SIP(chan, pa, bias) (MIN_IDX_P## pa ## _B ## bias ## _C ## chan ## _SIP)
#define GET_MIN_INDEX_SOC(chan, pa, bias) (MIN_IDX_P## pa ## _B ## bias ## _C ## chan ## _SOC)

#define GET_MAX_INDEX_SIP(chan, pa, bias) (MAX_IDX_P## pa ## _B ## bias ## _C ## chan ## _SIP)
#define GET_MAX_INDEX_SOC(chan, pa, bias) (MAX_IDX_P## pa ## _B ## bias ## _C ## chan ## _SOC)

/* the CIR accumulator offset to read from*/
static const uint16_t dwt_cir_acc_offset[NUM_OF_DWT_ACC_IDX] = { 0x0U, 0x400U, 0x600U};

// -------------------------------------------------------------------------------------------------------------------
// Internal functions prototypes for controlling and configuring the device
//
static uint32_t dwt_read32bitoffsetreg(dwchip_t *dw, uint32_t regFileID, uint16_t regOffset);
static uint8_t dwt_read8bitoffsetreg(dwchip_t *dw, uint32_t regFileID, uint16_t regOffset);
static void dwt_write8bitoffsetreg(dwchip_t *dw, uint32_t regFileID, uint16_t regOffset, uint8_t regval);
static uint32_t dwt_otpreadpintoparams(dwchip_t *dw, uint16_t address);
static void dwt_otpprogword32(dwchip_t *dw, uint32_t data, uint16_t address);
static void ull_force_clocks(dwchip_t *dw, int32_t clocks);
static uint8_t ull_calcbandwidthadj(dwchip_t *dw, uint16_t target_count);
static int32_t ull_run_pgfcal(dwchip_t *dw);
static int32_t ull_pgf_cal(dwchip_t *dw, int32_t ldoen);
static uint8_t calc_new_th(uint8_t th, uint32_t iq_n, int16_t dec_step);
static int32_t check_updated_th(uint32_t iq_, uint32_t iq_p, int16_t *best_diff);
static void ull_setplenfine(dwchip_t *dw, uint8_t preambleLength);
static uint16_t ull_getframelength(dwchip_t *dw, uint8_t *rng_bit);
static int32_t ull_check_dev_id(dwchip_t *dw);
static int32_t ull_adcoffsetscalibration(dwchip_t *dw);
static void ull_enable_disable_eq(dwchip_t *dw, uint8_t en);
static void ull_enable_rftx_blocks(dwchip_t *dw);
static void ull_disable_rftx_blocks(dwchip_t *dw);
static int32_t ull_setchannel(dwchip_t *dw, uint8_t ch);
static void ull_dis_otp_ips(dwchip_t *dw, int mode);
static void ull_setrxtimeout(dwchip_t *dw, uint32_t on_time);
static void ull_setpreambledetecttimeout(dwchip_t *dw, uint16_t timeout);
static void ull_aon_write(dwchip_t *dw, uint16_t aon_address, uint8_t aon_write_data);
static uint8_t ull_aon_read(dwchip_t *dw, uint16_t aon_address);
static float ull_convertrawtemperature(dwchip_t *dw, uint8_t raw_temp);
static uint16_t ull_readtempvbat(dwchip_t *dw);
static uint16_t ull_readsar(dwchip_t *dw, uint8_t input_mux, uint8_t attn);
static uint8_t ull_pll_ch5_auto_cal(dwchip_t *dw, uint32_t coarse_code, uint16_t sleep_us, uint8_t steps, uint8_t *p_num_steps_lock, int8_t temperature);
static uint8_t ull_pll_ch9_auto_cal(dwchip_t *dw, uint32_t coarse_code, uint16_t sleep_us, uint8_t steps, uint8_t *p_num_steps_lock);
static void ull_capture_adc_samples(dwchip_t *dw, dwt_capture_adc_t *capture_adc);
static void ull_read_adc_samples(dwchip_t *dw, dwt_capture_adc_t *capture_adc);
static void ull_enable_rf_rx(dwchip_t *dw, uint8_t rx_ab);
static void ull_disable_rf_rx(dwchip_t *dw);
static void ull_forcetrxoff(dwchip_t *dw);
static void ull_timers_reset(dwchip_t *dw);
static void ull_update_ststhreshold(dwchip_t *dw, uint8_t rx_pcode, uint8_t stsBlocks);
static void ull_setstslength_s(dwchip_t *dw, uint8_t sts_len);
static void ull_setstslength(dwchip_t *dw, dwt_sts_lengths_e sts_len);
static inline uint8_t ull_getrxcode(dwchip_t *dw);

/* Read current RX code. */
static inline uint8_t ull_getrxcode(dwchip_t *dw)
{
    return (uint8_t)((dwt_read32bitoffsetreg(dw, CHAN_CTRL_ID, 0) & CHAN_CTRL_RX_PCODE_BIT_MASK) >> (uint32_t)CHAN_CTRL_RX_PCODE_BIT_OFFSET);
}

/* Update current STS threshold. */
static void ull_update_ststhreshold(dwchip_t *dw, uint8_t rx_pcode, uint8_t stsBlocks)
{
    const uint32_t stslen = (uint32_t)stsBlocks + 1UL;
    uint32_t ststhresh;
    (void) rx_pcode;

    ststhresh = (stslen * 8UL * (uint32_t)STSQUAL_THRESH_64_SH15) >> 15UL;
    LOCAL_DATA(dw)->ststhreshold = (int16_t)ststhresh;

    /* Cache variables needed for ull_setpdoamode(). */
    LOCAL_DATA(dw)->stsLength = (dwt_sts_lengths_e)stsBlocks;
}


static void ull_setstslength_s(dwchip_t *dw, uint8_t sts_len)
{
    dwt_write8bitoffsetreg(dw, STS_CFG0_ID, 0U, (uint8_t)(GET_STS_REG_SET_VALUE((uint16_t)(sts_len)) - 1U)); /*Starts from 0 that is why -1*/
}


/*! ------------------------------------------------------------------------------------------------------------------
 * @brief  This function updates STS length.
 *
 * @param dw - DW3000 chip descriptor handler.
 * @param sts_len - Desired STS length to set (values in dwt_sts_lengths_e)
 *
 * output parameters
 *
 * no return value
 */
static void ull_setstslength(dwchip_t *dw, dwt_sts_lengths_e sts_len)
{
    ull_setstslength_s(dw, (uint8_t)sts_len);
    ull_update_ststhreshold(dw, ull_getrxcode(dw), (uint8_t)sts_len);
}

/*! ------------------------------------------------------------------------------------------------------------------
 * @brief  This function wakes up the device by an IO pin. DW3000 SPI_CS or WAKEUP pins can be used for this.
 *
 * @param dw - DW3720 chip descriptor handler.
 *
 * output parameters
 *
 * no return value
 */
static void ull_wakeup_ic(dwchip_t *dw)
{
#ifndef WIN32
    dw->wakeup_device_with_io();
#else
    (void)dw;
#endif
}

/*! ------------------------------------------------------------------------------------------------------------------
 * @brief  this function is used to read/write to the DW3720 device registers
 *
 * input parameters:
 * @param dw            - DW3720 chip descriptor handler.
 * @param regFileID     - ID of register file or buffer being accessed
 * @param index         - byte index into register file or buffer being accessed
 * @param length        - number of bytes being written
 * @param buffer        - pointer to buffer containing the 'length' bytes to be written
 * @param mode          - DW3000_SPI_WR_BIT/DW3000_SPI_RD_BIT
 *
 * no return value
 */
static void dwt_xfer3xxx(dwchip_t *dw,
    uint32_t regFileID, // 0x0, 0x04-0x7F; 0x10000, 0x10004, 0x10008-0x1007F; 0x20000 etc.
    uint16_t index,      // sub-index, calculated from regFileID 0..0x7F
    uint16_t length, uint8_t *buffer, const spi_modes_e mode)
{
    uint8_t header[2]; // Buffer to compose header in
    uint16_t cnt = 1U;  // Counter for length of a header
    uint16_t reg_file;
    uint16_t reg_offset;
    uint16_t addr;
    uint8_t crc8, dwcrc8;
    bool fatal_error_occurred = false;

    [[maybe_unused]] bool length_is_correct = length < DWT_REG_DATA_MAX_LENGTH;
    assert(length_is_correct);

    if ((mode == DW3000_SPI_WR_FAST_CMD) || (mode == DW3000_SPI_RD_FAST_CMD))
    { /* Fast Access Commands (FAC) */
        header[0] = (uint8_t)((uint16_t)DW3000_SPI_WR_BIT >> 8U) | (uint8_t)(regFileID << 1UL) | DW3000_SPI_FAC;
    }
    else
    {
        reg_file = (uint16_t)(0x1FUL & ((regFileID + (uint32_t)index) >> 16UL));
        reg_offset = 0x7FU & ((uint16_t)regFileID + index);

        // Write message header selecting WRITE operation and addresses as appropriate
        addr = (reg_file << 9U) | (reg_offset << 2U);
        header[0] = (uint8_t)(((uint16_t)mode | addr) >> 8U); // bit7 + addr[4:0] + sub_addr[6:6]

        if ((reg_offset != 0U) || ((mode != DW3000_SPI_WR_BIT) && (mode != DW3000_SPI_RD_BIT)))
        { /* Extended Address Mode with Read/Write support (EAMRW) */
            header[0] |= DW3000_SPI_EAMRW;
            header[1] = (uint8_t)addr | (uint8_t)mode; // EAM: subaddr[5:0]+ R/W/AND_OR
            cnt = 2U;
        }
    }

    switch (mode)
    {
    case DW3000_SPI_AND_OR_8:
    case DW3000_SPI_AND_OR_16:
    case DW3000_SPI_AND_OR_32:
    case DW3000_SPI_WR_BIT:
    case DW3000_SPI_WR_FAST_CMD:
    {
        if (LOCAL_DATA(dw)->spicrc != DWT_SPI_CRC_MODE_NO)
        {
            // generate 8 bit CRC
            crc8 = dwt_generatecrc8(header, cnt, 0U);
            crc8 = dwt_generatecrc8(buffer, length, crc8);

            // Write it to the SPI
            (void)dw->SPI->writetospiwithcrc(cnt, header, length, buffer, crc8);
        }
        else
       {
            // Write it to the SPI
            (void)dw->SPI->writetospi(cnt, header, length, buffer);
        }
        break;
    }
    case DW3000_SPI_RD_BIT:
    case DW3000_SPI_RD_FAST_CMD:
    {
        (void)dw->SPI->readfromspi(cnt, header, length, buffer);

        // check that the SPI read has correct CRC-8 byte
        // also don't do for SPICRC_CFG_ID register itself to prevent infinite recursion
        if ((LOCAL_DATA(dw)->spicrc == DWT_SPI_CRC_MODE_WRRD) && (regFileID != SPI_RD_CRC_ID))
        {
            // generate 8 bit CRC from the read data
            crc8 = dwt_generatecrc8(header, cnt, 0U);
            crc8 = dwt_generatecrc8(buffer, length, crc8);

            // read the CRC that was generated in the DW3720 for the read transaction
            dwcrc8 = dwt_read8bitoffsetreg(dw, SPI_RD_CRC_ID, 0U);

            // if the two CRC don't match report SPI read error
            // potential problem in callback if it will try to read/write SPI with CRC again.
            if (crc8 != dwcrc8)
            {
                if (dw->callbacks.cbSPIRDErr != NULL)
                {
                    dw->callbacks.cbSPIRDErr();
                }
            }
        }
        break;
    }
    default:
        fatal_error_occurred = true;
        break;
    }

    if(fatal_error_occurred)
    {
        while(true){ /* Forever loop */ }
    }

} // end dwt_xfer3xxx()

/*! ------------------------------------------------------------------------------------------------------------------
 * @brief  this function is used to write to the DW3000 device registers
 *
 * input parameters:
 * @param dw            - DW3720 chip descriptor handler.
 * @param regFileID  - ID of register file or buffer being accessed
 * @param index         - byte index into register file or buffer being accessed
 * @param length        - number of bytes being written
 * @param buffer        - pointer to buffer containing the 'length' bytes to be written
 *
 * output parameters
 *
 * no return value
 */
static void ull_writetodevice(dwchip_t *dw, uint32_t regFileID, uint16_t index, uint16_t length, uint8_t *buffer)
{
    dwt_xfer3xxx(dw, regFileID, index, length, buffer, DW3000_SPI_WR_BIT);
}

/*! ------------------------------------------------------------------------------------------------------------------
 * @brief  this function is used to read from the DW3000 device registers
 *
 * input parameters
 * @param dw        - DW3720 chip descriptor handler.
 * @param regFileID - ID of register file or buffer being accessed
 * @param index     - byte index into register file or buffer being accessed
 * @param length    - number of bytes being read
 * @param buffer    - pointer to buffer in which to return the read data.
 *
 * output parameters
 *
 * no return value
 */
static void ull_readfromdevice(dwchip_t *dw, uint32_t regFileID, uint16_t index, uint16_t length, uint8_t *buffer)
{
    dwt_xfer3xxx(dw, regFileID, index, length, buffer, DW3000_SPI_RD_BIT);
}

/*! ------------------------------------------------------------------------------------------------------------------
 * @brief  this function is used to read from the DW3720 device registers by using fast read
 *
 * @param dw        - DW3720 chip descriptor handler
 * @param regFileID - ID of register file or buffer being accessed
 * @param index     - byte index into register file or buffer being accessed
 * @param length    - number of bytes being read
 * @param buffer    - pointer to buffer in which to return the read data.
 * @param spi_modes - mode of fast command - read/write
 *
 * output parameters
 *
 * no return value
 */
static void dwt_read_write_fast_cmd_from_device(dwchip_t *dw, uint32_t regFileID, uint16_t index, uint16_t length, uint8_t *buffer, spi_modes_e spi_modes)
{
    dwt_xfer3xxx(dw, regFileID, index, length, buffer, spi_modes);
}

/*! ------------------------------------------------------------------------------------------------------------------
 *
 * @brief  this function is used to read 32-bit value in the device register
 *
 * input parameters:
 * @param dw        - DW3720 chip descriptor handler.
 * @param regFileID - ID of register file or buffer being accessed
 * @param regOffset - the index into register file or buffer being accessed
 *
 * output parameters
 *
 * @returns 32 bit register value
 */
static uint32_t dwt_read32bitoffsetreg(dwchip_t *dw, uint32_t regFileID, uint16_t regOffset)
{
    int32_t j;
    uint32_t regval = 0UL;
    uint8_t buffer[4];

    ull_readfromdevice(dw, regFileID, regOffset, 4U, buffer); // Read 4 bytes (32-bits) register into buffer

    for (j = 3; j >= 0; j--)
    {
        regval = (regval << 8UL) + (uint32_t)buffer[j];
    }

    return (regval);

} // end dwt_read32bitoffsetreg()

/*! ------------------------------------------------------------------------------------------------------------------
 * @brief  this function is used to read 16-bit value in the device register
 *
 * input parameters:
 * @param dw        - DW3720 chip descriptor handler.
 * @param regFileID - ID of register file or buffer being accessed
 * @param regOffset - the index into register file or buffer being accessed
 *
 * output parameters
 *
 * @returns 16 bit register value
 */
static uint16_t dwt_read16bitoffsetreg(dwchip_t *dw, uint32_t regFileID, uint16_t regOffset)
{
    uint16_t regval = 0U;
    uint8_t buffer[2];

    // Read 2 bytes (16-bits) register into buffer
    ull_readfromdevice(dw, regFileID, regOffset, 2U, buffer);

    regval = ((uint16_t)buffer[1] << 8U) + buffer[0];
    return regval;
} // end dwt_read16bitoffsetreg()

/*! ------------------------------------------------------------------------------------------------------------------
 * @brief  this function is used to read an 8-bit value in the device register
 *
 * input parameters:
 * @param dw        - DW3720 chip descriptor handler.
 * @param regFileID - ID of register file or buffer being accessed
 * @param regOffset - the index into register file or buffer being accessed
 *
 * output parameters
 *
 * returns 8-bit register value
 */
static uint8_t dwt_read8bitoffsetreg(dwchip_t *dw, uint32_t regFileID, uint16_t regOffset)
{
    uint8_t regval;

    ull_readfromdevice(dw, (uint32_t)regFileID, regOffset, 1U, &regval);

    return regval;
}

/*! ------------------------------------------------------------------------------------------------------------------
 * @brief  this function is used to write 32-bit value in the device register
 *
 * input parameters:
 * @param dw        - DW3720 chip descriptor handler.
 * @param regFileID - ID of register file or buffer being accessed
 * @param regOffset - the index into register file or buffer being accessed
 * @param regval    - the value to write
 *
 * output parameters
 *
 * no return value
 */
static void dwt_write32bitoffsetreg(dwchip_t *dw, uint32_t regFileID, uint16_t regOffset, uint32_t regval)
{
    int32_t j;
    uint8_t buffer[4];

    for (j = 0; j < 4; j++)
    {
        buffer[j] = (uint8_t)regval;
        regval >>= 8UL;
    }

    ull_writetodevice(dw, regFileID, regOffset, 4U, buffer);
} // end dwt_write32bitoffsetreg()

/*! ------------------------------------------------------------------------------------------------------------------
 * @brief  this function is used to write 16-bit value in the device register
 *
 * input parameters:
 * @param dw        - DW3720 chip descriptor handler.
 * @param regFileID - ID of register file or buffer being accessed
 * @param regOffset - the index into register file or buffer being accessed
 * @param regval    - the value to write
 *
 * output parameters
 *
 * no return value
 */
static void dwt_write16bitoffsetreg(dwchip_t *dw, uint32_t regFileID, uint16_t regOffset, uint16_t regval)
{
    uint8_t buffer[2];

    buffer[0] = (uint8_t)regval;
    buffer[1] = (uint8_t)(regval >> 8U);

    ull_writetodevice(dw, regFileID, (uint16_t)regOffset, 2U, buffer);
} // end dwt_write16bitoffsetreg()

/*! ------------------------------------------------------------------------------------------------------------------
 * @brief  this function is used to write an 8-bit value in the device register
 *
 * input parameters:
 * @param dw        - DW3720 chip descriptor handler.
 * @param regFileID - ID of register file or buffer being accessed
 * @param regOffset - the index into register file or buffer being accessed
 * @param regval    - the value to write
 *
 * output parameters
 *
 * no return value
 */
static void dwt_write8bitoffsetreg(dwchip_t *dw, uint32_t regFileID, uint16_t regOffset, uint8_t regval)
{
    ull_writetodevice(dw, regFileID, regOffset, 1U, &regval);
}

/*! ------------------------------------------------------------------------------------------------------------------
 * @brief  this function is used to modify a 32-bit value in the device register
 *
 * input parameters:
 * @param dw         - DW3720 chip descriptor handler.
 * @param regFileID  - ID of register file or buffer being accessed
 * @param regOffset  - the index into register file or buffer being accessed
 * @param regval_and - the value to AND to register
 * @param regval_or  - the value to OR to register
 * @return           - no return value
 */
static void dwt_modify32bitoffsetreg(dwchip_t *dw, const uint32_t regFileID, const uint16_t regOffset, const uint32_t and_value, const uint32_t or_value)
{
    uint8_t buf[8];
    buf[0] = (uint8_t)and_value;           // &0xFF;
    buf[1] = (uint8_t)(and_value >> 8UL);  // &0xFF;
    buf[2] = (uint8_t)(and_value >> 16UL); // &0xFF;
    buf[3] = (uint8_t)(and_value >> 24UL); // &0xFF;
    buf[4] = (uint8_t)or_value;            // &0xFF;
    buf[6] = (uint8_t)(or_value >> 16UL);  // &0xFF;
    buf[5] = (uint8_t)(or_value >> 8UL);   // &0xFF;
    buf[7] = (uint8_t)(or_value >> 24UL);  // &0xFF;
    dwt_xfer3xxx(dw, regFileID, regOffset, (uint16_t)sizeof(buf), buf, DW3000_SPI_AND_OR_32);
}

/*! ------------------------------------------------------------------------------------------------------------------
 * @brief  this function is used to modify a 16-bit value in the device register
 *
 * input parameters:
 * @param dw         - DW3720 chip descriptor handler.
 * @param regFileID  - ID of register file or buffer being accessed
 * @param regOffset  - the index into register file or buffer being accessed
 * @param regval_and - the value to AND to register
 * @param regval_or  - the value to OR to register
 * @return           - no return value
 */
static void dwt_modify16bitoffsetreg(dwchip_t *dw, const uint32_t regFileID, const uint16_t regOffset, const uint16_t and_value, const uint16_t or_value)
{
    uint8_t buf[4];
    buf[0] = (uint8_t)and_value;        // &0xFF;
    buf[1] = (uint8_t)(and_value >> 8U); // &0xFF;
    buf[2] = (uint8_t)or_value;         // &0xFF;
    buf[3] = (uint8_t)(or_value >> 8U);  // &0xFF;
    dwt_xfer3xxx(dw, regFileID, regOffset, (uint16_t)sizeof(buf), buf, DW3000_SPI_AND_OR_16);
}

/*! ------------------------------------------------------------------------------------------------------------------
 * @brief  this function is used to modify an 8-bit value in the device register
 *
 * input parameters:
 * @param dw        - DW3720 chip descriptor handler.
 * @param regFileID - ID of register file or buffer being accessed
 * @param regOffset - the index into register file or buffer being accessed
 * @param and_value - the value to AND to register
 * @param or_value  - the value to OR to register
 * @return          - no return value
 */
static void dwt_modify8bitoffsetreg(dwchip_t *dw, const uint32_t regFileID, const uint16_t regOffset, const uint8_t and_value, const uint8_t or_value)
{
    uint8_t buf[2];
    buf[0] = and_value;
    buf[1] = or_value;
    dwt_xfer3xxx(dw, regFileID, regOffset, (uint16_t)sizeof(buf), buf, DW3000_SPI_AND_OR_8);
}

/*! ------------------------------------------------------------------------------------------------------------------
 * @brief This is used to enable SPI CRC check in DW3720
 *
 * input parameters
 * @param dw       - DW3720 chip descriptor handler.
 * @param crc_mode - if set to DWT_SPI_CRC_MODE_WR then SPI CRC checking will be performed in DW3720 on each SPI write
 *                   last byte of the SPI write transaction needs to be the 8-bit CRC, if it does not match
 *                   the one calculated by DW3720 SPI CRC ERROR event will be set in the status register (SYS_STATUS_SPICRC)
 *
 * @param spireaderr_cb - this needs to contain the callback function pointer which will be called when SPI read error
 *                        is detected (when the DW3720 generated CRC does not match the one calculated by  dwt_generatecrc8
 *                        following the SPI read transaction)
 *
 * output parameters
 *
 * no return value
 */
static void ull_enablespicrccheck(dwchip_t *dw, dwt_spi_crc_mode_e crc_mode, dwt_spierrcb_t spireaderr_cb)
{
    // enable CRC check in DW3000
    if (crc_mode != DWT_SPI_CRC_MODE_NO)
    {
        dwt_or8bitoffsetreg(dw, SYS_CFG_ID, 0U, SYS_CFG_SPI_CRC_BIT_MASK);

        // enable CRC generation on SPI read transaction which the DW3000 will store in SPICRC_CFG_ID register
        if (crc_mode == DWT_SPI_CRC_MODE_WRRD)
        {
            dw->callbacks.cbSPIRDErr = spireaderr_cb;
        }
    }
    else
    {
        dwt_and8bitoffsetreg(dw, SYS_CFG_ID, 0U, (uint8_t)~SYS_CFG_SPI_CRC_BIT_MASK);
    }
    LOCAL_DATA(dw)->spicrc = crc_mode;
}

static void dwt_localstruct_init(dwt_local_data_t *data)
{
    data->dblbuffon = (uint8_t)DBL_BUFF_OFF; // Double buffer mode off by default / clear the flag
    data->sleep_mode = (uint16_t)DWT_RUNSAR;  // Configure RUN_SAR on wake by default as it is needed when running PGF_CAL
    data->spicrc = DWT_SPI_CRC_MODE_NO;
    data->stsconfig = (uint8_t)DWT_STS_MODE_OFF; // STS off
    data->channel = 0U;
    data->temperature = TEMP_INIT;
    data->vdddig_otp = 0U;
    data->vdddig_current = 0U;
    data->vBatP = 0U;
    data->tempP = 0U;
    data->sys_cfg_dis_fce_bit_flag = 0U;
}

#ifdef AUTO_PLL_CAL
/*! ------------------------------------------------------------------------------------------------------------------
 * @brief This API function is used to configure a specific VDDDIG value (86mV, 88mV or 93mV).
 * It is required to have a reference VDDDIG value @86mV in the device's OTP memory to ensure the voltage is correctly scaled
 * relatively to this reference value. If the OTP is not provisionned (vdddig_otp not set during initialisaton), the API will return an error.
 *
 * If OTP is provisionned, the API can still return an DWT_ERROR if the target setting cannot be achieved relatively to the reference level.
 * This should never occur on DW3720 devices as mass production data shows reference VDDDIG is within 0x5 and 0xD. WIthin this range, the function
 * shall always find a solution and the error check is for software protection / fault detection.
 *
 * input parameters:
 * @param dw     - DW3720 chip descriptor handler.
 * @param vdddig - the target voltage at which the IC must be configured. Either 86mV, 88mV or 93mV.
 *
 * output parameters
 *
 * @returns DWT_SUCCESS for success, or DWT_ERROR for error
 */
static int32_t ull_set_vdddig_mv(dwchip_t *dw,  dwt_vdddig_mv_t vdddig)
{
    if(LOCAL_DATA(dw)->vdddig_otp == 0U)
    {
        // OTP is not provisionned. AON register default value = 0xC was configured at boot.
        // We cannot configure voltage accurately for this part
        return (int32_t)DWT_ERROR;
    }

    uint8_t vdddig_coarse = (LOCAL_DATA(dw)->vdddig_otp & 0x30U) >> 4U;
    uint8_t vdddig_fine = (LOCAL_DATA(dw)->vdddig_otp & 0x0FU);

    switch (vdddig)
    {
        case VDDDIG_86mV:
            break;

        case VDDDIG_88mV:
            if(vdddig_fine <= 13U) // Should always be true as OTP setting distribution is 0x5 to 0xD
            {
                vdddig_fine += 2U;
            }
            else if (vdddig_coarse != 3U) // Safety fallback
            {
                vdddig_coarse += 1U;
                vdddig_fine -= 8U;
            }
            else {
                return (int32_t)DWT_ERROR;
            }
            break;

        case VDDDIG_93mV:
            if(vdddig_fine >= 3U && vdddig_coarse != 3U) // Should always be true as vdddig setting distribution is 0x5 to 0xD
            {
                vdddig_coarse += 1U;
                vdddig_fine -= 3U;
            }
            else if (vdddig_fine < 3U)
            {
                vdddig_fine += 7U;
            }
            else{
                return (int32_t)DWT_ERROR;
            }
            break;

        default:
            return (int32_t)DWT_ERROR;
    }
    LOCAL_DATA(dw)->vdddig_current = vdddig_coarse << 4U | vdddig_fine;

    dwt_aon_write(AON_VDD_DIG, LOCAL_DATA(dw)->vdddig_current);
    return (int32_t)DWT_SUCCESS;
}
#endif

/** @note unique instance of local driver data */
static dwt_local_data_t dwt_local_data;

/*! ------------------------------------------------------------------------------------------------------------------
 * @brief This function initialises the DW3720 transceiver:
 * it reads its DEV_ID register (address 0x00) to verify the IC is one supported
 * by this software (e.g. DW3720 32-bit device ID value is 0xDECA03x4).  Then it
 * does any initial once only device configurations needed for use and initialises
 * as necessary any static data items belonging to this low-level driver.
 *
 * NOTES:
 * 1.it also reads and applies LDO and BIAS tune and crystal trim values from OTP memory
 * 2.it is assumed this function is called after a reset or on power up of the DW3720
 *
 * input parameters
 * @param dw - DW3720 chip descriptor handler.
 * @param mode - mask which defines which OTP values to read.
 *
 * output parameters
 *
 * @returns DWT_SUCCESS for success, or DWT_ERROR for error
 */
static int32_t ull_initialise(dwchip_t *dw, int32_t mode)
{
    uint32_t ldo_tune_lo;
    uint32_t ldo_tune_hi;
    uint16_t bias_tune;
    uint32_t pll_coarse_code;

    dw->priv = &dwt_local_data;
    dwt_local_data_t *pdw3000local = (dwt_local_data_t *)dw->priv;

    dwt_localstruct_init(pdw3000local);

    // Read LDO_TUNE and BIAS_TUNE from OTP
    ldo_tune_lo = dwt_otpreadpintoparams(dw, LDOTUNELO_ADDRESS);
    ldo_tune_hi = dwt_otpreadpintoparams(dw, LDOTUNEHI_ADDRESS);
    bias_tune = (uint16_t)dwt_otpreadpintoparams(dw, BIAS_TUNE_ADDRESS);

    // Saving VDDDIG value from OTP in chip local context to prevent future OTP reading
    // OTP contains trim code value only. Coarse set to 0 by default.
    uint8_t otp_vdddig = (uint8_t)((((ldo_tune_hi & LDO_TUNE_HI_VDDDIG_COARSE_MASK) >> LDO_TUNE_HI_VDDDIG_COARSE_OFFSET) << 4UL) | ((ldo_tune_hi & LDO_TUNE_HI_VDDDIG_TRIM_MASK) >> LDO_TUNE_HI_VDDDIG_TRIM_OFFSET));

    if(otp_vdddig != 0U)
    {
        pdw3000local->vdddig_otp = otp_vdddig;
    }
    else
    {
        pdw3000local->vdddig_current = dwt_aon_read((uint16_t)AON_VDD_DIG);
    }

    if ((ldo_tune_lo != 0UL) && (ldo_tune_hi != 0UL) && (bias_tune != 0UL))
    {
        dwt_or16bitoffsetreg(dw, OTP_CFG_ID, 0U, LDO_BIAS_KICK_E0);
        pdw3000local->sleep_mode |= (uint16_t)DWT_LOADLDO | (uint16_t)DWT_LOADBIAS; // save the kicks for the on-wake configuration
    }

#ifdef AUTO_PLL_CAL
    ull_set_vdddig_mv(dw, VDDDIG_88mV);
#endif

    // Read DGC_CFG from OTP
    if (dwt_otpreadpintoparams(dw, DGC_TUNE_ADDRESS) == DWT_DGC_CFG0)
    {
        pdw3000local->dgc_otp_set = (uint8_t)DWT_DGC_LOAD_FROM_OTP;
    }
    else
    {
        pdw3000local->dgc_otp_set = (uint8_t)DWT_DGC_LOAD_FROM_SW;
    }

    // Load Part and Lot ID from OTP
    if (((uint32_t)mode & (uint32_t)DWT_READ_OTP_PID) != 0U)
    {
        pdw3000local->partID = dwt_otpreadpintoparams(dw, PARTID_ADDRESS);
    }

    if (((uint32_t)mode & (uint32_t)DWT_READ_OTP_LID) != 0U)
    {
        uint32_t lot_id[2];
        lot_id[0] = dwt_otpreadpintoparams(dw, WSLOTID_LOW_ADDRESS);
        lot_id[1] = dwt_otpreadpintoparams(dw, WSLOTID_HIGH_ADDRESS);
        pdw3000local->lotID = ((uint64_t)lot_id[1] << 32) | lot_id[0];
    }

    if (((uint32_t)mode & (uint32_t)DWT_READ_OTP_BAT) != 0U)
    {
        // We save three voltage levels in OTP during production testing:
        // [7:0] = Vbat @ 1.62V
        // [15:8] = Vbat @ 3.6V
        // [23:16] = Vbat @ 3.0V
        pdw3000local->vBatP = (uint8_t)(dwt_otpreadpintoparams(dw, VBAT_ADDRESS) >> 16U);
    }

    if (((uint32_t)mode & (uint32_t)DWT_READ_OTP_TMP) != 0U)
    {
        pdw3000local->tempP = (uint8_t)dwt_otpreadpintoparams(dw, VTEMP_ADDRESS);
    }

    // if the reference temperature has not been programmed in OTP (early eng samples) set to default value
    if (pdw3000local->tempP == 0U)
    {
        pdw3000local->tempP = 0x85U; //@temp of 22 deg
    }

    // if the reference voltage has not been programmed in OTP (early eng samples) set to default value
    if (pdw3000local->vBatP == 0U)
    {
        pdw3000local->vBatP = 0x74U; //@Vref of 3.0V
    }

    pdw3000local->otprev = (uint8_t)dwt_otpreadpintoparams(dw, OTPREV_ADDRESS);

    pdw3000local->init_xtrim = (uint8_t)dwt_otpreadpintoparams(dw, XTRIM_ADDRESS) & XTAL_TRIM_BIT_MASK;
    if (pdw3000local->init_xtrim == 0U)
    {
        // set the default value
        pdw3000local->init_xtrim = DEFAULT_XTAL_TRIM;
    }
    dwt_write8bitoffsetreg(dw, XTAL_ID, 0U, pdw3000local->init_xtrim);

    pll_coarse_code = dwt_otpreadpintoparams(dw, PLL_CC_ADDRESS);
    if (pll_coarse_code != 0UL)
    {
        dwt_write32bitoffsetreg(dw, PLL_COARSE_CODE_ID, 0U, pll_coarse_code);
    }
#ifdef AUTO_PLL_CAL
    // Set the temperature of the device so calibration can use it.
    if (pdw3000local->temperature == TEMP_INIT)
    {
        uint16_t tempvbat = ull_readtempvbat(dw);
        pdw3000local->temperature = ull_convertrawtemperature(dw, tempvbat >> 8U);  // Temperature in upper 8 bits
    }
#endif

    dwt_write32bitreg(dw, TX_CTRL_LO_ID, TX_CTRL_LO_DEF);

    pdw3000local->sys_cfg_dis_fce_bit_flag = ((dwt_read32bitreg(dw, SYS_CFG_ID) & SYS_CFG_DIS_FCE_BIT_MASK) != 0UL) ? 1U : 0U;

    return (int32_t)DWT_SUCCESS;
} // end dwt_initialise()

/*! ------------------------------------------------------------------------------------------------------------------
 * @brief
 * This function checks if PLL is locked or not.
 *
 * input parameters:
 * @param dw - DW3000 chip descriptor handler.
 *
 * output parameters:
 * @returns DWT_SUCCESS if PLL is locked otherwise DWT_ERROR.
 */
static int is_pll_locked(dwchip_t *dw) {
    uint8_t cnt;

    for (cnt = 0; cnt < MAX_RETRIES_FOR_PLL; cnt++)
    {
        deca_usleep(DELAY_20uUSec);
        if ((dwt_read8bitoffsetreg(dw, SYS_STATUS_ID, 0U) & SYS_STATUS_CP_LOCK_BIT_MASK) != 0U)
        {   // PLL is locked
	        return (int)DWT_SUCCESS;
        }
    }
    return (int)DWT_ERROR;
}

/*! ------------------------------------------------------------------------------------------------------------------
 * @brief This function can place DW3720 into IDLE/IDLE_PLL or IDLE_RC mode when it is not actively in TX or RX.
 *
 * input parameters
 * @param dw    - DW3720 chip descriptor handler.
 * @param state - DWT_DW_IDLE (1) to put DW3720 into IDLE/IDLE_PLL state; DWT_DW_INIT (0) to put DW3720 into INIT_RC state;
 *                DWT_DW_IDLE_RC (2) to put DW3720 into IDLE_RC state.
 *
 * output parameters none
 *
 * returns DWT_SUCCESS for success, or DWT_ERROR for error
 */
static int ull_setdwstate(dwchip_t *dw, int32_t state)
{
    int ret = (int)DWT_SUCCESS;
    // Set the auto INIT2IDLE bit so that DW3720 enters IDLE mode before switching clocks to system_PLL
    if (state == (int32_t)DWT_DW_IDLE)
    // NOTE: PLL should be configured prior to this, and the device should be in IDLE_RC (if the PLL does not lock device will remain in IDLE_RC)
    {
        // switch clock to auto - if coming here from INIT_RC the clock will be FOSC/4, need to switch to auto prior to setting auto INIT2IDLE bit
        ull_force_clocks(dw, FORCE_CLK_AUTO);
        dwt_or32bitoffsetreg(dw, PLL_CAL_ID, 0U, PLL_CAL_PLL_CAL_EN_BIT_MASK);
        dwt_or8bitoffsetreg(dw, SEQ_CTRL_ID, 0x01U, (uint8_t)((uint16_t)(SEQ_CTRL_AINIT2IDLE_BIT_MASK >> 8U)));
        ret = is_pll_locked(dw);
    }
    else if (state == (int32_t)DWT_DW_IDLE_RC) // Change state to IDLE_RC and clear auto INIT2IDLE bit
    {
        // switch clock to FOSC
        dwt_or8bitoffsetreg(dw, CLK_CTRL_ID, 0U, FORCE_SYSCLK_FOSC);
        // clear the auto INIT2IDLE bit and set FORCE2INIT
        dwt_modify32bitoffsetreg(dw, SEQ_CTRL_ID, 0x0U, ~SEQ_CTRL_AINIT2IDLE_BIT_MASK, SEQ_CTRL_FORCE2INIT_BIT_MASK);
        // clear force bits (device will stay in IDLE_RC)
        dwt_and8bitoffsetreg(dw, SEQ_CTRL_ID, 0x2U, (uint8_t)(~(SEQ_CTRL_FORCE2INIT_BIT_MASK >> 16UL)));
        // switch clock to auto
        ull_force_clocks(dw, FORCE_CLK_AUTO);
    }
    else
    // NOTE: the SPI rate needs to be <= 7MHz as device is switching to INIT_RC state
    {
        dwt_or8bitoffsetreg(dw, CLK_CTRL_ID, 0U, FORCE_SYSCLK_FOSCDIV4);
        // clear the auto INIT2IDLE bit and set FORCE2INIT
        dwt_modify32bitoffsetreg(dw, SEQ_CTRL_ID, 0x0U, ~SEQ_CTRL_AINIT2IDLE_BIT_MASK, SEQ_CTRL_FORCE2INIT_BIT_MASK);
        dwt_and8bitoffsetreg(dw, SEQ_CTRL_ID, 0x2U, (uint8_t)(~(SEQ_CTRL_FORCE2INIT_BIT_MASK >> 16UL)));
    }
    return ret;
}

/*! ------------------------------------------------------------------------------------------------------------------
 * @brief This is used to enable GPIO clocks. The clocks are needed to ensure correct GPIO operation
 *
 * input parameters
 * @param dw - DW3720 chip descriptor handler.
 *
 * output parameters
 *
 * no return value
 */
static void ull_enablegpioclocks(dwchip_t *dw)
{
    dwt_or32bitoffsetreg(dw, CLK_CTRL_ID, 0U, CLK_CTRL_GPIO_CLK_EN_BIT_MASK);
}

/*! ------------------------------------------------------------------------------------------------------------------
 * @brief This is used to configure the GPIO mode
 *
 * input parameters
 * @param dw   - DW3720 chip descriptor handler.
 * @param gpio_mask - the mask of the GPIOs to change the mode of. Typically built from dwt_gpio_mask_e values.
 * @param gpio_modes - the GPIO modes to set. Typically built from dwt_gpio_pin_e values.
 *
 * output parameters
 *
 * no return value
 */
static void ull_setgpiomode(dwchip_t *dw, uint32_t gpio_mask, uint32_t gpio_modes)
{
    uint32_t mask = 0UL;
    for (uint32_t i= 0UL; i <= 8UL; i++)
    {
        if ((gpio_mask & (1UL << i)) != 0UL)
        {
            mask |= (GPIO_MFIO_MODE_MASK << 3UL*i);
        }
    }

    dwt_and_or32bitoffsetreg(dw, GPIO_MODE_ID, 0U, ~mask, mask & gpio_modes);
}

/*! ------------------------------------------------------------------------------------------------------------------
 * @brief This is used to configure the GPIOs as inputs or outputs, default is input == 1
 *
 * input parameters
 * @param dw     - DW3720 chip descriptor handler.
 * @param in_out - if corresponding GPIO bit is set to 1 then it is input, otherwise it is output
 *               - GPIO 0 = bit 0, GPIO 1 = bit 1 etc...
 *
 * output parameters
 *
 * no return value
 */
static void ull_setgpiodir(dwchip_t *dw, uint16_t in_out)
{
    /*Set GPIOs direction*/
    dwt_write16bitoffsetreg(dw, GPIO_DIR_ID, 0U, in_out);
}

/*! ------------------------------------------------------------------------------------------------------------------
 * @brief This is used to set output value on GPIOs that have been configured for output via dwt_setgpiodir() API
 *
 * input parameters
 * @param dw    - DW3720 chip descriptor handler.
 * @param gpio - should be one or multiple of dwt_gpio_mask_e values
 * @param value - Logic value for GPIO/GPIOs if multiple set at same time.
 *
 * output parameters
 *
 * no return value
 */
static void ull_setgpiovalue(dwchip_t *dw, uint16_t gpio, int32_t value)
{
    /* Set output level for output pin to high. */
    if (value == 1)
    {
        dwt_or16bitoffsetreg(dw, GPIO_OUT_ID, 0U, (uint16_t)gpio);
    }
    /* Set output level for output pin to low. */
    else
    {
        dwt_and16bitoffsetreg(dw, GPIO_OUT_ID, 0U, (uint16_t)~gpio);
    }
}

/*! ------------------------------------------------------------------------------------------------------------------
 * @brief This is used to read the raw value of the GPIO pins.
 *        It is presumed that functions such as dwt_setgpiomode(), dwt_setgpiovalue() and dwt_setgpiodir() are called before this function.
 *
 * input parameters
 * @param dw   - DW3720 chip descriptor handler.
 *
 * @returns a uint16_t value that holds the value read on the GPIO pins.
 */
static uint16_t ull_readgpiovalue(dwchip_t *dw)
{
    return dwt_read16bitoffsetreg(dw, GPIO_RAW_ID, 0);
}

/*! ------------------------------------------------------------------------------------------------------------------
 * @brief This is used to enable GPIO for external LNA or PA functionality - HW dependent, consult the DW3720 User Manual.
 *        This can also be used for debug as enabling TX and RX GPIOs is quite handy to monitor DW3720's activity.
 *
 * NOTE: Enabling PA functionality requires that fine grain TX sequencing is deactivated. This can be done using
 *       dwt_setfinegraintxseq().
 *
 * input parameters
 * @param dw     - DW3720 chip descriptor handler.
 * @param lna_pa - bit field: bit 0 if set will enable LNA functionality,
 *                          : bit 1 if set will enable PA functionality,
 *                          : to disable LNA/PA set the bits to 0
 * output parameters
 *
 * no return value
 */
static void ull_setlnapamode(dwchip_t *dw, int32_t lna_pa)
{
    uint32_t gpio_mode = dwt_read32bitreg(dw, GPIO_MODE_ID);

    // clear GPIO 4, 5, configuration
    gpio_mode &= (~(GPIO_MODE_MSGP4_MODE_BIT_MASK | GPIO_MODE_MSGP5_MODE_BIT_MASK));
    if (((uint16_t)lna_pa & (uint16_t)DWT_LNA_ENABLE) != 0U)
    {
        gpio_mode |= (uint32_t)DW37XX_GPIO_PIN5_PDOA_SW_RX;
    }

    if (((uint16_t)lna_pa & (uint16_t)DWT_PA_ENABLE) != 0U)
    {
        gpio_mode |= (uint32_t)DW37XX_GPIO_PIN4_PDOA_SW_TX;
    }

    if (((uint16_t)lna_pa & (uint16_t)DWT_TXRX_EN) != 0U)
    {
        gpio_mode |= ((uint32_t)DW37XX_GPIO_PIN4_PDOA_SW_TX | (uint32_t)DW37XX_GPIO_PIN5_PDOA_SW_RX);
    }

    dwt_write32bitreg(dw, GPIO_MODE_ID, gpio_mode);
}

/*! ------------------------------------------------------------------------------------------------------------------
 * @brief This is used to return the read OTP revision
 *
 * NOTE: dwt_initialise() must be called prior to this function so that it can return a relevant value.
 *
 * input parameters
 * @param dw - DW3720 chip descriptor handler.
 *
 * output parameters
 *
 * returns the read OTP revision value
 */
static uint8_t ull_otprevision(dwchip_t *dw)
{
    return LOCAL_DATA(dw)->otprev;
}

/*! ------------------------------------------------------------------------------------------------------------------
 * @brief This function overrides the temperature to be used for PLL calibration of the device.
 *        If set to TEMP_INIT (-127), the next time dwt_initialise is called the onchip temperature sensor
 *        will be used to set it.
 * input parameters
 * @param temperature - expected opperating temperature in celcius
 *
 * output parameters none
 *
 * no return value
 */
static void ull_setpllcaltemperature(dwchip_t *dw, int8_t temperature)
{
	LOCAL_DATA(dw)->temperature = temperature;
}

/*! ------------------------------------------------------------------------------------------------------------------
 * @brief This function reads the temperature in celcius that will be used for PLL calibrations
 *
 * input parameters
 *
 * output parameters none
 *
 * returns the temperature in celcius that will be used by PLL calibrations
 */
static int8_t ull_getpllcaltemperature(dwchip_t *dw)
{
    return LOCAL_DATA(dw)->temperature;
}

/*! ------------------------------------------------------------------------------------------------------------------
 * @brief Returns the PG delay value of the TX
 *
 * input parameters
 * @param dw - DW3720 chip descriptor handler.
 *
 * output parameters
 *
 * returns uint8_t
 */
static uint8_t ull_readpgdelay(dwchip_t *dw)
{
    return dwt_read8bitoffsetreg(dw, TX_CTRL_HI_ID, 0U);
}

/*! ------------------------------------------------------------------------------------------------------------------
 * @brief This is used to return the read V measured @ 3.0 V value recorded in OTP address 0x8 (VBAT_ADDRESS)
 *
 * NOTE: dwt_initialise() must be called prior to this function so that it can return a relevant value.
 *
 * input parameters
 * @param dw - DW3720 chip descriptor handler.
 *
 * output parameters
 *
 * returns the 8 bit V bat value as programmed in the factory
 */
static uint8_t ull_geticrefvolt(dwchip_t *dw)
{
    return LOCAL_DATA(dw)->vBatP;
}

/*! ------------------------------------------------------------------------------------------------------------------
 * @brief This is used to return the read T measured @ 22 C value recorded in OTP address 0x9 (VTEMP_ADDRESS)
 *
 * NOTE: dwt_initialise() must be called prior to this function so that it can return a relevant value.
 *
 * input parameters
 * @param dw - DW3720 chip descriptor handler.
 *
 * output parameters
 *
 * returns the 8 bit V temp value as programmed in the factory
 */
static uint8_t ull_geticreftemp(dwchip_t *dw)
{
    return LOCAL_DATA(dw)->tempP;
}

/*! ------------------------------------------------------------------------------------------------------------------
 * @brief This is used to return the read part ID of the device
 *
 * NOTE: dwt_initialise() must be called prior to this function so that it can return a relevant value.
 *
 * input parameters
 * @param dw - DW3720 chip descriptor handler.
 *
 * output parameters
 *
 * returns the 32 bit part ID value as programmed in the factory
 */
static uint32_t ull_getpartid(dwchip_t *dw)
{
    return LOCAL_DATA(dw)->partID;
}

/*! ------------------------------------------------------------------------------------------------------------------
 * @brief This is used to return the read lot ID of the device
 *
 * NOTE: dwt_initialise() must be called prior to this function so that it can return a relevant value.
 *
 * input parameters
 * @param dw - DW3720 chip descriptor handler.
 *
 * output parameters
 *
 * returns the 64 bit lot ID value as programmed in the factory
 */
static uint64_t ull_getlotid(dwchip_t *dw)
{
    return LOCAL_DATA(dw)->lotID;
}

/*! ------------------------------------------------------------------------------------------------------------------
 * @brief This function enables/disables the fine grain TX sequencing (this is enabled by default in the device).
 *
 * input parameters
 * @param dw     - DW3720 chip descriptor handler.
 * @param enable - 1 to enable fine grain TX sequencing, 0 to disable it.
 *
 * output parameters none
 *
 * no return value
 */
static void ull_setfinegraintxseq(dwchip_t *dw, int32_t enable)
{
    if (enable != 0)
    {
        dwt_write32bitoffsetreg(dw, PWR_UP_TIMES_TXFINESEQ_ID, 2U, PMSC_TXFINESEQ_ENABLE);
    }
    else
    {
        dwt_write32bitoffsetreg(dw, PWR_UP_TIMES_TXFINESEQ_ID, 2U, PMSC_TXFINESEQ_DISABLE);
    }
}

/*! ------------------------------------------------------------------------------------------------------------------
 * @brief This function provides the API for the configuration of the TX power
 * The input is the desired tx power to configure.
 *
 * input parameters
 * @param dw        -   DW3000 chip descriptor handler.
 * @param power     -   tx power to configure.
 *
 * output parameters
 *
 * no return value
 */
static void ull_settxpower(dwchip_t *dw, uint32_t power)
{
    dwt_write32bitreg(dw, TX_POWER_ID, power);
}

/*! ------------------------------------------------------------------------------------------------------------------
 * @brief This function provides the API for the configuration of the TX spectrum
 * including the power and pulse generator delay. The input is a pointer to the data structure
 * of type dwt_txconfig_t that holds all the configurable items.
 *
 * input parameters
 * @param dw     - DW3720 chip descriptor handler.
 * @param config - pointer to the txrf configuration structure, which contains the tx rf config data
 *                      If config->PGcount == 0 the PGdelay value will be used, else the PG calibration will run
 *
 * output parameters
 *
 * no return value
 */
static void ull_configuretxrf(dwchip_t *dw, dwt_txconfig_t *config)
{
    if (config->PGcount == 0U)
    {
        // Configure RF TX PG_DELAY
        dwt_write8bitoffsetreg(dw, TX_CTRL_HI_ID, 0U, config->PGdly);
    }
    else
    {
        (void)ull_calcbandwidthadj(dw, config->PGcount);
    }

    // Configure TX power
    dwt_write32bitreg(dw, TX_POWER_ID, config->power);
}

/*! ------------------------------------------------------------------------------------------------------------------
 * @brief This function configures the STS AES 128 bit key value.
 * the default value is [31:00]c9a375fa,
 *                      [63:32]8df43a20,
 *                      [95:64]b5e5a4ed,
 *                     [127:96]0738123b
 *
 * input parameters
 * @param dw - DW3720 chip descriptor handler.
 * @param pStsKey - the pointer to the structure of dwt_sts_cp_key_t type, which holds the AES128 key value to generate STS
 *
 * output parameters
 *
 * no return value
 */
static void ull_configurestskey(dwchip_t *dw, dwt_sts_cp_key_t *pStsKey)
{
    dwt_write32bitreg(dw, STS_KEY0_ID, pStsKey->key0);
    dwt_write32bitreg(dw, STS_KEY1_ID, pStsKey->key1);
    dwt_write32bitreg(dw, STS_KEY2_ID, pStsKey->key2);
    dwt_write32bitreg(dw, STS_KEY3_ID, pStsKey->key3);
}

/*! ------------------------------------------------------------------------------------------------------------------
 * @brief This function configures the STS AES 128 bit initial value, the default value is 1, i.e. DW3720 reset value is 1.
 *
 * input parameters
 * @param dw - DW3720 chip descriptor handler.
 * @param pStsIv - the pointer to the structure of dwt_sts_cp_iv_t type, which holds the IV value to generate STS
 *
 * output parameters
 *
 * no return value
 */
static void ull_configurestsiv(dwchip_t *dw, dwt_sts_cp_iv_t *pStsIv)
{
    dwt_write32bitreg(dw, STS_IV0_ID, pStsIv->iv0);
    dwt_write32bitreg(dw, STS_IV1_ID, pStsIv->iv1);
    dwt_write32bitreg(dw, STS_IV2_ID, pStsIv->iv2);
    dwt_write32bitreg(dw, STS_IV3_ID, pStsIv->iv3);
}

/*! ------------------------------------------------------------------------------------------------------------------
 * @brief This function re-loads the STS initial value
 *
 * input parameters
 * @param dw - DW3720 chip descriptor handler.
 *
 * output parameters
 *
 * no return value
 */
static void ull_configurestsloadiv(dwchip_t *dw)
{
    dwt_or8bitoffsetreg(dw, STS_CTRL_ID, 0U, STS_CTRL_LOAD_IV_BIT_MASK);
}

/*! ------------------------------------------------------------------------------------------------------------------
 * @brief
 *
 * input parameters
 * @param cipher
 * @param threshold
 * @param shift_val
 *
 */
static uint16_t get_sts_mnth(uint16_t cipher, uint8_t threshold, uint8_t shift_val)
{
    uint32_t value;
    uint32_t mod_val;

    value = cipher * (uint32_t)threshold;
    if (shift_val == 3U)
    {
        value *= SQRT_FACTOR; // Factor to sqrt(2)
        value >>= SQRT_SHIFT_VAL;
    }

    mod_val = (value % MOD_VALUE) + HALF_MOD;
    value >>= SHIFT_VALUE;
    /* Check if modulo greater than MOD_VALUE, if yes add 1 */
    if (mod_val >= MOD_VALUE)
    {
        value += 1UL;
    }

    return (uint16_t)value;
}

/*! ------------------------------------------------------------------------------------------------------------------
 * @brief This function sets the default values of the lookup tables depending on the channel selected.
 *
 * input parameters
 * @param[in] dw - DW3720 chip descriptor handler.
 * @param[in] channel - Channel that the device will be transmitting/receiving on.
 *
 * no return value
 */
static void ull_configmrxlut(dwchip_t *dw, int32_t channel)
{
    uint32_t lut0, lut1, lut2, lut3, lut4, lut5, lut6 = 0UL;

    if (channel == 5)
    {
        lut0 = (uint32_t)E0_CH5_DGC_LUT_0;
        lut1 = (uint32_t)E0_CH5_DGC_LUT_1;
        lut2 = (uint32_t)E0_CH5_DGC_LUT_2;
        lut3 = (uint32_t)E0_CH5_DGC_LUT_3;
        lut4 = (uint32_t)E0_CH5_DGC_LUT_4;
        lut5 = (uint32_t)E0_CH5_DGC_LUT_5;
        lut6 = (uint32_t)E0_CH5_DGC_LUT_6;
    }
    else
    {
        lut0 = (uint32_t)E0_CH9_DGC_LUT_0;
        lut1 = (uint32_t)E0_CH9_DGC_LUT_1;
        lut2 = (uint32_t)E0_CH9_DGC_LUT_2;
        lut3 = (uint32_t)E0_CH9_DGC_LUT_3;
        lut4 = (uint32_t)E0_CH9_DGC_LUT_4;
        lut5 = (uint32_t)E0_CH9_DGC_LUT_5;
        lut6 = (uint32_t)E0_CH9_DGC_LUT_6;
    }
    dwt_write32bitoffsetreg(dw, DGC_CFG0_ID, 0x0U, DWT_DGC_CFG0);
    dwt_write32bitoffsetreg(dw, DGC_CFG1_ID, 0x0U, DWT_DGC_CFG1);
    dwt_write32bitoffsetreg(dw, DGC_CFG2_ID, 0x0U, DWT_DGC_CFG2);

    dwt_write32bitoffsetreg(dw, DGC_LUT_0_CFG_ID, 0x0U, lut0);
    dwt_write32bitoffsetreg(dw, DGC_LUT_1_CFG_ID, 0x0U, lut1);
    dwt_write32bitoffsetreg(dw, DGC_LUT_2_CFG_ID, 0x0U, lut2);
    dwt_write32bitoffsetreg(dw, DGC_LUT_3_CFG_ID, 0x0U, lut3);
    dwt_write32bitoffsetreg(dw, DGC_LUT_4_CFG_ID, 0x0U, lut4);
    dwt_write32bitoffsetreg(dw, DGC_LUT_5_CFG_ID, 0x0U, lut5);
    dwt_write32bitoffsetreg(dw, DGC_LUT_6_CFG_ID, 0x0U, lut6);
}

/*! ------------------------------------------------------------------------------------------------------------------
 * @brief This function needs to be called after device is woken up from DEEPSLEEP/SLEEP state, to restore the
 * configuration which has not been automatically restored from AON
 *
 * input parameters
 * @param dw - DW3720 chip descriptor handler.
 * @param full_restore - If set to 0, the function will skip DGC update, PGC and ADC offset calibration.
 *                     - If set to any other value, the function will perform the complete update.
 *
 */
static void ull_restoreconfig(dwchip_t *dw, int32_t full_restore)
{
    uint8_t channel = 5U;
    uint16_t chan_ctrl;

    // restore/enable the OTP IPS for normal OTP use
    ull_dis_otp_ips(dw, 0);

    // CIA diagnostic should be enabled when in DB mode, otherwise the data in diagnostic
    // SETs will be empty/invalid
    if ((LOCAL_DATA(dw)->cia_diagnostic >> 1U) == 0U)
    {
        dwt_write8bitoffsetreg(dw, RDB_DIAG_MODE_ID, 0U, (uint8_t)((uint8_t)DW_CIA_DIAG_LOG_MIN >> 1U));
        LOCAL_DATA(dw)->cia_diagnostic |= (uint8_t)DW_CIA_DIAG_LOG_MIN;
    }
    else
    {
        dwt_write8bitoffsetreg(dw, RDB_DIAG_MODE_ID, 0U, LOCAL_DATA(dw)->cia_diagnostic >> 1U);
    }

    if (full_restore != 0)
    {
        chan_ctrl = dwt_read16bitoffsetreg(dw, CHAN_CTRL_ID, 0U);

        // assume RX code is the same as TX (e.g. we will not RX on 16 MHz or SCP and TX on 64 MHz)
        // only enable DGC for PRF 64
        if ((((chan_ctrl & CHAN_CTRL_TX_PCODE_BIT_MASK) >> CHAN_CTRL_TX_PCODE_BIT_OFFSET) >= 9U)
            && (((chan_ctrl & CHAN_CTRL_TX_PCODE_BIT_MASK) >> CHAN_CTRL_TX_PCODE_BIT_OFFSET) <= 24U))
        {
            if ((chan_ctrl & 0x1U) != 0U)
            {
                channel = 9;
            }

            /* If the OTP has DGC info programmed into it, do a manual kick from OTP. */
            if (LOCAL_DATA(dw)->dgc_otp_set != (uint8_t)DWT_DGC_LOAD_FROM_OTP)
            {
                ull_configmrxlut(dw, (int32_t)channel); /* Manually program hard-coded values into the DGC registers. */
            }
        }
        dwt_write32bitreg(dw, TX_CTRL_LO_ID, TX_CTRL_LO_DEF);
        (void)ull_pgf_cal(dw, 1);

        (void)ull_adcoffsetscalibration(dw);
    }
}

/*! ------------------------------------------------------------------------------------------------------------------
 * @brief This function configures STS mode: e.g. DWT_STS_MODE_OFF, DWT_STS_MODE_1 etc
 * The dwt_configure should be called prior to this to configure other parameters
 *
 * input parameters
 * @param dw      - DW3720 chip descriptor handler.
 * @param stsMode - e.g. DWT_STS_MODE_OFF, DWT_STS_MODE_1 etc.
 *
 * @return DWT_SUCCESS
 *
 */
static void ull_configurestsmode(dwchip_t *dw, uint8_t stsMode)
{
    LOCAL_DATA(dw)->stsconfig = stsMode;

    /////////////////////////////////////////////////////////////////////////
    // SYS_CFG
    // clear the PHR Mode, PHR Rate, STS Protocol, SDC, PDOA Mode,
    // then set the relevant bits according to configuration of the PHR Mode, PHR Rate, STS Protocol, SDC, PDOA Mode,
    dwt_modify16bitoffsetreg(dw, SYS_CFG_ID, 0, (uint16_t) ~(SYS_CFG_CP_SPC_BIT_MASK | SYS_CFG_CP_SDC_BIT_MASK),
        ((uint16_t)stsMode & (uint16_t)DWT_STS_CONFIG_MASK) << SYS_CFG_CP_SPC_BIT_OFFSET);
    if (((uint16_t)stsMode & (uint16_t)DWT_STS_MODE_ND) == (uint16_t)DWT_STS_MODE_ND)
    {
        // configure lower preamble detection threshold for no data STS mode
        dwt_write32bitoffsetreg(dw, DTUNE3_ID, 0U, PD_THRESH_NO_DATA);
    }
    else
    {
        dwt_write32bitoffsetreg(dw, DTUNE3_ID, 0U, PD_THRESH_DEFAULT);
    }
}

/*! ------------------------------------------------------------------------------------------------------------------
 * @brief This function will configure the PDOA mode.
 *
 * input parameters
 * @param pdoaMode - PDOA mode
 *
 * NOTE: to modify preamble length or STS length call dwt_configure first or dwt_setstslength.
 *
 * @return DWT_SUCCESS or DWT_ERROR if bad parameters.
 */
static int32_t ull_setpdoamode(dwchip_t *dw, dwt_pdoa_mode_e pdoaMode)
{
    if ((pdoaMode != DWT_PDOA_M0) && (pdoaMode != DWT_PDOA_M1) && (pdoaMode != DWT_PDOA_M3))
    {
        return (int32_t)DWT_ERROR;
    }

    /* Set PDoA mode in SYS_CFG register. */
    dwt_modify32bitoffsetreg(dw, SYS_CFG_ID, 0x0U, ~SYS_CFG_PDOA_MODE_BIT_MASK, ((uint32_t)pdoaMode) << SYS_CFG_PDOA_MODE_BIT_OFFSET);

    if (LOCAL_DATA(dw)->stsconfig != (uint8_t)DWT_STS_MODE_OFF)
    {
        uint16_t sts_mnth;
        // configure CIA STS lower bound
        if ((pdoaMode == DWT_PDOA_M1) || (pdoaMode == DWT_PDOA_M0))
        {
            // In PDOA mode 1, number of accumulated symbols is the whole length of the STS
            sts_mnth = get_sts_mnth(sts_length_factors[(uint8_t)(LOCAL_DATA(dw)->stsLength)], CIA_MANUALLOWERBOUND_TH_64, 3U);
        }
        else
        {
            // In PDOA mode 3 number of accumulated symbols is half of the length of STS symbols
            sts_mnth = get_sts_mnth(sts_length_factors[(uint8_t)(LOCAL_DATA(dw)->stsLength)], CIA_MANUALLOWERBOUND_TH_64, 4U);
        }
         LOCAL_DATA(dw)->preamble_len += ((uint16_t)LOCAL_DATA(dw)->stsLength) * 8U;

        dwt_modify16bitoffsetreg(dw, STS_CONFIG_LO_ID, 2U, (uint16_t)~(STS_CONFIG_LO_STS_MAN_TH_BIT_MASK >> 16UL), sts_mnth & 0x7FU);
    }
    /* Disable ADC count and peak growth checks */
    dwt_modify32bitoffsetreg(dw, STS_CONFIG_HI_ID, 0U, ~(STS_CONFIG_HI_STS_PGR_EN_BIT_MASK | STS_CONFIG_HI_STS_SS_EN_BIT_MASK | STS_CONFIG_HI_B0_MASK), STS_CONFIG_HI_RES);

    if (pdoaMode == DWT_PDOA_M1)
    {
        dwt_modify8bitoffsetreg(dw, DTUNE0_ID, 0U,  (uint8_t)~DTUNE0_DT0B4_BIT_MASK, 0); /* Disable STS CMF */
    }
    else
    {
        dwt_modify8bitoffsetreg(dw, DTUNE0_ID, 0U,  (uint8_t)0xFF, (const uint8_t)DTUNE0_DT0B4_BIT_MASK); /* Enable STS CMF */
    }

    return (int32_t)DWT_SUCCESS;
}

/*! ------------------------------------------------------------------------------------------------------------------
 * @brief This function provides the main API for the configuration of the
 * DW3720 and this low-level driver.  The input is a pointer to the data structure
 * of type dwt_config_t that holds all the configurable items.
 * The dwt_config_t structure shows which ones are supported
 *
 * input parameters
 * @param dw     - DW3720 chip descriptor handler.
 * @param config - pointer to the configuration structure, which contains the device configuration data.
 *
 * @return DWT_SUCCESS or DWT_ERROR
 * Note: If the RX calibration routine fails the device receiver performance will be severely affected,
 * the application should reset device and try again
 *
 */
static int32_t ull_configure(dwchip_t *dw, dwt_config_t *config)
{
    uint8_t chan = config->chan;
    uint32_t temp;
    uint8_t scp = ((config->rxCode > 24U) || (config->txCode > 24U)) ? 1U : 0U;
    uint8_t mode = (config->phrMode == DWT_PHRMODE_EXT) ? (uint8_t)SYS_CFG_PHR_MODE_BIT_MASK : 0U;
    uint16_t sts_len;
    int32_t error = (int32_t)DWT_SUCCESS;
    // config->pdoaMode &= 0x7f; //clear MSB // REVIEWME: check if necessary
#if DWT_DEBUG_PRINT
    printf("dwt_configure=PAC>%d:BR>%d:PC>%d:PL>%d:CH>%d:CPMode>%d:CPLen>%d:PDOA>%d\n", config->rxPAC, config->dataRate, config->rxCode, config->txPreambLength,
        config->chan, config->stsMode, config->stsLength, config->pdoaMode);
#endif

#ifdef DWT_API_ERROR_CHECK
    assert((config->dataRate == DWT_BR_6M8) || (config->dataRate == DWT_BR_850K));
    assert(config->rxPAC <= DWT_PAC4);
    assert((chan == (uint8_t)DWT_CH5) || (chan == (uint8_t)DWT_CH9));
    assert(((config->txPreambLength >= 1) && (config->txPreambLength <= DWT_PLEN_2048)) || (config->txPreambLength == DWT_PLEN_4096));
    assert((config->phrMode == DWT_PHRMODE_STD) || (config->phrMode == DWT_PHRMODE_EXT));
    assert((config->phrRate == DWT_PHRRATE_STD) || (config->phrRate == DWT_PHRRATE_DTA));
    assert((config->pdoaMode == DWT_PDOA_M0) || (config->pdoaMode == DWT_PDOA_M1) || (config->pdoaMode == DWT_PDOA_M3));
    assert(((config->stsMode & DWT_STS_CONFIG_MASK) == DWT_STS_MODE_OFF) || ((config->stsMode & DWT_STS_CONFIG_MASK) == DWT_STS_MODE_1)
           || ((config->stsMode & DWT_STS_CONFIG_MASK) == DWT_STS_MODE_2) || ((config->stsMode & DWT_STS_CONFIG_MASK) == DWT_STS_MODE_ND)
           || ((config->stsMode & DWT_STS_CONFIG_MASK) == DWT_STS_MODE_SDC) || ((config->stsMode & DWT_STS_CONFIG_MASK) == (DWT_STS_MODE_1 | DWT_STS_MODE_SDC))
           || ((config->stsMode & DWT_STS_CONFIG_MASK) == (DWT_STS_MODE_2 | DWT_STS_MODE_SDC))
           || ((config->stsMode & DWT_STS_CONFIG_MASK) == (DWT_STS_MODE_ND | DWT_STS_MODE_SDC))
           || ((config->stsMode & DWT_STS_CONFIG_MASK) == DWT_STS_CONFIG_MASK));
#endif
    uint32_t sts_threshold_calc;

    LOCAL_DATA(dw)->preamble_len = ((config->txPreambLength + 1U) * 8U);

    LOCAL_DATA(dw)->sleep_mode &= (~((uint16_t)DWT_ALT_OPS | (uint16_t)DWT_SEL_OPS3)); // clear the sleep mode ALT_OPS bit
    LOCAL_DATA(dw)->longFrames = (uint8_t)config->phrMode;
    sts_len = GET_STS_REG_SET_VALUE((uint16_t)(config->stsLength));
    sts_threshold_calc = (((uint32_t)sts_len * 8UL * STSQUAL_THRESH_64_SH15) >> 15UL);
    LOCAL_DATA(dw)->ststhreshold = (int16_t)sts_threshold_calc;
    LOCAL_DATA(dw)->stsconfig = (uint8_t)config->stsMode;

#ifdef AUTO_PLL_CAL
    // Set the temperature of the device so calibration can use it.
    uint16_t tempvbat = ull_readtempvbat(dw);
    LOCAL_DATA(dw)->temperature = ull_convertrawtemperature(dw, tempvbat >> 8U);  // Temperature in upper 8 bits

    if((LOCAL_DATA(dw)->temperature >= 0) && (LOCAL_DATA(dw)->vdddig_otp != 0U)) // If OTP is not provisioned, we cannot use set_vdddig_mv
    {
        error = ull_set_vdddig_mv(dw, VDDDIG_88mV);
    }
    else
    {
        error = ull_set_vdddig_mv(dw, VDDDIG_93mV);
    }
#endif

    /////////////////////////////////////////////////////////////////////////
    // SYS_CFG
    // clear the PHR Mode, PHR Rate, STS Protocol, SDC, PDOA Mode,
    // then set the relevant bits according to configuration of the PHR Mode, PHR Rate, STS Protocol, SDC, PDOA Mode,
    dwt_modify32bitoffsetreg(dw, SYS_CFG_ID, 0U,
        ~(SYS_CFG_PHR_MODE_BIT_MASK | SYS_CFG_PHR_6M8_BIT_MASK | SYS_CFG_CP_SPC_BIT_MASK | SYS_CFG_PDOA_MODE_BIT_MASK | SYS_CFG_CP_SDC_BIT_MASK),
        ((uint32_t)config->pdoaMode) << (uint32_t)SYS_CFG_PDOA_MODE_BIT_OFFSET | ((uint32_t)config->stsMode & (uint32_t)DWT_STS_CONFIG_MASK) << SYS_CFG_CP_SPC_BIT_OFFSET
            | (SYS_CFG_PHR_6M8_BIT_MASK & ((uint32_t)config->phrRate << (uint32_t)SYS_CFG_PHR_6M8_BIT_OFFSET)) | (uint32_t)mode);

    /* Cache variables needed for ull_setpdoamode(). */
    LOCAL_DATA(dw)->stsLength = config->stsLength;

    if (scp != 0U)
    {
        // configure OPS tables for SCP mode
        LOCAL_DATA(dw)->sleep_mode |= (uint16_t)DWT_ALT_OPS | (uint16_t)DWT_SEL_OPS1; // configure correct OPS table is kicked on wakeup
        dwt_modify32bitoffsetreg(dw, OTP_CFG_ID, 0U, ~(OTP_CFG_OPS_ID_BIT_MASK), DWT_OPSET_SCP | OTP_CFG_OPS_KICK_BIT_MASK);

        dwt_write32bitoffsetreg(dw, IP_CONFIG_LO_ID, 0U, IP_CONFIG_LO_SCP); // Set this if Ipatov analysis is used in SCP mode
        dwt_write32bitoffsetreg(dw, IP_CONFIG_HI_ID, 0U, IP_CONFIG_HI_SCP);

        dwt_write32bitoffsetreg(dw, STS_CONFIG_LO_ID, 0U, STS_CONFIG_LO_SCP);
        /* Disable ADC count and peak growth checks */
        dwt_modify32bitoffsetreg(dw, STS_CONFIG_HI_ID, 0U, ~(STS_CONFIG_HI_STS_PGR_EN_BIT_MASK | STS_CONFIG_HI_STS_SS_EN_BIT_MASK | STS_CONFIG_HI_B0_MASK), STS_CONFIG_HI_SCP);
    }
    else //
    {
        error = ull_setpdoamode(dw, config->pdoaMode);
        if(error != (int32_t)DWT_SUCCESS)
        {
            return error;
        }

        // configure OPS tables for non-SCP mode
        if ( LOCAL_DATA(dw)->preamble_len >= 256U)
        {
            LOCAL_DATA(dw)->sleep_mode |= (uint16_t)DWT_ALT_OPS | (uint16_t)DWT_SEL_OPS0;
            dwt_modify16bitoffsetreg(dw, OTP_CFG_ID, 0U, ~((uint16_t)OTP_CFG_OPS_ID_BIT_MASK),
                                     (uint16_t)DWT_OPSET_LONG | (uint16_t)OTP_CFG_OPS_KICK_BIT_MASK);
        }
        else
        {
            LOCAL_DATA(dw)->sleep_mode |= (uint16_t)DWT_ALT_OPS | (uint16_t)DWT_SEL_OPS2; // Short OPS table - set to be loaded as default
            dwt_modify16bitoffsetreg(dw, OTP_CFG_ID, 0U, (uint16_t) ~(OTP_CFG_OPS_ID_BIT_MASK),
                                     (uint16_t)DWT_OPSET_SHORT | (uint16_t)OTP_CFG_OPS_KICK_BIT_MASK);
        }
    }

    ull_enable_disable_eq(dw, 1U); //the equaliser should be enabled in all modes (using it reduces range bias)

    if (config->pdoaMode == DWT_PDOA_M1)
    {
        dwt_modify8bitoffsetreg(dw, DTUNE0_ID, 0U, (uint8_t)~(DTUNE0_PRE_PAC_SYM_BIT_MASK | DTUNE0_DT0B4_BIT_MASK), (uint8_t)config->rxPAC); /* Disable STS CMF, and configure PAC size */
    }
    else
    {
        dwt_modify8bitoffsetreg(dw, DTUNE0_ID, 0U, (uint8_t)~DTUNE0_PRE_PAC_SYM_BIT_MASK, (uint8_t)config->rxPAC | DTUNE0_DT0B4_BIT_MASK); /* Enable STS CMF, and configure PAC size */
    }

    dwt_write8bitoffsetreg(dw, STS_CFG0_ID, 0U, (uint8_t)(sts_len - 1U)); /* Starts from 0 that is why -1*/

    if (((uint16_t)(config->stsMode) & (uint16_t)DWT_STS_MODE_ND) == (uint16_t)DWT_STS_MODE_ND)
    {
        // configure lower preamble detection threshold for no data STS mode
        dwt_write32bitoffsetreg(dw, DTUNE3_ID, 0U, PD_THRESH_NO_DATA);
    }
    else
    {
        // configure default preamble detection threshold for other modes
        dwt_write32bitoffsetreg(dw, DTUNE3_ID, 0U, PD_THRESH_DEFAULT);
    }

    /////////////////////////////////////////////////////////////////////////
    // CHAN_CTRL
    temp = dwt_read32bitoffsetreg(dw, CHAN_CTRL_ID, 0U);
    temp &= (~(CHAN_CTRL_RX_PCODE_BIT_MASK | CHAN_CTRL_TX_PCODE_BIT_MASK | CHAN_CTRL_SFD_TYPE_BIT_MASK));

    temp |= (CHAN_CTRL_RX_PCODE_BIT_MASK & ((uint32_t)config->rxCode << CHAN_CTRL_RX_PCODE_BIT_OFFSET));
    temp |= (CHAN_CTRL_TX_PCODE_BIT_MASK & ((uint32_t)config->txCode << CHAN_CTRL_TX_PCODE_BIT_OFFSET));
    temp |= (CHAN_CTRL_SFD_TYPE_BIT_MASK & ((uint32_t)config->sfdType << CHAN_CTRL_SFD_TYPE_BIT_OFFSET));

    dwt_write32bitoffsetreg(dw, CHAN_CTRL_ID, 0U, temp);

    if(config->txPreambLength == DWT_PLEN_4096)
    {
        // DW3720 accept DWT_PLEN_4096 only via TXPSR field
        // clear the setting in the FINE_PLEN register.
        ull_setplenfine(dw, 0u);

        /////////////////////////////////////////////////////////////////////////
        // TX_FCTRL
        // Set up TX Preamble Size, PRF and Data Rate
        dwt_modify32bitoffsetreg(dw, TX_FCTRL_ID, 0U, ~(TX_FCTRL_TXBR_BIT_MASK | TX_FCTRL_TXPSR_BIT_MASK),
            ((uint32_t)config->dataRate << TX_FCTRL_TXBR_BIT_OFFSET) | (0x3UL) << TX_FCTRL_TXPSR_BIT_OFFSET);
    }
    else
    {
        // In the other cases set directly via ull_setplenfine
        ull_setplenfine(dw, (uint8_t)config->txPreambLength);

        /////////////////////////////////////////////////////////////////////////
        // TX_FCTRL
        // Set up TX Preamble Size, PRF and Data Rate
        dwt_modify32bitoffsetreg(dw, TX_FCTRL_ID, 0U, ~(TX_FCTRL_TXBR_BIT_MASK | TX_FCTRL_TXPSR_BIT_MASK),
            ((uint32_t)config->dataRate << TX_FCTRL_TXBR_BIT_OFFSET));
    }

    // DTUNE (SFD timeout)
    // Don't allow 0 - SFD timeout will always be enabled
    if (config->sfdTO == 0U)
    {
        config->sfdTO = DWT_SFDTOC_DEF;
    }
    dwt_write16bitoffsetreg(dw, DTUNE0_ID, 2U, config->sfdTO);

    error = ull_setchannel(dw, chan);
    if( error != (int32_t)DWT_SUCCESS )
    {
        return error;
    }

    // only enable DGC for PRF 64
    if ((config->rxCode >= 9U) && (config->rxCode <= 24U))
    {
        // load RX LUTs
        /* If the OTP has DGC info programmed into it, do a manual kick from OTP. */
        if (LOCAL_DATA(dw)->dgc_otp_set != (uint8_t)DWT_DGC_LOAD_FROM_OTP)
        {
            ull_configmrxlut(dw, (int32_t)chan); /* Else we manually program hard-coded values into the DGC registers. */
            LOCAL_DATA(dw)->sleep_mode &= ~((uint16_t)DWT_LOADDGC);
        }
        else
        {
            dwt_or16bitoffsetreg(dw, OTP_CFG_ID, 0U, OTP_CFG_DGC_KICK_BIT_MASK);
            // configure kick bits for when waking up
            LOCAL_DATA(dw)->sleep_mode |= (uint16_t)DWT_LOADDGC;
        }

        dwt_modify16bitoffsetreg(dw, DGC_CFG_ID, 0x0U, (uint16_t)~DGC_CFG_THR_64_BIT_MASK, (uint16_t)DWT_DGC_CFG << DGC_CFG_THR_64_BIT_OFFSET);
    }
    else
    {
        dwt_and8bitoffsetreg(dw, DGC_CFG_ID, 0x0U, (uint8_t)~DGC_CFG_RX_TUNE_EN_BIT_MASK);
    }

    if (LOCAL_DATA(dw)->preamble_len > 64U)
    {
        dwt_modify32bitoffsetreg(dw, DTUNE4_ID, 0x0U, (uint32_t)~DTUNE4_RX_SFD_HLDOFF_BIT_MASK, (uint32_t)RX_SFD_HLDOFF);
    }
    else //set default value for <= 64
    {
        dwt_modify32bitoffsetreg(dw, DTUNE4_ID, 0x0U, (uint32_t)~DTUNE4_RX_SFD_HLDOFF_BIT_MASK, (uint32_t)RX_SFD_HLDOFF_DEF);
    }

    ///////////////////////
    // DEFAULT: AGC DISABLE
    dwt_and32bitoffsetreg(dw, AGC_CFG_ID, 0x0U, AGC_CFG_AGC_DIS_MASK);

    dwt_write32bitreg(dw, TX_CTRL_LO_ID, TX_CTRL_LO_DEF);

    ///////////////////////
    // PGF
    // Update: limited number of silicon shown that running PGF_CAL solely after power-on may lead to reduced receiver performance.
    // Systematically running PGF_CAL during device configuration ensures best receiver performance.
    //
    // if the RX calibration routine fails the device receiver performance will be severely affected, the application should reset and try again
    error = ull_pgf_cal(dw, 1);

#if DWT_DEBUG_PRINT
    if (error != (int32_t)DWT_SUCCESS)
    {
        printf("\nPGF CAL FAIL!!\n\n");
        printf("Result:%d\n", error);
    }
#endif
    error = ull_adcoffsetscalibration(dw);
    return error;
} // end ull_configure()

/*! ------------------------------------------------------------------------------------------------------------------
 * @brief This function runs the PGF calibration. This is needed prior to reception.
 * Note: If the RX calibration routine fails the device receiver performance will be severely affected, the application should reset and try again
 *
 * input parameters
 * @param dw    - DW3720 chip descriptor handler.
 * @param ldoen - if set to 1 the function will enable LDOs prior to calibration and disable afterwards.
 *
 * return result of PGF calibration (DWT_ERROR/-1 = error)
 */
static int32_t ull_pgf_cal(dwchip_t *dw, int32_t ldoen)
{
    int32_t temp;
    uint16_t val;

    // PGF needs LDOs turned on - ensure PGF LDOs are enabled
    if (ldoen == 1)
    {
        val = dwt_read16bitoffsetreg(dw, LDO_CTRL_ID, 0U);

        dwt_or16bitoffsetreg(dw, LDO_CTRL_ID, 0U,
            (uint16_t)(LDO_CTRL_LDO_VDDIF2_EN_BIT_MASK | LDO_CTRL_LDO_VDDMS3_EN_BIT_MASK | LDO_CTRL_LDO_VDDMS2_EN_BIT_MASK | // This usually enabled already for the PLL
                LDO_CTRL_LDO_VDDMS1_EN_BIT_MASK));
    }
    // Give the reference time to settle after enabling 4 LDOs simultaneously
    deca_usleep(DELAY_20uUSec);

    // Run PGF Cal
    temp = ull_run_pgfcal(dw);

    // Turn off RX LDOs if previously off
    if (ldoen == 1)
    {
        dwt_and16bitoffsetreg(dw, LDO_CTRL_ID, 0U, val); // restore LDO values
    }
    return temp;
}

/*! ------------------------------------------------------------------------------------------------------------------
 * @brief This function runs the PGF calibration. This is needed prior to reception.
 *
 * input parameters
 * @param dw - DW3720 chip descriptor handler.
 *
 * return result of PGF calibration (DWT_ERROR/-1 = error)
 */
static int32_t ull_run_pgfcal(dwchip_t *dw)
{
    int32_t result = (int32_t)DWT_SUCCESS;
    uint32_t val = 0UL;
    uint8_t cnt, flag;
    // put into cal mode
    dwt_or8bitoffsetreg(dw, RX_CAL_CFG_ID, 0x0U, RX_CAL_CFG_CAL_MODE_BIT_MASK & 0x1U);
    // Trigger PGF Cal
    dwt_or8bitoffsetreg(dw, RX_CAL_CFG_ID, 0x0U, RX_CAL_CFG_CAL_EN_BIT_MASK);

    flag = 1U;
    for (cnt = 0U; cnt < MAX_RETRIES_FOR_PGF; cnt++)
    {
        deca_usleep(DELAY_20uUSec);
        if (dwt_read8bitoffsetreg(dw, RX_CAL_STS_ID, 0x0U) == 1U)
        { // PGF cal is complete
            flag = 0U;
            break;
        }
    }
    if (flag != 0U)
    {
        result = (int32_t)DWT_ERR_RX_CAL_PGF;
    }

    // Put into normal mode
    dwt_write8bitoffsetreg(dw, RX_CAL_CFG_ID, 0x0U, 0U);
    dwt_write8bitoffsetreg(dw, RX_CAL_STS_ID, 0x0U, 1U); // clear the status
    dwt_or8bitoffsetreg(dw, RX_CAL_CFG_ID, 0x2U, 0x1U);  // enable reading
    val = dwt_read32bitoffsetreg(dw, RX_CAL_RESI_ID, 0x0U);
    if (val == ERR_RX_CAL_FAIL)
    {
        // PGF I Cal Fail
        result = (int32_t)DWT_ERR_RX_CAL_RESI;
    }
    val = dwt_read32bitoffsetreg(dw, RX_CAL_RESQ_ID, 0x0U);
    if (val == ERR_RX_CAL_FAIL)
    {
        // PGF Q Cal Fail
        result = (int32_t)DWT_ERR_RX_CAL_RESQ;
    }

    return result;
}

/*! ------------------------------------------------------------------------------------------------------------------
 * @brief This function runs the ADC calibration. This is needed prior to reception.
 *
 * NOTE: device needs to be in IDLE/IDLE_PLL prior to running calibration
 * input parameters:
 * @param dw - DW3720 chip descriptor handler.
 *
 * output parameters
 *
 * no return value
 */
#define ADC_CAL_I_START_VAL  (0xffff0000UL)
#define ADC_CAL_Q_START_VAL  (0x0000ffffUL)
#define ADC_CAL_PN_START_VAL (0x8080UL)
#define ADC_CFG_CAL_VAL      (0x7FCE0AA4UL)

#define TH_POS_OFFSET  0UL
#define TH_NEG_OFFSET  8UL
#define ADC_START_STEP 0x80U
#define ADC_NUM_STEP   8

static uint8_t calc_new_th(uint8_t th, uint32_t iq_n, int16_t dec_step)
{
#if (DWT_DEBUG_PRINT == 1)
    printf("\t%02x %d %d %02x\n", th, iq_n, dec_step);
    deca_sleep(1); // Necessary to allow UART to flush
#endif
    /* Calculate the new threshold value, if the iq_n is below threshold
     * then we decrement by dec_step, otherwise we increment by dec_step
     */
	if (iq_n < 0x1FFUL) //new is < 0x1FF, crossed the threshold
	{
		th = (th - (uint8_t)dec_step);
	}
	else //new is still > 511 threshold
	{
		th = (th + (uint8_t)dec_step);
	}

    return th;
}

static int32_t check_updated_th(uint32_t iq_, uint32_t iq_p, int16_t *best_diff)
{
    int16_t diff, diff_p;
    diff_p = 0x1FF - (int16_t)iq_p; //previous difference
    diff = 0x1FF - (int16_t)iq_; //current difference

    //if negative - make positive
    if (diff_p < 0)
    {
        diff_p = -diff_p;
    }
    if (diff < 0){
        diff = -diff;
    }

    //update threshold -- looking for one which gives value closest to 511
    //and has to be better than the best so far
    if ((diff_p > diff) && (diff < (*best_diff)))
    {
#if (DWT_DEBUG_PRINT == 1)
        printf("\t!!!UPDATE!!! %d > %d (new value closer to 511, < %d)\n", diff_p, diff, (*best_diff));
        deca_sleep(1U); // Necessary to allow UART to flush
#endif
        (*best_diff) = diff;
        return 1;
    }

    return 0;
}

static int32_t ull_adcoffsetscalibration(dwchip_t *dw)
{
    int32_t result = (int32_t)DWT_SUCCESS;
    uint32_t final_thresholds = 0UL; // contains final threshold values to save in ADC_ZERO_THRESH_CFG
    uint32_t threshold = ADC_CAL_I_START_VAL; // I loop starting value
    uint32_t neg_pos = ADC_CAL_PN_START_VAL; // starting value (mid-code FS/2) --- neg [15:8], pos [7:0]
    uint32_t i_neg_pos, q_neg_pos;
    uint8_t offset = 0U;
    uint8_t dec_step = ADC_START_STEP;
    uint32_t adc_def = dwt_read32bitoffsetreg(dw, ADC_CFG_ID, 0U);
    uint32_t agc_def = dwt_read32bitoffsetreg(dw, AGC_CFG_ID, 0U);
    uint16_t q_pos, q_neg, i_pos, i_neg;         // current value
    uint16_t q_pos_p, q_neg_p, i_pos_p, i_neg_p; // previous value
    uint32_t adcdebug;
    int16_t i_best_diff_n = 0x3ff, i_best_diff_p = 0x3ff;
    int16_t q_best_diff_n = 0x3ff, q_best_diff_p = 0x3ff;

    int32_t count = 1; //allow up to 8 steps ... : 0x80, 0x40, 0x20, 0x10, 0x8, 0x4, 0x2, 0x1

    // ensure device is in IDLE
    ull_forcetrxoff(dw);

    // set ADC_CFG value
    dwt_write32bitoffsetreg(dw, ADC_CFG_ID, 0U, ADC_CFG_CAL_VAL);

    // set ADC independent thresholds
    dwt_write8bitoffsetreg(dw, AGC_CFG_ID, 3U, 0U);

	// Enable LDOs for ADC blocks
    dwt_or32bitoffsetreg(dw, LDO_CTRL_ID, 0U,
        (LDO_CTRL_LDO_VDDPLL_VREF_BIT_MASK | LDO_CTRL_LDO_VDDVCO_VREF_BIT_MASK | LDO_CTRL_LDO_VDDMS3_VREF_BIT_MASK | LDO_CTRL_LDO_VDDMS2_VREF_BIT_MASK | LDO_CTRL_LDO_VDDMS1_VREF_BIT_MASK) |
        (LDO_CTRL_LDO_VDDPLL_EN_BIT_MASK | LDO_CTRL_LDO_VDDVCO_EN_BIT_MASK | LDO_CTRL_LDO_VDDMS3_EN_BIT_MASK | LDO_CTRL_LDO_VDDMS2_EN_BIT_MASK | LDO_CTRL_LDO_VDDMS1_EN_BIT_MASK));

    // Enable RF blocks for ADC (configure RF_ENABLE_ID reg)
    dwt_or32bitoffsetreg(dw, RF_ENABLE_ID, 0U, (RF_ENABLE_PLL_CH5_BIT_MASK | RF_ENABLE_PLL_RST_N_BIT_MASK | RF_ENABLE_PLL_EN_BIT_MASK) |
        (RF_ENABLE_ADCQ_EN_BIT_MASK | RF_ENABLE_ADCI_EN_BIT_MASK));

    // turn off auto TX/RX sequencing
    dwt_and32bitoffsetreg(dw, SEQ_CTRL_ID, 0U, ~(SEQ_CTRL_AUTO_RX_SEQ_BIT_MASK | SEQ_CTRL_RF_CTRL_BIT_MASK | SEQ_CTRL_LDO_CTRL_BIT_MASK));

    // Enable RX clocks
    ull_force_clocks(dw, FORCE_CLK_RX_ADC);

    // Perform binary search - to find correct zero-crossing thresholds
    q_neg_p = q_pos_p = i_neg_p = i_pos_p = 0U; //set previous value to 0

    count = ADC_NUM_STEP; //reset step count
    dec_step = ADC_START_STEP; //reset step

    i_neg_pos = q_neg_pos = ADC_CAL_PN_START_VAL; //reset starting threshold
    i_best_diff_n = 0x3ff;
    i_best_diff_p = 0x3ff;
    q_best_diff_n = 0x3ff;
    q_best_diff_p = 0x3ff;
    offset = 16;

    //get POS/NEG threshold
    //each step reduces/increases the threshold by 1/2 of previous step value, there are 8 bits, thus 8 steps
    while (count > 0)
    {
        count--;
        (void)dwt_rxenable((int)DWT_START_RX_IMMEDIATE);

        //decrement the threshold step
        dec_step = dec_step >> 1U;

        threshold = i_neg_pos + (q_neg_pos << offset);

        dwt_write32bitoffsetreg(dw, ADC_THRESH_CFG_ID, 0U, threshold);
#if (DWT_DEBUG_PRINT == 1)
        printf("ADC_TH: %08x, step %02x\n", threshold, dec_step);
        deca_sleep(1U); // Necessary to allow UART to flush
#endif
        dwt_modify8bitoffsetreg(dw, MRX_CFG_ID, 0, 0xFEU, 0U); // Unfreeze
        dwt_modify8bitoffsetreg(dw, MRX_CFG_ID, 0, 0xFEU, 1U); // Freeze

        dwt_forcetrxoff();

        uint32_t iq_neg_th = (q_neg_pos >> TH_NEG_OFFSET) & 0xFFUL; //current negative threshold
        uint32_t iq_pos_th = (q_neg_pos >> TH_POS_OFFSET) & 0xFFUL; //current positive threshold
        neg_pos = 0;

        //get current statistics values
        adcdebug = dwt_read32bitoffsetreg(dw, ADC_DBG_ID, 2U);
        q_neg = (uint16_t)((adcdebug >> 16UL) & 0x3FFUL); //10-bits
        q_pos = (uint16_t)((adcdebug >> 6UL) & 0x3FFUL);  //10-bits
#if (DWT_DEBUG_PRINT == 1)
        printf("Q- %02x, Q+ %02x == %04x - %04x + (%04x - %04x +)\n", iq_neg_th, iq_pos_th, q_neg, q_pos, q_neg_p, q_pos_p);
        deca_sleep(1U); // Necessary to allow UART to flush
#endif

        if (check_updated_th(q_neg, q_neg_p, &q_best_diff_n) != 0) //if true - new threshold gives closer statistics value to desired 511 - save it
        {
            final_thresholds &= ~((uint32_t)ADC_ZERO_THRESH_CFG_CFG_ZEROTH_THRESH_Q_NEG_BIT_MASK);
            final_thresholds |= iq_neg_th << ADC_ZERO_THRESH_CFG_CFG_ZEROTH_THRESH_Q_NEG_BIT_OFFSET;
        }

        if (dec_step != 0U) //if step not zero - adjust to see if stats will be better than previous
        {
            iq_neg_th = (uint32_t)calc_new_th((uint8_t)iq_neg_th, (uint32_t)q_neg, (int16_t)dec_step);
            neg_pos |= (iq_neg_th << TH_NEG_OFFSET); //set new/updated threshold
        }

        if (check_updated_th(q_pos, q_pos_p, &q_best_diff_p) != 0) //if true - new threshold gives closer statistics value to desired 511 - save it
        {
            final_thresholds &= ~((uint32_t)ADC_ZERO_THRESH_CFG_CFG_ZEROTH_THRESH_Q_POS_BIT_MASK);
            final_thresholds |= iq_pos_th << ADC_ZERO_THRESH_CFG_CFG_ZEROTH_THRESH_Q_POS_BIT_OFFSET;
        }

        if (dec_step != 0U) //if step not zero - adjust to see if stats will be better than previous
        {
            iq_pos_th = (uint32_t)calc_new_th((uint8_t)iq_pos_th, (uint32_t)q_pos, (int16_t)dec_step);
            neg_pos |= (iq_pos_th << TH_POS_OFFSET); //set new/updated threshold
        }

        q_neg_p = q_neg;  //update value for next run
        q_pos_p = q_pos;  //update value for next run
#if (DWT_DEBUG_PRINT == 1)
        printf("(%i) new Q- %02x, Q+ %02x\n", count, iq_neg_th, iq_pos_th);
        deca_sleep(1U); // Necessary to allow UART to flush
#endif

        q_neg_pos = neg_pos;
        iq_neg_th = (i_neg_pos >> TH_NEG_OFFSET) & 0xFFUL; //current negative threshold
        iq_pos_th = (i_neg_pos >> TH_POS_OFFSET) & 0xFFUL; //current positive threshold
        neg_pos = 0;
        {
            //get current statistics values
            adcdebug = dwt_read32bitoffsetreg(dw, ADC_DBG_ID, 0U);
            i_neg = (uint16_t)((adcdebug >> 12UL) & 0x3FFUL); //10-bits
            i_pos = (uint16_t)((adcdebug >> 2UL) & 0x3FFUL); //10-bits
#if (DWT_DEBUG_PRINT == 1)
            printf("I- %02x, I+ %02x == %04x - %04x + (%04x - %04x +)\n", iq_neg_th, iq_pos_th, i_neg, i_pos, i_neg_p, i_pos_p);
            deca_sleep(1U); // Necessary to allow UART to flush
#endif

            if (check_updated_th(i_neg, i_neg_p, &i_best_diff_n) != 0) //if true - new threshold gives closer statistics value to desired 511 - save it
            {
                final_thresholds &= ~((uint32_t)ADC_ZERO_THRESH_CFG_CFG_ZEROTH_THRESH_I_NEG_BIT_MASK);
                final_thresholds |= iq_neg_th << ADC_ZERO_THRESH_CFG_CFG_ZEROTH_THRESH_I_NEG_BIT_OFFSET;
            }

            if (dec_step != 0U) //if step not zero - adjust to see if stats will be better than previous
            {
                iq_neg_th = (uint32_t)calc_new_th((uint8_t)iq_neg_th, (uint32_t)i_neg, (int16_t)dec_step);
                neg_pos |= (iq_neg_th << TH_NEG_OFFSET); //set new/updated threshold
            }

            if (check_updated_th(i_pos, i_pos_p, &i_best_diff_p) != 0) //if true - new threshold gives closer statistics value to desired 511 - save it
            {
                final_thresholds &= ~((uint32_t)ADC_ZERO_THRESH_CFG_CFG_ZEROTH_THRESH_I_POS_BIT_MASK);
                final_thresholds |= iq_pos_th << ADC_ZERO_THRESH_CFG_CFG_ZEROTH_THRESH_I_POS_BIT_OFFSET;
            }

            if (dec_step != 0U) //if step not zero - adjust to see if stats will be better than previous
            {
                iq_pos_th = (uint32_t)calc_new_th((uint8_t)iq_pos_th, (uint32_t)i_pos, (int16_t)dec_step);
                neg_pos |= (iq_pos_th << TH_POS_OFFSET); //set new/updated threshold
            }

            i_neg_p = i_neg;  //update value for next run
            i_pos_p = i_pos;  //update value for next run

            i_neg_pos = neg_pos;
#if (DWT_DEBUG_PRINT == 1)
            printf("(%i) new I- %02x, I+ %02x\n", count, iq_neg_th, iq_pos_th);
            deca_sleep(1U); // Necessary to allow UART to flush
#endif
        }
#if (DWT_DEBUG_PRINT == 1)
        printf("(%i) final %08x\n", count, final_thresholds);
        deca_sleep(1U); // Necessary to allow UART to flush
#endif
    }

    dwt_write32bitoffsetreg(dw, ADC_THRESH_CFG_ID, 0U, final_thresholds);
#if (DWT_DEBUG_PRINT == 1)
    dwt_modify8bitoffsetreg(dw, MRX_CFG_ID, 0, 0xFE, 0); // Unfreeze
    dwt_modify8bitoffsetreg(dw, MRX_CFG_ID, 0, 0xFE, 1); // Freeze
    adcdebug = dwt_read32bitoffsetreg(dw, ADC_DBG_ID, 0U);
    i_neg = (adcdebug >> 12UL) & 0x3FFUL; //10-bits
    i_pos = (adcdebug >> 2UL) & 0x3FFUL; //10-bits
    adcdebug = dwt_read32bitoffsetreg(dw, ADC_DBG_ID, 2U);
    q_neg = (adcdebug >> 6UL) & 0x3FFUL;  //10-bits
    q_pos = (adcdebug >> 16UL) & 0x3FFUL; //10-bits
    printf("\nI stat: %04x %04x Q stat: %04x %04x\n", i_neg, i_pos, q_neg, q_pos);
    deca_sleep(1U); // Necessary to allow UART to flush
#endif

    // place device back to IDLE
    ull_forcetrxoff(dw);

    // Restore clocks
    ull_force_clocks(dw, FORCE_CLK_AUTO);

    //restore auto sequencing control of clocks and RF blocks
    dwt_or32bitoffsetreg(dw, SEQ_CTRL_ID, 0U, (SEQ_CTRL_AUTO_RX_SEQ_BIT_MASK | SEQ_CTRL_RF_CTRL_BIT_MASK | SEQ_CTRL_LDO_CTRL_BIT_MASK));

	// Disable LDOs for ADC blocks
    dwt_and32bitoffsetreg(dw, LDO_CTRL_ID, 0U,
        ~((uint32_t)((LDO_CTRL_LDO_VDDPLL_VREF_BIT_MASK | LDO_CTRL_LDO_VDDVCO_VREF_BIT_MASK | LDO_CTRL_LDO_VDDMS3_VREF_BIT_MASK | LDO_CTRL_LDO_VDDMS2_VREF_BIT_MASK | LDO_CTRL_LDO_VDDMS1_VREF_BIT_MASK) |
        (LDO_CTRL_LDO_VDDPLL_EN_BIT_MASK | LDO_CTRL_LDO_VDDVCO_EN_BIT_MASK | LDO_CTRL_LDO_VDDMS3_EN_BIT_MASK | LDO_CTRL_LDO_VDDMS2_EN_BIT_MASK | LDO_CTRL_LDO_VDDMS1_EN_BIT_MASK))));

    // Disable RF blocks for ADC (configure RF_ENABLE_ID reg)
	dwt_and32bitoffsetreg(dw, RF_ENABLE_ID,
			0U, ~((uint32_t)(RF_ENABLE_PLL_CH5_BIT_MASK | RF_ENABLE_PLL_RST_N_BIT_MASK | RF_ENABLE_PLL_EN_BIT_MASK |
        RF_ENABLE_ADCQ_EN_BIT_MASK | RF_ENABLE_ADCI_EN_BIT_MASK)));

    // restore modified registers
    dwt_write32bitoffsetreg(dw, AGC_CFG_ID, 0U, agc_def);
    dwt_write32bitoffsetreg(dw, ADC_CFG_ID, 0U, adc_def);

    // save final values into ADC_ZERO_THRESH_CFG
    dwt_write32bitoffsetreg(dw, ADC_ZERO_THRESH_CFG_ID, 0U, final_thresholds);

    return result;
}

/*! ------------------------------------------------------------------------------------------------------------------
 * @brief This API function writes the antenna delay (in time units) to RX registers
 *
 * input parameters:
 * @param dw      - DW3720 chip descriptor handler.
 * @param rxDelay - this is the total (RX) antenna delay value, which
 *                          will be programmed into the RX register
 *
 * output parameters
 *
 * no return value
 */
static void ull_setrxantennadelay(dwchip_t *dw, uint16_t rxDelay)
{
    // Set the RX antenna delay for auto TX timestamp adjustment
    dwt_write16bitoffsetreg(dw, CIA_CONF_ID, 0U, rxDelay);
}

/*! ------------------------------------------------------------------------------------------------------------------
 * @brief This API function reads the antenna delay (in time units) from the RX antenna delay register
 *
 * input parameters:
 * @param dw - DW3720 chip descriptor handler.
 *
 * output parameters
 *
 * returns 16-bit RX antenna delay value which is currently programmed in CIA_CONF_ID register
 */
static uint16_t ull_getrxantennadelay(dwchip_t* dw)
{
    // Get the RX antenna delay used for auto RX timestamp adjustment
    return dwt_read16bitoffsetreg(dw, CIA_CONF_ID, 0U);
}

/*! ------------------------------------------------------------------------------------------------------------------
 * @brief This API function writes the antenna delay (in time units) to the TX antenna delay register
 *
 * input parameters:
 * @param dw - DW3720 chip descriptor handler.
 * @param txDelay - this is the total (TX) antenna delay value, which
 *                          will be programmed into the TX delay register
 *
 * output parameters
 *
 * no return value
 */
static void ull_settxantennadelay(dwchip_t *dw, uint16_t txDelay)
{
    // Set the TX antenna delay for auto TX timestamp adjustment
    dwt_write16bitoffsetreg(dw, TX_ANTD_ID, 0U, txDelay);
}

/*! ------------------------------------------------------------------------------------------------------------------
 * @brief This API function reads the antenna delay (in time units) from the TX antenna delay register
 *
 * input parameters:
 * @param dw - DW3720 chip descriptor handler.
 *
 * output parameters
 *
 * returns 16-bit TX antenna delay value which is currently programmed in TX_ANTD_ID register
 */
static uint16_t ull_gettxantennadelay(dwchip_t* dw)
{
    // Get the TX antenna delay used for auto TX timestamp adjustment
    return dwt_read16bitoffsetreg(dw, TX_ANTD_ID, 0U);
}

/*! ------------------------------------------------------------------------------------------------------------------
 * @brief This API function writes the supplied TX data into the DW3000's
 * TX buffer.  The input parameters are the data length in bytes and a pointer
 * to those data bytes.
 *
 * input parameters
 * @param dw - DW3720 chip descriptor handler.
 * @param txDataLength   - This is the total length of data (in bytes) to write to the tx buffer.
 *                         Note: the size of tx buffer is 1024 bytes.
 *                         The standard PHR mode allows to transmit frames of up to 127 bytes (including 2 byte CRC)
 *                         The extended PHR mode allows to transmit frames of up to 1023 bytes (including 2 byte CRC)
 *                         if > 127 is programmed, DWT_PHRMODE_EXT needs to be set in the phrMode configuration
 *                         see dwt_configure function
 * @param txDataBytes    - Pointer to the users buffer containing the data to send.
 * @param txBufferOffset - This specifies an offset in the DW ICs TX Buffer at which to start writing data.
 *
 * output parameters
 *
 * returns DWT_SUCCESS for success, or DWT_ERROR for error
 */
static int32_t ull_writetxdata(dwchip_t *dw, uint16_t txDataLength, uint8_t *txDataBytes, uint16_t txBufferOffset)
{
#ifdef DWT_API_ERROR_CHECK
    assert((LOCAL_DATA(dw)->longFrames && (txDataLength <= EXT_FRAME_LEN)) || (txDataLength <= STD_FRAME_LEN));
    assert((txBufferOffset + txDataLength) < TX_BUFFER_MAX_LEN);
#endif

    if ((txBufferOffset + txDataLength) < TX_BUFFER_MAX_LEN)
    {
        if (txBufferOffset <= REG_DIRECT_OFFSET_MAX_LEN)
        {
            /* Directly write the data to the IC TX buffer */
            ull_writetodevice(dw, TX_BUFFER_ID, txBufferOffset, txDataLength, txDataBytes);
        }
        else
        {
            /* Program the indirect offset register A for specified offset to TX buffer */
            dwt_write32bitreg(dw, INDIRECT_ADDR_A_ID, (TX_BUFFER_ID >> 16UL));
            dwt_write32bitreg(dw, ADDR_OFFSET_A_ID, txBufferOffset);

            /* Indirectly write the data to the IC TX buffer */
            ull_writetodevice(dw, INDIRECT_POINTER_A_ID, 0U, txDataLength, txDataBytes);
        }
        return (int32_t)DWT_SUCCESS;
    }
    else
    {
        return (int32_t)DWT_ERROR;
    }
} // end ull_writetxdata()

/*! ------------------------------------------------------------------------------------------------------------------
 * @brief This API function configures the TX frame control register before the transmission of a frame
 *
 * input parameters:
 * @param dw - DW3720 chip descriptor handler.
 * @param txFrameLength - this is the length of TX message (including the 2 byte CRC) - max is 1023
 *                              NOTE: standard PHR mode allows up to 127 bytes
 *                              if > 127 is programmed, DWT_PHRMODE_EXT needs to be set in the phrMode configuration
 *                              see dwt_configure function
 * @param txBufferOffset - the offset in the tx buffer to start writing the data
 * @param ranging - 1 if this is a ranging frame, else 0
 *
 * output parameters
 *
 * no return value
 */
static void ull_writetxfctrl(dwchip_t *dw, uint16_t txFrameLength, uint16_t txBufferOffset, uint8_t ranging)
{
    uint32_t reg32;
#ifdef DWT_API_ERROR_CHECK
    assert((LOCAL_DATA(dw)->longFrames && (txFrameLength <= EXT_FRAME_LEN)) || (txFrameLength <= STD_FRAME_LEN));
#endif

    if (txBufferOffset <= 127U)
    {
        // Write the frame length to the TX frame control register
        reg32 = txFrameLength | ((uint32_t)(txBufferOffset) << TX_FCTRL_TXB_OFFSET_BIT_OFFSET) | ((uint32_t)ranging << TX_FCTRL_TR_BIT_OFFSET);
        dwt_modify32bitoffsetreg(dw, TX_FCTRL_ID, 0U, ~(TX_FCTRL_TXB_OFFSET_BIT_MASK | TX_FCTRL_TR_BIT_MASK | TX_FCTRL_TXFLEN_BIT_MASK), reg32);
    }
    else
    {
        // Write the frame length to the TX frame control register
        reg32 = txFrameLength | ((uint32_t)(txBufferOffset + DWT_TX_BUFF_OFFSET_ADJUST) << TX_FCTRL_TXB_OFFSET_BIT_OFFSET)
                | ((uint32_t)ranging << TX_FCTRL_TR_BIT_OFFSET);
        dwt_modify32bitoffsetreg(dw, TX_FCTRL_ID, 0U, ~(TX_FCTRL_TXB_OFFSET_BIT_MASK | TX_FCTRL_TR_BIT_MASK | TX_FCTRL_TXFLEN_BIT_MASK), reg32);
    }

} // end ull_writetxfctrl()

/*! ------------------------------------------------------------------------------------------------------------------
 * @brief This API function is used to configure frame preamble length, the frame premable length can be
 * configured in steps of 8, from 16 to 2048 symbols. If a non-zero value is configured, then the TXPSR_PE setting is ignored.
 *
 * input parameters:
 * @param dw - DW3720 chip descriptor handler.
 * @param preambleLength - sets the length of the preamble, value of 0 disables this setting and the length of the
 *                         frame will be dependent on the TXPSR_PE setting as configured by dwt_configure function
 * 
 * @note preambleLength is uint16_t only to keep compatibility with QM35xxx devices but cannot be > 0xFF.
 * 
 * Valid range for the preamble length code is [1..0xFF] which corresponds to [16..2048] symbols.
 * You can use convenience constants DWT_PLEN_32..DWT_PLEN_2048 defined for some
 * common preamble lengths. Note that setting preamble length smaller than 32 symbols
 * should be used for testing only and will likely result in poor performance.
 *
 * output parameters
 *
 * no return value
 */
static void ull_setplenfine(dwchip_t *dw, uint8_t preambleLength)
{
    dwt_write8bitoffsetreg(dw, TX_FCTRL_HI_ID, 1U, preambleLength);
}

/*! ------------------------------------------------------------------------------------------------------------------
 * @brief This is used to write the data from the RX scratch buffer, from an offset location given by offset parameter.
 *
 * input parameters
 * @param dw - DW3720 chip descriptor handler.
 * @param buffer - the buffer which to write to the device
 * @param length - the length of data to read (in bytes)
 * @param bufferOffset - the offset in the scratch buffer to which to write the data
 *
 * output parameters
 *
 * no return value
 */
static void ull_write_rx_scratch_data(dwchip_t *dw, uint8_t *buffer, uint16_t length, uint16_t bufferOffset)
{
    //!!Check later if needs range protection.

    /* Directly write data to the IC buffer */
    ull_writetodevice(dw, SCRATCH_RAM_ID, bufferOffset, length, buffer);
}

/*! ------------------------------------------------------------------------------------------------------------------
 * @brief This is used to read the data from the RX scratch buffer, from an offset location given by offset parameter.
 *
 * input parameters
 * @param dw - DW3720 chip descriptor handler.
 * @param buffer - the buffer into which the data will be read
 * @param length - the length of data to read (in bytes)
 * @param bufferOffset - the offset in the scratch buffer from which to read the data
 *
 * output parameters
 *
 * no return value
 */
static void ull_read_rx_scratch_data(dwchip_t *dw, uint8_t *buffer, uint16_t length, uint16_t rxBufferOffset)
{
    //!!Check later if needs range protection.

    /* Directly read data from the IC buffer */
    ull_readfromdevice(dw, SCRATCH_RAM_ID, rxBufferOffset, length, buffer);
}

/*! ------------------------------------------------------------------------------------------------------------------
 * @brief This is used to read the data from the RX buffer, from an offset location give by offset parameter
 *
 * input parameters
 * @param dw - DW3720 chip descriptor handler.
 * @param buffer - the buffer into which the data will be read
 * @param length - the length of data to read (in bytes)
 * @param rxBufferOffset - the offset in the rx buffer from which to read the data
 *
 * output parameters
 *
 * no return value
 */
static void ull_readrxdata(dwchip_t *dw, uint8_t *buffer, uint16_t length, uint16_t rxBufferOffset)
{
    uint32_t rx_buff_addr;

    if (LOCAL_DATA(dw)->dblbuffon == (uint8_t)DBL_BUFF_ACCESS_BUFFER_1) // if the flag is 0x3 we are reading from RX_BUFFER_1
    {
        rx_buff_addr = RX_BUFFER_1_ID;
    }
    else // reading from RX_BUFFER_0 - also when non-double buffer mode
    {
        rx_buff_addr = RX_BUFFER_0_ID;
    }

    if ((rxBufferOffset + length) <= RX_BUFFER_MAX_LEN)
    {
        if (rxBufferOffset <= REG_DIRECT_OFFSET_MAX_LEN)
        {
            /* Directly read data from the IC to the buffer */
            ull_readfromdevice(dw, rx_buff_addr, rxBufferOffset, length, buffer);
        }
        else
        {
            /* Program the indirect offset registers B for specified offset to RX buffer */
            dwt_write32bitreg(dw, INDIRECT_ADDR_A_ID, (rx_buff_addr >> 16UL));
            dwt_write32bitreg(dw, ADDR_OFFSET_A_ID, rxBufferOffset);

            /* Indirectly read data from the IC to the buffer */
            ull_readfromdevice(dw, INDIRECT_POINTER_A_ID, 0U, length, buffer);
        }
    }
}

/*! ------------------------------------------------------------------------------------------------------------------
 * @brief This is used to read the 18 bit data from the Accumulator buffer, from an offset location give by offset parameter
 *        for 18 bit complex samples, each sample is 6 bytes (3 real and 3 imaginary)
 *
 *
 * NOTE: Because of an internal memory access delay when reading the accumulator the first octet output is a dummy octet
 *       that should be discarded. This is true no matter what sub-index the read begins at.
 *
 * input parameters
 * @param dw - DW3720 chip descriptor handler.
 * @param buffer - the buffer into which the data will be read
 * @param length - the length of data to read (in bytes)
 * @param accOffset - the offset in the acc buffer from which to read the data, this is a complex sample index
 *                    e.g. to read 10 samples starting at sample 100
 *                    buffer would need to be >= 10*6 + 1, length is 61 (1 is for dummy), accOffset is 100
 *
 * output parameters
 *
 * no return value
 *
 * @deprecated This function is now deprecated for new development. Plase use @ref dwt_readcir or @ref dwt_readcir_48b
 */
static void ull_readaccdata(dwchip_t *dw, uint8_t *buffer, uint16_t length, uint16_t accOffset)
{
    // Force on the ACC clocks if we are sequenced
    dwt_or16bitoffsetreg(dw, CLK_CTRL_ID, 0x0U, CLK_CTRL_ACC_MCLK_EN_BIT_MASK | CLK_CTRL_ACC_CLK_EN_BIT_MASK);

    if ((accOffset + length) <= ACC_BUFFER_MAX_LEN)
    {
        if (accOffset <= REG_DIRECT_OFFSET_MAX_LEN)
        {
            /* Directly read data from the IC to the buffer */
            ull_readfromdevice(dw, ACC_MEM_ID, accOffset, length, buffer);
        }
        else
        {
            /* Program the indirect offset registers B for specified offset to ACC */
            dwt_write32bitreg(dw, INDIRECT_ADDR_A_ID, (ACC_MEM_ID >> 16UL));
            dwt_write32bitreg(dw, ADDR_OFFSET_A_ID, accOffset);

            /* Indirectly read data from the IC to the buffer */
            ull_readfromdevice(dw, INDIRECT_POINTER_A_ID, 0U, length, buffer);
        }
    }
    else
    {
        assert(1 == 0);
    }

    // Revert clocks back
    dwt_and16bitoffsetreg(dw, CLK_CTRL_ID, 0x0U, (uint16_t) ~(CLK_CTRL_ACC_MCLK_EN_BIT_MASK | CLK_CTRL_ACC_CLK_EN_BIT_MASK));
}
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
