WaltTeb/BareTag_Tool_Tracker/Updated_Firmware/example_selection.h

/*! ----------------------------------------------------------------------------
 * @file    example_selection.h
 * @brief   Example selection is configured here
 *
 * @attention
 *
 * Copyright 2013 - 2021(c) Decawave Ltd, Dublin, Ireland.
 *
 * All rights reserved.
 *
 */

 #ifndef TEST_SELECTION_
 #define TEST_SELECTION_
 
 // #define TEST_SS_TWR_RESPONDER // The code we are using for our Tags
 
 #define UART_TEST // Put random numbers out over UART
 
 //#define TWR_UART_TEST // The file for anchors
 
 // #define TEST_TWI_ACC
 
 #endif
 
