WaltTeb/BareTag_Tool_Tracker/(commit log)

2024-10-23 Add PCB folder. This includes the KiKad folders and some of the custom content that I have made
    [Board Outline.gbr, Board.gbr, BoardOutline.gbr, Bottom Assy.gbr, Bottom Mask.gbr, Bottom Paste.gbr, Bottom Silk.gbr, Bottom.gbr]
2024-10-24 updated anchor pcb + DWM Datasheet
    [tag.kicad_pcb]
2024-10-24 pcb stuff
    [tag.kicad_sch]
2024-10-24 updated Tag PCB
    [tag.kicad_sch]
2024-10-25 Tag and Anchor schematic updates
    [anchor.kicad_sch, tag.kicad_sch]
2024-10-25 maybe updates?
    [tag.kicad_sch]
2024-10-25 PCB updates
    [anchor.kicad_sch, tag.kicad_sch]
2024-10-25 added .gitignore to the PCB directory
2024-10-29 this is the newest folder status
    [anchor.kicad_sch, tag.kicad_sch]
2024-10-29 added footprint folder and footprints to the cap's
    [GRM1555C1H470JA01D.step, GRM155C80J225KE95D.step, GRM155R60J106ME05D.step, GRM155R71C104KA88J.step, anchor.kicad_sch]
2024-10-31 updated pcb for anchor
    [DWM3001C.step, RC0402FR-07100KL.step, RC0402FR-07150RL.step, RC0402FR-07820KL.step, RK73B1ETTP182J.step, RT0402BRD071K5L.step, S2B-PH-SM4-TB.step, TL3315NF160Q.step]
2024-11-01 final tag
    [tag.kicad_pcb, tag.kicad_sch]
2024-11-01 anchor PCB v1
    [APHBM2012.STEP, anchor.kicad_pcb]
2024-11-01 pdf file of anchor pics
    [anchor.kicad_pcb]
2024-11-17 added openhaystack related materials and important firmwares. Will be changing readmes and organizing stuff fr later
    [with_key.csv]
2025-01-30 new pcb
    [tag-B_Cu.gbl, tag-B_Cu.gbr, tag-B_Mask.gbr, tag-B_Mask.gbs, tag-B_Paste.gbp, tag-B_Paste.gbr, tag-B_Silkscreen.gbo, tag-B_Silkscreen.gbr]
2025-02-01 idk, connor did PCB stuff
2025-02-01 kicad readme
2025-02-02 PCB folder organization
    [54202-T0804LF.step, Adafruit CP2102N Friend.kicad_pcb, Adafruit CP2102N Friend.kicad_sch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]
2025-02-02 got UART RX working
2025-02-04 toggle led on interrupt
2025-02-04 include fixes and gitignore updates
    [example_selection.h, twi_acc_test.c]
2025-02-10 actual working pcb backups
    [donglev1.kicad_pcb, donglev1.kicad_sch, tag_connect.kicad_sch, tagv2.kicad_pcb, tagv2.kicad_sch]
2025-02-22 other firmware testing
    [donglev1.kicad_pcb, donglev1.kicad_sch]
