WaltTeb/BareTag_Tool_Tracker/(notices)

Notices in the files:
Updated_Firmware/main.c:
(c) 2014 - 2020 SEGGER Microcontroller GmbH
All rights reserved.
PCB/anchor/footprints/TSM_102_01_L_SV/TSM-102-01-X-SV.step:
author */ ('License CC BY-ND 4.0'),
